2AMLogic/sky130-temp-por/spec/README.md

# spec

- [`porting-plan.md`](porting-plan.md) — what carries over from
  [`gf180-temp-por`](https://github.com/2AMLogic/gf180-temp-por)'s
  architecture and spec structure, what must be re-derived against sky130
  device models, and the PVT/ramp-rate testbench matrix the POR and sensor
  testbenches must cover before design starts. The first deliverable this
  repo produces — see the repo README and `CLAUDE.md`.
- [`decision-records/`](decision-records/) — one file per decision, using
  the format in `decision-records/TEMPLATE.md`. `DR-001` and `DR-002` are
  the two decisions the porting plan above required (supply flavor,
  architecture carryover); `DR-003` recommends the values for a future
  ratified `target-spec.md`, reconciled against the `sim/` evidence
  gathered since. `DR-001` and `DR-002` are `proposed`; `DR-003` is
  `ratified` (two-key path, issue #78), scoped to row 1 (operating
  temperature, −40…+125 °C) and row 6 (supply, 2.97–3.63 V per `DR-001`)
  only. All other rows stay `[TBD]` placeholders. `DR-006` is `proposed`
  (recommendation only, issue #136): it finds the Iq rows `[TBD-4..6]` not yet
  recommendable from the committed `sim/iq-top` evidence (17 of 45 iq-total
  points non-`ok`) and names the missing experiments.
- [`ratification/`](../ratification/) — the two-key ratification process
  (`market-key`, `ee-key`) `DR-003`'s recommendation and any future
  `target-spec.md` ratification goes through.

No `target-spec.md` exists yet — per the porting plan §4, that is a future
deliverable, populated from device-characterization evidence rather than
asserted ahead of it.
