2AMLogic/sky130-temp-por/design/temp_core.md

# `temp_core` — PTAT/CTAT temperature-sensing core (sky130 port)

Sky130 port of
[gf180-temp-por's `design/temp_core.sch`](https://github.com/2AMLogic/gf180-temp-por/blob/main/design/temp_core.md)
(issue #9 there), landed by issue #7 here as sub-issue 2 of 5 of the
T1-item-1 decomposition (see #5), depending on `bias_core` (issue #6).
Topology per
[DR-005](https://github.com/2AMLogic/gf180-temp-por/blob/main/spec/decision-records/DR-005-temp-por-architecture-survey.md)
("plain, not chopped, single-point 25 °C gain trim"), carried into this repo
by [DR-002](../spec/decision-records/DR-002-architecture-carryover.md);
device mapping per `spec/porting-plan.md` §2.2 and
[DR-001](../spec/decision-records/DR-001-supply-flavor.md).

**This is a mechanical, first-order port, not a characterized design.** See
[Scope and what this is not](#scope-and-what-this-is-not) before reading
anything below as a verified number.

## What this cell is

Unchanged in shape from gf180's `temp_core`: a ΔVBE/VBE bandgap-style
temperature-sensing core, deliberately left uncompensated so the PTAT term
is published raw. An 8:1 emitter-area vertical-PNP pair (`XQ1` : 1x,
`XQ8A..XQ8H` : 8x in parallel) sets `DVBE = (kT/q)*ln(8)`; an error amplifier
forces `V(NA) = V(NB)` so the branch current is `I = DVBE/R1` (PTAT by
construction); a matched third mirror leg drops that same current through
`R2` (fixed) + `R2TRIM` (the wave-1 single-point trim leg — see
[Trim mechanism](#trim-mechanism-simplified-for-this-port) below) into `VSS`,
giving `V(PTAT) = ((R2+R2TRIM)/R1)*(kT/q)*ln(8)`. `V(CTAT)` is `XQ1`'s own
`VEB` (the same node the branch-A leg drives), tapped out through a series
isolation resistor (`XRISO`) so pad capacitance never loads the loop node
directly. The cell has its own startup-kick/enable-gating band (current-
referenced dead-loop detector, the same class of mechanism `bias_core` uses)
and disable clamps so a disabled cell floats cleanly rather than leaking.
Everything below is a direct translation of gf180's own `design/temp_core.md`
topology description onto sky130 devices; read that document for the full
circuit-theory argument — none of the *architecture* is device-specific, so
it is not re-derived here.

## Interface

| Pin | Dir | Meaning |
| --- | --- | --- |
| `VDD`, `VSS` | inout | 3.3 V nominal supply pair on sky130 5V I/O-class devices (`g5v0d10v5`), 2.97–3.63 V ([DR-001](../spec/decision-records/DR-001-supply-flavor.md)), matching `bias_core` |
| `IBIAS` | in | shared bias-mirror node from `bias_core`. Per [DR-010](https://github.com/2AMLogic/gf180-temp-por/blob/main/spec/decision-records/DR-010-shared-ibias-disabled-consumer-contract.md) (carried from gf180, documented on `bias_core`'s own interface too): this pin is **high-Z, never clamped**, when the cell is disabled — a clamp here would starve the shared node for the entire pre-POR window |
| `EN` | in | enable, active high. Intended to be driven from `RESETn` once `temp_por_top` exists (issue #10), so the sensor is enabled only after POR releases (DR-002 startup ordering) — wired here per issue #7's own guidance even though the driving `RESETn` signal is not yet a committed cell. `EN` low: mirror gate `PG` to `VDD`, local bias node `NBG` to `VSS`, `PTAT`/`CTAT` pulled to `VSS`, `IBIAS` left high-Z |
| `PTAT` | out | analog PTAT output ([DR-002](../spec/decision-records/DR-002-architecture-carryover.md)). No output buffer in this cell (gf180's own `temp_buffer` is a separate, not-yet-ported cell) — a consuming testbench must specify a high-impedance load |
| `CTAT` | out | analog CTAT output (DR-002) = `VEB` of `XQ1`, tapped through `XRISO` |

## Device mapping (`spec/porting-plan.md` §2.2 / DR-001)

| Role | gf180 device | sky130 device | Notes |
| --- | --- | --- | --- |
| Amplifier, mirror, startup-kick, enable-gating MOS | `pfet_03v3`/`nfet_03v3` | `sky130_fd_pr__pfet_g5v0d10v5`/`nfet_g5v0d10v5` | Same 4-terminal (D,G,S,B) pin order as `bias_core`'s own devices, matching gf180's own pin layout — mechanical port. |
| VBE/ΔVBE sensing (8:1 ratio pair) | `pnp_10p00x10p00` | `sky130_fd_pr__pnp_05v5_W3p40L3p40` | Same choice as `bias_core` (issue #6): built as **eight parallel `X` instances**, not one `m`/`mult`-scaled instance — `mult` only scales sky130's PNP mismatch terms, not `Is`. |
| PTAT-gain resistor (`R1`, `R2`, `R2TRIM`), Miller-comp resistor (`RZ`), CTAT isolation (`RISO`) | `ppolyf_u` | `sky130_fd_pr__res_xhigh_po` | Same flavor `bias_core` uses for its own `R1`/`R2`/`RT`; `VREF`-independent ratio-tracking legs, so the flavor's absolute-TC spread cancels in-ratio. |
| Miller compensation cap (`CC`) | `cap_mim_2f0_m3m4_noshield` | `sky130_fd_pr__cap_mim_m3_1` | Same choice as `bias_core`. |

## Trim mechanism (simplified for this port)

gf180's own `temp_core` carries a **6-bit binary-weighted** trim ladder
(`R2T5..R2T0`) on the PTAT gain resistor, shorted segment-by-segment by
metal-strapped `nfet` switches — a metal-1 mask option, fuse/OTP-ready for
later, per gf180's own comment: *"a layout/process-portable mechanism, not a
device threshold"* (`spec/porting-plan.md` §1.1). Per issue #7's own scope
("represent as a trim node in the schematic; the physical strap-ladder
itself is layout scope"), this port collapses that to the **one net** a
layout-time metal strap would actually land on:

```
PTAT --[ R2 ]-- PTAT_TRIM --[ R2TRIM ]-- VSS
```

`R2` carries gf180's `R2F` value; `R2TRIM` carries the **sum** of gf180's
six segments (`R2T5+R2T4+R2T3+R2T2+R2T1+R2T0`), so the total (untrimmed)
`R2+R2TRIM` matches gf180's total gain resistor exactly, and the full trim
**range** a layout-time strap could remove is preserved — just as one
segment instead of six. `PTAT_TRIM` is left floating (untrimmed) in this
schematic; no switch transistors are instantiated. Sizing the physical
strap-ladder itself (bit count, granularity, the actual trim code) is layout
scope, deferred to a future issue.

## Sizing

**Every drawn `W`/`L` is carried over unchanged from gf180's ratified
`temp_core`** (bare micron numbers per this repo's own sky130 unit
convention — see `design/README.md`), same convention as `bias_core`
(issue #6):

- Ratio-derived quantities are exactly preserved by construction: the 8:1
  PNP emitter-count ratio, `RZ`/`R1`, and (per the simplified trim mechanism
  above) `(R2+R2TRIM)/R1` = (2652.6+450.88)/119.47 = 25.966, identical to
  gf180's own untrimmed `R2(nominal)/R1` ratio.
- The **absolute** PTAT slope, CTAT intercept, startup margins and
  compensation all depend on sky130's actual PNP `Is`/`BF`, MOS
  transconductance/threshold and resistor sheet resistance — none of which
  have been characterized against sky130 models in this repo yet
  (`spec/porting-plan.md` §2.5/§4 item 2). Per §1.3: this exact topology, on
  gf180mcu itself, measured **outside** its own accuracy targets under
  3-sigma mismatch
  ([DR-011-temp-accuracy-mismatch-not-met](https://github.com/2AMLogic/gf180-temp-por/blob/main/spec/decision-records/DR-011-temp-accuracy-mismatch-not-met.md)) —
  carrying the topology here is not a presumption it clears sky130's
  (not-yet-derived) accuracy target either.

## Verification done for this issue

Non-goals for issue #7 explicitly exclude layout, DRC/LVS, PVT corner
verification, Monte Carlo, characterization-grade sizing, and the physical
trim-strap ladder. What **is** verified here, as evidence the port is wired
correctly rather than merely textually plausible:

- `python3 design/netlist.py --cell temp_core` exports
  `design/netlist/temp_core.spice` with no xschem ERC/export errors.
- `python3 design/netlist.py --check` passes: both committed netlists
  (`bias_core`, `temp_core`) reproduce byte-for-byte and the
  symbol-pins-match-schematic-ports invariant holds for each.

### Branch selection: full-PVT transient evidence (issue #22), not a cold `.op` spot check

This section previously reported a 9-point cold-`.op` spot check (`tt`/`ff`/`ss`
× −40/27/125 °C, `EN` = `VDD`, `IBIAS` shared with a co-instantiated
`bias_core`) as evidence the ΔVBE loop reaches its intended branch. Issue #22
retired that method for `temp_core`, for exactly the reason
[issue #19](https://github.com/2AMLogic/sky130-temp-por/issues/19) retired it
for `bias_core`: a cold `.op` has no initial state, so which branch ngspice
reports is chosen by its own convergence-aid continuation rather than by the
circuit (see `sim/README.md` §"Branch selection" for the full house
methodology). The 9-point table is gone from this document; it is not a
retraction of the numbers (they were plausible and self-consistent), only of
the *claim* that a cold `.op` can establish which branch they came from.

The replacement is a physical `tran … uic` supply ramp from 0 V, run over the
full 45-point PVT matrix, in two scenarios (the `EN` axis `bias_core` does not
have):

- **`sim/temp-core-startup/`** — `EN` tied to `VDD`, asserted for the entire
  power-up ramp. Record
  [`20260826-053032-ee63b45`](../sim/temp-core-startup/records/20260826-053032-ee63b45.md):
  **42/45 PASS**. `PTAT` rises and `CTAT` falls monotonically with
  temperature at every passing corner, matching the previous spot check's
  values closely (e.g. `tt`/27 °C: `PTAT` = 1.414 V, `CTAT` = 0.658 V here vs.
  1.414 V / 0.658 V in the retired table) — the topology-correctness
  conclusion the old table supported still holds, now on firmer evidence.
  Three corners FAIL — `tt_-40c_3.30v`, `tt_125c_3.30v`, `ff_-40c_3.30v`, all
  at exactly the matrix's nominal 3.30 V supply point — with the same
  non-physical signature issue #19 used to prove the analogous `bias_core`
  artifact was a solver artifact rather than a second stable state: a
  negative settled supply current on one, and `PTAT` railed far outside
  every other corner's range (as far as +5 V, or negative) on the others,
  caught by this experiment's own `isup`-sign and `PTAT`-range guards. See
  that record's own manifest (`sim/temp-core-startup/experiment.json`
  `notes`) for the numerical-settings investigation behind that conclusion:
  re-running those three corners at a tighter tolerance recovers the intended
  branch, but re-running the *whole* matrix at that tighter tolerance moves
  the failure to a different, non-overlapping set of six corners — the same
  "change the solver, the failing set changes" signature `sim/bias-core-op-branch/`
  measured for `bias_core`, not a fixed defect at 3.30 V specifically.
- **`sim/temp-core-startup-en-delayed/`** — `VDD` ramps identically, but `EN`
  is held low until well after the supply has settled, then released — the
  DR-002 startup ordering `temp_core` will actually see once `temp_por_top`
  drives it from `RESETn`. Record
  [`20260826-054047-ee63b45`](../sim/temp-core-startup-en-delayed/records/20260826-054047-ee63b45.md):
  **42/45 PASS**, 3 different FAILing corners
  (`tt_27c_3.63v`, `tt_125c_3.63v`, `sf_-40c_2.97v`), same non-physical
  signature (negative supply current and/or a railed `PTAT`/`CTAT`), caught
  by the same guards. `temp_core`'s own startup kick clears the degenerate
  zero-current branch on a late `EN` release at the large majority of PVT
  points, not just when enabled for the whole ramp.

**Neither record is a claim that `temp_core` has a startup defect**, and
neither is edited or re-run to force a pass — per `sim/README.md`'s
append-only rule, a FAIL a full PVT sweep actually found is committed
evidence, not a blocker. Both FAILing sets show the textbook non-physical
signature (impossible supply-current sign, or a loop node/output railed
outside anything a passive network biased between `VSS` and `VDD` can
produce) that issue #19 established discriminates a solver artifact from a
real second equilibrium for this class of self-biased ΔVBE cell, and the set
of affected corners is not stable across reasonable changes to the
transient's own numerical settings — the same "solver-dependent, not
circuit" pattern `sim/bias-core-op-branch/` measured directly for `bias_core`.
The follow-up numerics sweep has since been run as
`sim/temp-core-startup-solver/` (issue #86): none of the six FAIL points
re-landed on the current netlist under any solver/ramp variant tested —
including the `base` deck control, which removes the deck-difference
alternative — every failure the sweep did produce is non-physical, and no
real failure was found anywhere in the matrix (record
[`20261010-200708-47b96e5`](../sim/temp-core-startup-solver/records/20261010-200708-47b96e5.md),
superseding `20261010-100955-292949a`).

## Scope and what this is not

Per issue #7's non-goals: **not** layout, DRC/LVS, PVT corner verification,
Monte Carlo, characterization-grade sizing, or the physical trim-strap
ladder (see [Trim mechanism](#trim-mechanism-simplified-for-this-port)
above). Re-sizing once sky130 device characterization lands
(`spec/porting-plan.md` §4 item 2) is expected follow-on work, not a defect
in this port — do not read any voltage, slope or current figure in this
document as a ratified or even provisional target; `spec/target-spec.md`
does not exist yet in this repo (`spec/porting-plan.md` §4 item 4).
