2AMLogic/sky130-temp-por/WORK_PLAN.md

# Work Plan

Current roadmap derived from GitHub label state. The region below is maintained by the Loom Guide role.

<!-- guide:plan-body:start -->
## Operator Attention: Merge-Risk-Hold Pileup

Judge-approved PRs under a hold (`loom:blocked` or `loom:operator`) — only a human merge decision is missing.

_None._

## Very Important

`loom:very-important` (one counts per workspace); every stage takes these first.

_None._

## Important

`loom:important`; taken before unlabelled work.

_None._

## Ready

Human-approved issues ready for implementation (`loom:issue`).

- **#191**: Remove docs/guard-repro reproducer: stale, unreferenced test of a Loom-managed hook

## In Progress

Issues currently being built (`loom:building`).

- **#284**: sim: measure DR-007's degenerated-mirror projection with a mirror-term MC variant run

## PRs Awaiting Review

PRs waiting on Judge (`loom:review-requested`).

_None._

## Approved (Awaiting Merge)

PRs that passed review and are queued for Champion auto-merge (`loom:pr`).

_None._

## Proposed

Issues carrying `loom:curated`.

- **#4**: Track the gap to T1 sim-validated / bronze (klayout-tools design-evidence tiers) *(curated)*
- **#97**: Lay out por_output_chain as the next DRC/LVS-verified POR leaf *(curated)*
- **#153**: brownout-top: re-grade NONPHYSICAL brown-out points with a tightened-solver fleet re-run *(curated)*
- **#181**: glitch-top: re-run failed vdd_level request vdd_slew_v1.2_h0.0002_s200000 (45 ERROR points) *(curated)*
- **#189**: Re-qualify cited sky130 evidence under open_pdks f6eeac7 (split from #188) *(curated)*
- **#191**: Remove docs/guard-repro reproducer: stale, unreferenced test of a Loom-managed hook *(curated)*
- **#284**: sim: measure DR-007's degenerated-mirror projection with a mirror-term MC variant run *(curated)*

## Proposed (Architect / Hermit)

- **#137**: Run the two-key ratification ceremony on DR-004 and DR-005 *(architect)*

## Epics

- **#4**: Track the gap to T1 sim-validated / bronze (klayout-tools design-evidence tiers)

## Backlog Balance

| Bucket | Count |
|---|---|
| Operator merge-risk holds | 0 |
| Very important | 0 |
| Important | 0 |
| Ready (`loom:issue`) | 1 |
| In Progress (`loom:building`) | 1 |
| PRs awaiting review | 0 |
| Approved PRs awaiting merge | 0 |
| Curated | 7 |
| Architect / Hermit proposals | 1 |
| Active epics | 1 |
<!-- guide:plan-body:end -->
