2AMLogic/sky130-temp-por/manifests/artifacts/glitch-top-20261113-082829-da28d31-vdd_level-rerun181.summary.md

# Stored evidence: glitch-top / 20261113-082829-da28d31-vdd_level-rerun181

Raw outputs are in the fleet artifact store (private); this summary and
`glitch-top-20261113-082829-da28d31-vdd_level-rerun181.manifest.json` are the committed record. Check the bytes
with `klt artifact verify manifests/artifacts/glitch-top-20261113-082829-da28d31-vdd_level-rerun181.manifest.json`.

| name | size (bytes) | sha256 |
|---|---:|---|
| `sim/.work/.stage/glitch-top/20261113-082829-da28d31-vdd_level-rerun181/vdd_slew_v1.2_h0.0002_s200000/ff_-40c_2.97v.log` | 6429 | `05fcc509f06a0b0329f5d6170ae3cead8c08df4df788f5f16296d26571690c44` |
| `sim/.work/.stage/glitch-top/20261113-082829-da28d31-vdd_level-rerun181/vdd_slew_v1.2_h0.0002_s200000/ff_-40c_2.97v.trace.csv.gz` | 3619 | `1fba09b0852c2e07f1603e4c9942d356a4d9621a56d4e5da9ca1e6318bb8a1bd` |
| `sim/.work/.stage/glitch-top/20261113-082829-da28d31-vdd_level-rerun181/vdd_slew_v1.2_h0.0002_s200000/ff_-40c_3.30v.log` | 6429 | `e192acfe9f427a0010f5f91e1e251b4c581f8494c019e1e538131d7f61810195` |
| `sim/.work/.stage/glitch-top/20261113-082829-da28d31-vdd_level-rerun181/vdd_slew_v1.2_h0.0002_s200000/ff_-40c_3.30v.trace.csv.gz` | 3845 | `41f2ee7448445d5f04d06677372713f7a5353468ea329cacd7c6c7f49039e3c3` |
| `sim/.work/.stage/glitch-top/20261113-082829-da28d31-vdd_level-rerun181/vdd_slew_v1.2_h0.0002_s200000/ff_-40c_3.63v.log` | 6430 | `b0a8ba8f35210c539fea7abc34406f49456061d0387ca0e15f699d3141d2916a` |
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
| `sim/.work/.stage/glitch-top/20261113-082829-da28d31-vdd_level-rerun181/vdd_slew_v1.2_h0.0002_s200000/tt_27c_3.63v.trace.csv.gz` | 5135 | `4e996fe1bf50d0cbd19262e184f64ce5dadb78d6a44e1b736044b76ee3dbc2fe` |
