2AMLogic/sky130-temp-por/sim/pnp-mismatch/records/20261113-160939-9211b20a.md

# Record 20261113-160939-9211b20a

- **Record ID**: 20261113-160939-9211b20a
- **Experiment**: `pnp-mismatch` — Substrate PNP pair mismatch -- sigma(dVBE) by local + global-process Monte Carlo
- **Claim**: Issue #17 -- sim-harness port. Confirms sky130's local-mismatch (MC_MM_SWITCH=1) AND global-process-Monte-Carlo (MC_PR_SWITCH=1) mechanisms both produce non-degenerate samples against THIS repo's own PNP topology -- a single `sky130_fd_pr__pnp_05v5_W3p40L3p40` vs. the real 1-vs-8-parallel array bias_core/temp_core actually use, not a re-run of sky130-bandgap's own small/large device-size pair. **This record makes no spec pass/fail claim** -- no ratified spec exists yet (spec/porting-plan.md Sec4 item 4); it reports measured distributions plus the harness checks that make them trustworthy, per issue #17's own acceptance criteria.
- **Netlist provenance**: schematic (`sim/pnp-mismatch/testbench/tb_pnp_mismatch.spice`)
- **PDK**: sky130A @ open_pdks `f6eeac7dad085ffcc829ccfd721f7b4ce39edcf7` (matches sim/pdk.json pin); models `$PDK_ROOT/sky130A/libs.tech/combined/sky130.lib.spice`
- **Tools**: ngspice-47 : Circuit level simulation program (host; the grid ran on the fleet); XSCHEM V3.4.7; Linux 7.0.0-1014-aws x86_64
- **Repo state**: `9211b20a` on `feature/issue-319` (clean working tree)
- **Backend**: `klt sim --backend batch` deck-list request (fleet job `klt-sim-24f5caeb77f1`, m7i.4xlarge in us-east-1, report status `pass`: 6/6 unit(s) passed, 0 errored, 0 timed out); fleet runner klt `0.9.0`, client `klt 0.9.2.dev887+gec7400b7d8e5`, `--wait-for-capacity 600`
- **Fleet engine**: ngspice-47 (per-point, from each unit's own log banner)
- **Sampling method**: in-deck `.control` dowhile/reset loop inside ONE ngspice process, seeded by `setseed $mc_seed` from the shipped `.spiceinit` -- the SAME method this experiment's earlier records were minted by, carried to the fleet unchanged by the `decks[]` transport rather than re-expressed as a klt `monte_carlo` block (which would draw the samples differently; issue #319 risk item 2)
- **Transport**: submitted as a `klt sim` deck-list (`decks[]`) request, the transport klt documents for a harness that renders its own decks and mints its own evidence from the raw logs (klayout-tools #2804): each point's deck is shipped byte-for-byte and run as `ngspice -b <deck>` in its own directory on the fleet worker, so the artifact is the one this harness mints rather than one klt re-composed from a corner axis. The per-point `.spiceinit` rides as a `decks[].inputs[]` entry, which is how a setting the fleet drops from `options.ngspice_init` still reaches the run
- **Corner matrix run**:
  - Process: `tt_mm` (local mismatch, MC_MM_SWITCH=1), `tt` (control, both switches 0), `mc` (global process Monte Carlo, MC_PR_SWITCH=1) -- see the module docstring for why local mismatch is not stacked on the deterministic tt/ss/ff/sf/fs process axis (would double-count the global spread a future characterization issue's own process-corner sweep already records).
  - Temperature: -40 °C, 27 °C, 125 °C (full CLAUDE.md temperature axis for the local-mismatch sweep; the process-mc liveness point runs at 27 °C only)
  - Supply: **not applicable**. Every DUT is a diode-connected substrate PNP referred to its own emitter node and biased by an ideal current source; there is no supply-referenced terminal. Point ids carry `nosupply` in the supply field.
  - 6 ngspice points executed: 3 local-mismatch Monte Carlo points (N = 300 each), one MC_MM_SWITCH/MC_PR_SWITCH-off control point, one second-seed point, one MC_PR_SWITCH=1 liveness point.
- **Statistical convention**: **N = 300** Monte Carlo samples per local-mismatch temperature point (section `tt_mm`: `MC_MM_SWITCH=1`, `MC_PR_SWITCH=0`, `mismatch_factor=1`); the `mc` liveness point uses N = 30. Spread is reported as **1 σ** sample standard deviation (N−1). Reproducible: `setseed 20260825` (the second-seed point uses 20260826).
- **Result**: PASS — see the tables below.

## What the sky130 PDK actually does for BJT mismatch / process Monte Carlo

Verified against the pinned PDK (already confirmed once, on the same PDK pin, by sky130-bandgap's own sim/pnp-mismatch/). In `libs.tech/combined/continuous/models_bjt.spice` each PNP subcircuit carries a **per-instance** mismatch term gated by `MC_MM_SWITCH`:

```
.param mm_is = {sw_mm_sky130_fd_pr__pnp_05v5_W0p68L0p68_is
               * mismatch_factor * MC_MM_SWITCH * AGAUSS(0,1.0,1)/sqrt(mult)}
  is  = '... * (1+mm_is)'   (W3p40L3p40 scales the W0p68L0p68 coefficient by 0.13)
```

with the sigmas in `continuous/models_global.spice`: `..._is = 1.662e-02` (1.662% on Is) and `..._bf = 5.537e-02` (5.537% on Bf). `AGAUSS()` sits inside the subcircuit, so each instance draws independently -- confirmed empirically below by the array1v8 pair's own sigma landing near 1/sqrt(8) of the identical pair's.

By contrast, `MC_PR_SWITCH`-gated terms (`libs.tech/combined/continuous/parameters_*.spice`, e.g. `sw_nw_rs_mult`) are `.param`-scoped **globally**, not per subcircuit instance -- every device in one ngspice run sees the identical draw. That is why this record's `process-mc` point checks each device's own *absolute* VEB for nonzero sigma rather than the pair *difference*: the difference is expected to cancel by construction (common-mode across co-located devices), and a differential-only check would have missed a genuinely-working `MC_PR_SWITCH` (the naive mistake this record's own module docstring calls out).

## Pair ΔVBE distribution (N = 300 per local-mismatch point)

| Pair | Bias/device | T (°C) | mean ΔVBE (mV) | 1 σ (mV) | 3 σ (mV) | worst sample \|ΔVBE\| (mV) |
|---|---|---|---|---|---|---|
| identical: `sky130_fd_pr__pnp_05v5_W3p40L3p40 x2` | 1 µA | -40 | -0.0089 | 0.1161 | 0.3482 | 0.3942 |
| identical: `sky130_fd_pr__pnp_05v5_W3p40L3p40 x2` | 1 µA | 27 | -0.0039 | 0.0964 | 0.2891 | 0.2703 |
| identical: `sky130_fd_pr__pnp_05v5_W3p40L3p40 x2` | 1 µA | 125 | +0.0066 | 0.1802 | 0.5407 | 0.5802 |
| identical: `sky130_fd_pr__pnp_05v5_W3p40L3p40 x2` | 10 µA | -40 | -0.0096 | 0.1279 | 0.3836 | 0.3950 |
| identical: `sky130_fd_pr__pnp_05v5_W3p40L3p40 x2` | 10 µA | 27 | -0.0054 | 0.0989 | 0.2966 | 0.2710 |
| identical: `sky130_fd_pr__pnp_05v5_W3p40L3p40 x2` | 10 µA | 125 | +0.0029 | 0.1848 | 0.5544 | 0.6069 |
| array1v8: `sky130_fd_pr__pnp_05v5_W3p40L3p40 1x vs 8x parallel` | 1 µA | -40 | +42.2560 | 0.0943 | 0.2829 | 42.5331 |
| array1v8: `sky130_fd_pr__pnp_05v5_W3p40L3p40 1x vs 8x parallel` | 1 µA | 27 | +54.4236 | 0.0773 | 0.2318 | 54.5970 |
| array1v8: `sky130_fd_pr__pnp_05v5_W3p40L3p40 1x vs 8x parallel` | 1 µA | 125 | +72.2836 | 0.1355 | 0.4065 | 72.6800 |
| array1v8: `sky130_fd_pr__pnp_05v5_W3p40L3p40 1x vs 8x parallel` | 10 µA | -40 | +42.5376 | 0.0848 | 0.2545 | 42.7633 |
| array1v8: `sky130_fd_pr__pnp_05v5_W3p40L3p40 1x vs 8x parallel` | 10 µA | 27 | +54.8779 | 0.0668 | 0.2005 | 55.0565 |
| array1v8: `sky130_fd_pr__pnp_05v5_W3p40L3p40 1x vs 8x parallel` | 10 µA | 125 | +73.1027 | 0.1384 | 0.4151 | 73.4026 |

The three temperatures share one seed, so they are the *same* device draws re-solved at a different temperature (common random numbers) — the three rows of a pair are not independent estimates of σ.

## Sanity: measured σ vs the PDK's own coefficients

First-order prediction from the Is-mismatch coefficient alone, generalized to the 1-vs-8-parallel array by a central-limit 1/sqrt(n) argument (see `analytic_sigma()`'s docstring) -- an *order-of-magnitude* agreement here rules out the failure mode where the spread comes from somewhere other than the intended per-instance mismatch terms.

| Pair | T (°C) | predicted σ (mV) | measured σ (mV) | ratio |
|---|---|---|---|---|
| identical, 1 µA | -40 | 0.0614 | 0.1161 | 1.89 |
| identical, 1 µA | 27 | 0.0790 | 0.0964 | 1.22 |
| identical, 1 µA | 125 | 0.1048 | 0.1802 | 1.72 |
| identical, 10 µA | -40 | 0.0614 | 0.1279 | 2.08 |
| identical, 10 µA | 27 | 0.0790 | 0.0989 | 1.25 |
| identical, 10 µA | 125 | 0.1048 | 0.1848 | 1.76 |
| array1v8, 1 µA | -40 | 0.0460 | 0.0943 | 2.05 |
| array1v8, 1 µA | 27 | 0.0593 | 0.0773 | 1.30 |
| array1v8, 1 µA | 125 | 0.0786 | 0.1355 | 1.72 |
| array1v8, 10 µA | -40 | 0.0460 | 0.0848 | 1.84 |
| array1v8, 10 µA | 27 | 0.0593 | 0.0668 | 1.13 |
| array1v8, 10 µA | 125 | 0.0786 | 0.1384 | 1.76 |

## Controls (the reason this record can be believed)

- **Both-switches-off control** (`tt_27c_nosupply_mm-off`, section `tt`, N = 30): identical deck with `MC_MM_SWITCH=0`, `MC_PR_SWITCH=0`. σ(da1) = 0 V, σ(da10) = 0 V, σ(dr1) = 7.06e-18 V, σ(dr10) = 0 V — exactly zero, so the spread reported above is the mismatch switch and not solver noise or a re-randomised bias point.
- **Second-seed point** (`tt_mm_27c_nosupply_seed-b`, `setseed 20260826`, N = 300): σ(da1) = 0.1002 mV; σ(da10) = 0.0959 mV; σ(dr1) = 0.0727 mV; σ(dr10) = 0.0715 mV — see the seed-stability checks below: the individual samples change, σ does not.
- **MC_PR_SWITCH=1 liveness point** (`mc_27c_nosupply`, section `mc`, N = 30): pair differences stay near zero (common-mode cancellation, expected -- see the mechanism note above) while each device's own absolute VEB shows nonzero sigma σ(vr1a) = 39.32 µV; σ(vr1b) = 19.41 µV; σ(vr10a) = 44.87 µV; σ(vr10b) = 15.76 µV — proof the global-process switch reached the models on THIS repo's own netlist, not just sky130-bandgap's.

## Checks

- `tt_mm_-40c_nosupply` (mismatch): **PASS**
  - PASS `sample_count` — parsed 300 samples, expected 300
  - PASS `sigma_nonzero[da1]` — sigma = 0.1161 mV (must be > 0: a zero here means the mismatch switch never reached the models)
  - PASS `analytic_band[da1]` — sigma/predicted = 1.89 (measured 0.1161 mV vs first-order PDK-coefficient prediction 0.0614 mV; band 0.4-2.5)
  - PASS `zero_mean[da1]` — |mean| = 0.0089 mV vs 4*sigma/sqrt(N) = 0.0268 mV (an identical pair has no systematic offset)
  - PASS `sigma_nonzero[da10]` — sigma = 0.1279 mV (must be > 0: a zero here means the mismatch switch never reached the models)
  - PASS `analytic_band[da10]` — sigma/predicted = 2.08 (measured 0.1279 mV vs first-order PDK-coefficient prediction 0.0614 mV; band 0.4-2.5)
  - PASS `zero_mean[da10]` — |mean| = 0.0096 mV vs 4*sigma/sqrt(N) = 0.0295 mV (an identical pair has no systematic offset)
  - PASS `sigma_nonzero[dr1]` — sigma = 0.0943 mV (must be > 0: a zero here means the mismatch switch never reached the models)
  - PASS `analytic_band[dr1]` — sigma/predicted = 2.05 (measured 0.0943 mV vs first-order PDK-coefficient prediction 0.0460 mV; band 0.4-2.5)
  - PASS `signal_vs_sigma[dr1]` — sigma/|mean dVBE| = 0.0022 (mismatch spread 0.0943 mV against a 42.256 mV PTAT signal from the 1-vs-8-parallel array's own VT*ln(8) term; must be <= 0.05)
  - PASS `sigma_nonzero[dr10]` — sigma = 0.0848 mV (must be > 0: a zero here means the mismatch switch never reached the models)
  - PASS `analytic_band[dr10]` — sigma/predicted = 1.84 (measured 0.0848 mV vs first-order PDK-coefficient prediction 0.0460 mV; band 0.4-2.5)
  - PASS `signal_vs_sigma[dr10]` — sigma/|mean dVBE| = 0.0020 (mismatch spread 0.0848 mV against a 42.538 mV PTAT signal from the 1-vs-8-parallel array's own VT*ln(8) term; must be <= 0.05)
- `tt_mm_27c_nosupply` (mismatch): **PASS**
  - PASS `sample_count` — parsed 300 samples, expected 300
  - PASS `sigma_nonzero[da1]` — sigma = 0.0964 mV (must be > 0: a zero here means the mismatch switch never reached the models)
  - PASS `analytic_band[da1]` — sigma/predicted = 1.22 (measured 0.0964 mV vs first-order PDK-coefficient prediction 0.0790 mV; band 0.4-2.5)
  - PASS `zero_mean[da1]` — |mean| = 0.0039 mV vs 4*sigma/sqrt(N) = 0.0223 mV (an identical pair has no systematic offset)
  - PASS `sigma_nonzero[da10]` — sigma = 0.0989 mV (must be > 0: a zero here means the mismatch switch never reached the models)
  - PASS `analytic_band[da10]` — sigma/predicted = 1.25 (measured 0.0989 mV vs first-order PDK-coefficient prediction 0.0790 mV; band 0.4-2.5)
  - PASS `zero_mean[da10]` — |mean| = 0.0054 mV vs 4*sigma/sqrt(N) = 0.0228 mV (an identical pair has no systematic offset)
  - PASS `sigma_nonzero[dr1]` — sigma = 0.0773 mV (must be > 0: a zero here means the mismatch switch never reached the models)
  - PASS `analytic_band[dr1]` — sigma/predicted = 1.30 (measured 0.0773 mV vs first-order PDK-coefficient prediction 0.0593 mV; band 0.4-2.5)
  - PASS `signal_vs_sigma[dr1]` — sigma/|mean dVBE| = 0.0014 (mismatch spread 0.0773 mV against a 54.424 mV PTAT signal from the 1-vs-8-parallel array's own VT*ln(8) term; must be <= 0.05)
  - PASS `sigma_nonzero[dr10]` — sigma = 0.0668 mV (must be > 0: a zero here means the mismatch switch never reached the models)
  - PASS `analytic_band[dr10]` — sigma/predicted = 1.13 (measured 0.0668 mV vs first-order PDK-coefficient prediction 0.0593 mV; band 0.4-2.5)
  - PASS `signal_vs_sigma[dr10]` — sigma/|mean dVBE| = 0.0012 (mismatch spread 0.0668 mV against a 54.878 mV PTAT signal from the 1-vs-8-parallel array's own VT*ln(8) term; must be <= 0.05)
- `tt_mm_125c_nosupply` (mismatch): **PASS**
  - PASS `sample_count` — parsed 300 samples, expected 300
  - PASS `sigma_nonzero[da1]` — sigma = 0.1802 mV (must be > 0: a zero here means the mismatch switch never reached the models)
  - PASS `analytic_band[da1]` — sigma/predicted = 1.72 (measured 0.1802 mV vs first-order PDK-coefficient prediction 0.1048 mV; band 0.4-2.5)
  - PASS `zero_mean[da1]` — |mean| = 0.0066 mV vs 4*sigma/sqrt(N) = 0.0416 mV (an identical pair has no systematic offset)
  - PASS `sigma_nonzero[da10]` — sigma = 0.1848 mV (must be > 0: a zero here means the mismatch switch never reached the models)
  - PASS `analytic_band[da10]` — sigma/predicted = 1.76 (measured 0.1848 mV vs first-order PDK-coefficient prediction 0.1048 mV; band 0.4-2.5)
  - PASS `zero_mean[da10]` — |mean| = 0.0029 mV vs 4*sigma/sqrt(N) = 0.0427 mV (an identical pair has no systematic offset)
  - PASS `sigma_nonzero[dr1]` — sigma = 0.1355 mV (must be > 0: a zero here means the mismatch switch never reached the models)
  - PASS `analytic_band[dr1]` — sigma/predicted = 1.72 (measured 0.1355 mV vs first-order PDK-coefficient prediction 0.0786 mV; band 0.4-2.5)
  - PASS `signal_vs_sigma[dr1]` — sigma/|mean dVBE| = 0.0019 (mismatch spread 0.1355 mV against a 72.284 mV PTAT signal from the 1-vs-8-parallel array's own VT*ln(8) term; must be <= 0.05)
  - PASS `sigma_nonzero[dr10]` — sigma = 0.1384 mV (must be > 0: a zero here means the mismatch switch never reached the models)
  - PASS `analytic_band[dr10]` — sigma/predicted = 1.76 (measured 0.1384 mV vs first-order PDK-coefficient prediction 0.0786 mV; band 0.4-2.5)
  - PASS `signal_vs_sigma[dr10]` — sigma/|mean dVBE| = 0.0019 (mismatch spread 0.1384 mV against a 73.103 mV PTAT signal from the 1-vs-8-parallel array's own VT*ln(8) term; must be <= 0.05)
- `tt_27c_nosupply_mm-off` (control): **PASS**
  - PASS `sample_count` — parsed 30 samples, expected 30
  - PASS `sigma_zero[da1]` — sigma = 0 V with MC_MM_SWITCH=0, MC_PR_SWITCH=0 (must be <= 1e-09 V -- a floating-point-noise floor, not a real-mismatch tolerance: the array1v8 pair's 8-parallel-device node sum is not always bit-identical run-to-run even with both switches off, but stays ~9 orders of magnitude below any measured real-mismatch sigma above)
  - PASS `sigma_zero[da10]` — sigma = 0 V with MC_MM_SWITCH=0, MC_PR_SWITCH=0 (must be <= 1e-09 V -- a floating-point-noise floor, not a real-mismatch tolerance: the array1v8 pair's 8-parallel-device node sum is not always bit-identical run-to-run even with both switches off, but stays ~9 orders of magnitude below any measured real-mismatch sigma above)
  - PASS `sigma_zero[dr1]` — sigma = 7.05752e-18 V with MC_MM_SWITCH=0, MC_PR_SWITCH=0 (must be <= 1e-09 V -- a floating-point-noise floor, not a real-mismatch tolerance: the array1v8 pair's 8-parallel-device node sum is not always bit-identical run-to-run even with both switches off, but stays ~9 orders of magnitude below any measured real-mismatch sigma above)
  - PASS `sigma_zero[dr10]` — sigma = 0 V with MC_MM_SWITCH=0, MC_PR_SWITCH=0 (must be <= 1e-09 V -- a floating-point-noise floor, not a real-mismatch tolerance: the array1v8 pair's 8-parallel-device node sum is not always bit-identical run-to-run even with both switches off, but stays ~9 orders of magnitude below any measured real-mismatch sigma above)
- `tt_mm_27c_nosupply_seed-b` (seed-check): **PASS**
  - PASS `sample_count` — parsed 300 samples, expected 300
  - PASS `sigma_nonzero[da1]` — sigma = 0.1002 mV (must be > 0: a zero here means the mismatch switch never reached the models)
  - PASS `analytic_band[da1]` — sigma/predicted = 1.27 (measured 0.1002 mV vs first-order PDK-coefficient prediction 0.0790 mV; band 0.4-2.5)
  - PASS `zero_mean[da1]` — |mean| = 0.0051 mV vs 4*sigma/sqrt(N) = 0.0231 mV (an identical pair has no systematic offset)
  - PASS `sigma_nonzero[da10]` — sigma = 0.0959 mV (must be > 0: a zero here means the mismatch switch never reached the models)
  - PASS `analytic_band[da10]` — sigma/predicted = 1.21 (measured 0.0959 mV vs first-order PDK-coefficient prediction 0.0790 mV; band 0.4-2.5)
  - PASS `zero_mean[da10]` — |mean| = 0.0017 mV vs 4*sigma/sqrt(N) = 0.0222 mV (an identical pair has no systematic offset)
  - PASS `sigma_nonzero[dr1]` — sigma = 0.0727 mV (must be > 0: a zero here means the mismatch switch never reached the models)
  - PASS `analytic_band[dr1]` — sigma/predicted = 1.23 (measured 0.0727 mV vs first-order PDK-coefficient prediction 0.0593 mV; band 0.4-2.5)
  - PASS `signal_vs_sigma[dr1]` — sigma/|mean dVBE| = 0.0013 (mismatch spread 0.0727 mV against a 54.428 mV PTAT signal from the 1-vs-8-parallel array's own VT*ln(8) term; must be <= 0.05)
  - PASS `sigma_nonzero[dr10]` — sigma = 0.0715 mV (must be > 0: a zero here means the mismatch switch never reached the models)
  - PASS `analytic_band[dr10]` — sigma/predicted = 1.21 (measured 0.0715 mV vs first-order PDK-coefficient prediction 0.0593 mV; band 0.4-2.5)
  - PASS `signal_vs_sigma[dr10]` — sigma/|mean dVBE| = 0.0013 (mismatch spread 0.0715 mV against a 54.875 mV PTAT signal from the 1-vs-8-parallel array's own VT*ln(8) term; must be <= 0.05)
- `mc_27c_nosupply` (process-mc): **PASS**
  - PASS `sample_count` — parsed 30 samples, expected 30
  - PASS `diff_near_zero[da1]` — sigma(da1) = 0.0711 mV with MC_PR_SWITCH=1 (global, common-mode across co-located devices in the same run -- expected near zero, tolerance 0.5 mV)
  - PASS `diff_near_zero[da10]` — sigma(da10) = 0.0657 mV with MC_PR_SWITCH=1 (global, common-mode across co-located devices in the same run -- expected near zero, tolerance 0.5 mV)
  - PASS `diff_near_zero[dr1]` — sigma(dr1) = 0.0486 mV with MC_PR_SWITCH=1 (global, common-mode across co-located devices in the same run -- expected near zero, tolerance 0.5 mV)
  - PASS `diff_near_zero[dr10]` — sigma(dr10) = 0.0502 mV with MC_PR_SWITCH=1 (global, common-mode across co-located devices in the same run -- expected near zero, tolerance 0.5 mV)
  - PASS `abs_nonzero[vr1a]` — sigma(vr1a) = 39.319 uV across the MC_PR_SWITCH=1 loop (must be >= 1 uV: a zero here means the global-process switch never reached the models)
  - PASS `abs_nonzero[vr1b]` — sigma(vr1b) = 19.407 uV across the MC_PR_SWITCH=1 loop (must be >= 1 uV: a zero here means the global-process switch never reached the models)
  - PASS `abs_nonzero[vr10a]` — sigma(vr10a) = 44.867 uV across the MC_PR_SWITCH=1 loop (must be >= 1 uV: a zero here means the global-process switch never reached the models)
  - PASS `abs_nonzero[vr10b]` — sigma(vr10b) = 15.764 uV across the MC_PR_SWITCH=1 loop (must be >= 1 uV: a zero here means the global-process switch never reached the models)
- PASS `seed_sigma_stable[da1]` — sigma(seed 20260826) / sigma(seed 20260825) = 1.039 (0.1002 mV vs 0.0964 mV; tolerance +/-25%)
- PASS `seed_sample_differs[da1]` — worst-sample magnitude differs between the two seeds (0.2703 mV vs 0.3194 mV), i.e. the draw really did change
- PASS `seed_sigma_stable[da10]` — sigma(seed 20260826) / sigma(seed 20260825) = 0.970 (0.0959 mV vs 0.0989 mV; tolerance +/-25%)
- PASS `seed_sample_differs[da10]` — worst-sample magnitude differs between the two seeds (0.2710 mV vs 0.2778 mV), i.e. the draw really did change
- PASS `seed_sigma_stable[dr1]` — sigma(seed 20260826) / sigma(seed 20260825) = 0.941 (0.0727 mV vs 0.0773 mV; tolerance +/-25%)
- PASS `seed_sample_differs[dr1]` — worst-sample magnitude differs between the two seeds (54.5970 mV vs 54.6150 mV), i.e. the draw really did change
- PASS `seed_sigma_stable[dr10]` — sigma(seed 20260826) / sigma(seed 20260825) = 1.070 (0.0715 mV vs 0.0668 mV; tolerance +/-25%)
- PASS `seed_sample_differs[dr10]` — worst-sample magnitude differs between the two seeds (55.0565 mV vs 55.0771 mV), i.e. the draw really did change
- **Overall: PASS**

## Divergences from sky130-bandgap's own sim/pnp-mismatch/ precedent

1. **Device pairs.** The precedent pairs the small (`W0p68L0p68`) and large (`W3p40L3p40`) fixed PNP sizes -- this design uses ONLY the large size (design/bias_core.md), so this record's `array1v8` pair reproduces the design's real 1-vs-8-parallel array topology (`XQ1` vs `XQ8A..XQ8H`) instead.
2. **MC_PR_SWITCH coverage.** Added beyond the precedent: a `process-mc` point, per issue #17's own acceptance criteria (confirm BOTH MC_MM_SWITCH and MC_PR_SWITCH produce non-degenerate samples against this repo's own netlists).
3. **Terminal connection.** Same convention as the precedent: this deck drives the **emitter** (collector and base grounded), matching how bias_core/temp_core actually connect their PNPs (`X<name> VSS VSS <node> ...`).
4. **N, seed, bias points.** N = 300 and the 1 µA / 10 µA per-device bias rungs match sky130-bandgap's own record for cross-repo comparability; this repo's own per-branch bias currents have not been characterized against sky130 models yet (spec/porting-plan.md Sec4 item 2).

- **Links**:
  - testbench: `sim/pnp-mismatch/testbench/tb_pnp_mismatch.spice`
  - run_script: `sim/pnp-mismatch/run_pnp_mismatch.py`
  - netlist_snapshot: `sim/pnp-mismatch/netlist-snapshots/20261113-160939-9211b20a.spice`
  - raw_logs: `sim/pnp-mismatch/corners/20261113-160939-9211b20a/`
  - klt_report: `sim/pnp-mismatch/corners/20261113-160939-9211b20a/batch/report.json`
  - json_record: `sim/pnp-mismatch/records/20261113-160939-9211b20a.json`
  - record: `sim/pnp-mismatch/records/20261113-160939-9211b20a.md`
- **Timestamp / author**: 2026-11-13T16:09:39Z, 313063438+loom-fleet-dispatch[bot]@users.noreply.github.com
- **Supersedes**: (none — first record for this claim)

Written by `sim/pnp-mismatch/run_pnp_mismatch.py`. Append-only: never edit this file — a correction is a new record with a `Supersedes` field (see `sim/README.md`).
