2AMLogic/sky130-temp-por/sim/glitch-top/records/20261113-082829-da28d31-por_raw_inject-rerun181.md

# Record 20261113-082829-da28d31-por_raw_inject-rerun181

- **Record ID**: 20261113-082829-da28d31-por_raw_inject-rerun181
- **Experiment**: `glitch-top` — Assembled temp_por_top glitch immunity as two separately reported classes: POR_RAW-domain pulse injection (instrumented) and VDD-level supply glitches (unmodified), over the PVT grid
- **Glitch class (this record covers ONLY this class)**: `por_raw_inject` -- POR_RAW-domain pulse injection (instrumented assembly). exercise the deglitch dwell of por_output_chain directly (spec/porting-plan.md Sec3.5 axis 1); the VDD rail is a clean power-up ramp
- **Evidence kind**: INSTRUMENTED assembly -- two instrument lines are spliced into the DUT subckt (see Injection). This is NOT as-drawn immunity evidence.
- **Claim**: Issue #117 (child of #106; completes the porting-plan Sec3.5 scope next to brownout-top) -- NOT a spec claim: no ratified numeric glitch envelope exists (DR-003 Sec8) and no gf180mcu number is used. Two glitch classes are stimulated, graded and summarised SEPARATELY on the committed design/netlist/temp_por_top.spice (bias_core + temp_core + por_comparator + por_output_chain, real shared IBIAS node, real RESETn -> temp_core.EN feedback, no ideal bias/sensor substitution, PTAT/CTAT open, committed XMN1 L=20 W=0.42, no retired diagnostic edit): (A) por_raw_inject -- a finite-impedance pulse injected into the POR_RAW node through an instrument element spliced into the DUT subckt, so it is INSTRUMENTED-assembly evidence, not as-drawn; the comparator stays connected and no-injection controls are retained; (B) vdd_level -- a symmetric-edge supply glitch on the UNMODIFIED assembly. Each is run across {tt,ss,ff,sf,fs} x {-40,27,125 C} x {2.97,3.30,3.63 V} starting supplies and graded from full-resolution RESETn/POR_RAW/VDD/IBIAS-node waveforms and the explicit delivered bias branch current (sim/glitch-top/glitch_checker.py). A completed simulation is not a behavioural PASS; failed cells are evidence.
- **Netlist provenance**: schematic (`sim/glitch-top/testbench/tb_temp_por_glitch.sch (DUT: design/netlist/temp_por_top.spice, the committed export of design/temp_por_top.sch; class por_raw_inject adds two instrument lines, see injection)`)
- **PDK**: sky130A @ open_pdks `f6eeac7dad085ffcc829ccfd721f7b4ce39edcf7` (matches sim/pdk.json pin); models `libs.tech/combined/sky130.lib.spice (resolved on the runner as /opt/pdk/sky130A/...)`
- **Tools**: ngspice-47 : Circuit level simulation program (host; the grid ran on the fleet); XSCHEM V3.4.7; Linux 7.0.0-1014-aws x86_64
- **Repo state**: `da28d31` on `feature/issue-181` (clean working tree)
- **Simulation source commit** (grid submitted from): `da28d31fb9f7cd18cacd1ea22edfa4db25b771d3` (dirty at submit: False; pushed to a remote branch at submit: True)
- **Grading source commit**: `da28d31fb9f7cd18cacd1ea22edfa4db25b771d3` (dirty at grading: False; pushed: True)
- **Deck inputs between the two commits** (`design/netlist`, `sim/glitch-top/testbench`, `sim/spiceinit`, `sim/pdk.json`): identical
- **Submitted netlist vs fleet report sha256**: all match
- **Fleet runner**: klt `unknown` / `unknown` (client klt `klt 0.9.2.dev885+ge4c446bd91f2`); client/runner klt skew accepted with batch.runner_version_check=warn; the runner ignores options.ngspice_init so a netlist-carried `set ng_nomodcheck` is used
- **Host tool caveat**: only the testbench is netlisted by xschem here; the DUT is spliced from the committed design/netlist/temp_por_top.spice (host xschem leaves expr() parameters unevaluated)
- **Corner matrix**: process tt, ss, ff, sf, fs; temperature -40 C, 27 C, 125 C; starting supply 2.97 V, 3.30 V, 3.63 V
- **Declared**: 9 request(s) x 45 = 405 points; 0 request(s) with a fleet job id; 0 points graded, 405 NOT_COVERED (never counted as covered).
- **PTAT/CTAT loading**: open; RESETn unloaded; no ideal bias/sensor substitution; committed XMN1 L=20 W=0.42, no diagnostic edits.

## Injection (instrument, disclosed departure from the uninstrumented assembly)
- **Status**: INSTRUMENT, not part of the design. The two lines are present in every class-A deck (the no-injection control keeps them with gen = 0, so the control has the same topology and an idle, zero-current element) and absent from every class-B deck, whose DUT netlist is byte-identical to the committed export.
- **Elements**: `BINJ INJD VSS V=v(POR_RAW)*(1-v(ginj))`; `RINJ INJD POR_RAW <rinj>`
- **Mechanism**: A Thevenin source behind a finite resistor RINJ into the por_comparator output node POR_RAW (the node the deglitch dwell filters). The source voltage tracks v(POR_RAW)*(1-g) where g(t) in [0,1] is the global drive GINJ (testbench BGINJ, a trapezoid: rise te, flat width tw, fall te, starting at t0). With g = 0 the source equals the node voltage, so the element draws exactly zero current at baseline (no idle loading); with g = 1 POR_RAW is pulled toward VSS through RINJ and the comparator output stage (XMI2P/XMI2N) keeps driving the node -- the injected level is therefore a divider of RINJ against the comparator pull-up, not an imposed voltage.
- **Loading**: RINJ (amplitude axis), the target level is VSS (0 V), no capacitance is added. The comparator, output chain, bias and temp_core stay connected and unmodified; the netlist diff against the committed DUT is exactly the two lines above plus a .save of the RINJ current (checked by selftest).
- **Limit rule**: if injection prevents a physically meaningful operating point (nonphysical node, supply current reversal, injection never takes POR_RAW below V_MID, or POR_RAW pinned below V_IL) the point is reported NONPHYSICAL/UNRESOLVED with the injection fields recorded; as-drawn immunity is not claimed from it.
- **Measured per point**: current through RINJ (i(@r.xdut.rinj[i])), POR_RAW minimum, POR_RAW dwell below V_MID are recorded per point; the sampled GINJ drive is checked against the declared trapezoid (tolerance 0.02) or the point is UNRESOLVED.

## Measurement definitions (exploratory; none is a ratified bound)
- **levels**: V_IL = 0.2 vf, V_IH = 0.8 vf, V_MID = 0.5 vf, V_MUST = 0.5 vf (vf = the point's starting supply)
- **assertion**: RESETn falls through V_IL starting from HIGH at t0 (Schmitt).  assertion_rail_limited is recorded when VDD itself was <= V_IL at that instant (the output could not stay high regardless of the comparator).  Release = RESETn rises through V_IH.
- **detectability**: a dip is 'required-to-assert' when VDD spends >= 50 us below V_MUST (piecewise-linear dwell from the full-resolution VDD).  Dips that are not required may assert or not -- both are recorded, neither fails -- but an assertion must still recover.
- **expectation**: Per stimulus, stated in every point: class A from the full-resolution POR_RAW dwell below V_MID -- < 50 us (D_REJ) calls for REJECTION (RESETn must stay above V_IL), >= 1 ms (D_REQ) calls for ASSERTION (must assert, then release), in between assertion is optional but must release; no-injection control calls for no assertion. Class B from the VDD dwell below V_MUST -- >= 50 us (T_REQ) calls for assertion, otherwise optional; rail_collapse (VDD <= V_IL) and dwell_rejection_visible (POR_RAW fell, RESETn did not assert) are recorded. D_REJ/D_REQ are exploratory definitions, not claims about the design's dwell.
- **baseline**: viable when, before t0: exactly one RESETn release and no re-assert, RESETn >= V_IH and POR_RAW >= V_MID over the 2 ms before t0, delivered bias branch current > 0 with peak-to-peak <= 5 % of its mean. Otherwise UNRESOLVED (detected codes are kept in 'detected_codes_ungraded').
- **recovery**: VDD recovered when >= 0.98 vf after the recovery edge starts; an assertion beginning later is reassert_after_recovery; two or more assertions are reassert_chatter; RESETn must be >= V_IH over the last 1 ms.
- **delivered bias**: explicit measurement: drain current [id] of bias_core XMPIB (PMOS whose drain IS the IBIAS node), saved by the testbench as .save @m.xdut.xbias.xmpib.msky130_fd_pr__pfet_g5v0d10v5[id] and appearing in the klt waveform as i(@m.xdut.xbias.xmpib.msky130_fd_pr__pfet_g5v0d10v5[id]). Sign: ngspice BSIM4 reports id POSITIVE for normal conduction in both polarities (established by the brownout-top local probe: XMPIB id ~0.78 uA equals the sum of the consumer diode devices' ids), so the delivered branch current is +id and must be positive at baseline (else NONPHYSICAL). The consumer-side diode devices (comparator, output chain, temp_core XMBD [id]) are saved; their sum over the delivered current at the end is recorded. The IBIAS NODE voltage is recorded separately and never used as a current. End/baseline ratio band [0.8, 1.25] else FAIL bias_not_recovered.
- **resolution**: max sample gap from t0-10 us to glitch end+100 us must be <= min(20 us, width/5, edge/8) for class A (0.1 % float tolerance) and the brown-out rule min(20 us, hold/5, edge/10) for class B AND the sampled drive (VDD for B, GINJ and VDD for A) must match the declared stimulus (VDD within 20 mV, GINJ within 0.02); class A additionally needs the injection to take POR_RAW below V_MID (else the dwell was not exercised -> UNRESOLVED). Otherwise a point with no detected failure is UNRESOLVED, not PASS.
- **physicality**: every saved node within [-0.3 V, vf+0.5 V] for t>0, settled supply current -i(BVDD) > 0, delivered bias positive at baseline. Violation -> NONPHYSICAL (cannot PASS; behavioural verdict not graded).
- **verdicts**: ERROR (missing waveform / channel / non-finite data / convergence, model or backend error) > NONPHYSICAL > UNRESOLVED (unviable baseline, truncated, sparse, stimulus mismatch) > FAIL (resolved physical failure, with trace evidence) > PASS.  NOT_COVERED marks points whose request was never submitted, was refused by the fleet, or has no report; they are counted as uncovered, never as PASS.
- **deck attribution**: each point's retrieved input deck must carry this experiment's banner and request tag, the committed XMN1 L=20 W=0.42, no diagnostic marker, the class's injection element exactly when the class is por_raw_inject, and the declared .param line; otherwise ERROR deck_attribution (a point can never be credited to the wrong DUT/class).
- **stimulus**: Common: power-up ramp min(vf, rup*t) from a physical 0 V, then glitch at t0. Class vdd_level: V(VDD) = min(vf, rup*t) - ex*(clip01((t-t0)*s/ex) - clip01((t-t0-ex/s-th)*s/ex)), ex = max(vf - vlow, 0), symmetric slews sf = sr = s, hold th at the floor (the brown-out BVDD source with sf = sr; SPICE twin of brownout_checker.vdd_expected). Class por_raw_inject: V(VDD) = min(vf, rup*t) only; GINJ g(t) = gen*(clip01((t-t0)/te) - clip01((t-t0-te-tw)/te)). Width tw is the FLAT-TOP width; the full pulse is tw + 2te at the base and tw + te at half amplitude. Control: gen = 0 (class A) / vlow = 99 (class B).
- **observation**: 8 ms after the glitch ends (class A: end of the GINJ fall edge; class B: end of the recovery edge, at the largest starting supply): 1.9x the slowest observed release delay (4.3 ms). A shorter record is truncated -> UNRESOLVED unless a failure is already detected.
- **grid**: RINJ is the amplitude axis: 1 kohm against the comparator's W=2 L=0.5 pull-up is a deep pull-down, 30 kohm a shallow one (levels factor 30 apart; the achieved POR_RAW minimum is MEASURED per point, not assumed). Flat widths 20 us - 2 ms (two decades) straddle the checker's D_REJ = 50 us and D_REQ = 1 ms expectation thresholds on the measured POR_RAW dwell. Edge time is varied one factor at a time around the center point (10 us, 200 us around the 20 us default) -- a declared one-factor-at-a-time treatment, not a full cube. Faster edges (< 10 us) need tmax < 1.25 us and a per-request cost estimate first.
- **expansion policy**: No envelope is claimed. Expansion is a NEW record, never an edit: (a) where a PASS<->FAIL (or reject<->assert) boundary appears between adjacent levels on any axis, add the midpoint level on that axis at the affected corners only; (b) edges faster than 10 us (class A) / slews above 200 kV/s (class B) need a cost estimate first; (c) widths outside 20 us - 2 ms, RINJ between/outside {1k, 30k}, floors between the three levels only with a stated reason; (d) repeated glitches, glitches before the baseline is released, ll/hh passive skew and mismatch Monte Carlo are not in this increment. Any post-hoc addition is labelled as such in its record.
- **trace storage**: committed traces are change-triggered (dV >= 2 mV on VDD/RESETn/POR_RAW/IBIAS node, delivered bias or injection current moved >= 2 % of its maximum, GINJ moved >= 0.01, or a 1 ms anchor); RESETn assertion/release counts are re-derived from the stored trace and compared with the full-resolution result per point.

## Outcome totals (this class only)
| PASS | FAIL | ERROR | NONPHYSICAL | UNRESOLVED | NOT_COVERED |
|---|---|---|---|---|---|
| 0 | 0 | 0 | 0 | 0 | 405 |

Failure codes (graded points): none

NONPHYSICAL breakdown (a point may count in several rows): {'pre-glitch node violation': 0, 'post-glitch node violation': 0, 'supply current reversed at end': 0, 'supply current reversed at baseline': 0, 'NONPHYSICAL total': 0}

## Per-corner summary (all requests of this class, per PVT corner)
| corner | PASS | FAIL | ERROR | NONPHYSICAL | UNRESOLVED | NOT_COVERED |
|---|---|---|---|---|---|---|
| tt_-40c_2.97v | 0 | 0 | 0 | 0 | 0 | 9 |
| tt_-40c_3.30v | 0 | 0 | 0 | 0 | 0 | 9 |
| tt_-40c_3.63v | 0 | 0 | 0 | 0 | 0 | 9 |
| tt_27c_2.97v | 0 | 0 | 0 | 0 | 0 | 9 |
| tt_27c_3.30v | 0 | 0 | 0 | 0 | 0 | 9 |
| tt_27c_3.63v | 0 | 0 | 0 | 0 | 0 | 9 |
| tt_125c_2.97v | 0 | 0 | 0 | 0 | 0 | 9 |
| tt_125c_3.30v | 0 | 0 | 0 | 0 | 0 | 9 |
| tt_125c_3.63v | 0 | 0 | 0 | 0 | 0 | 9 |
| ss_-40c_2.97v | 0 | 0 | 0 | 0 | 0 | 9 |
| ss_-40c_3.30v | 0 | 0 | 0 | 0 | 0 | 9 |
| ss_-40c_3.63v | 0 | 0 | 0 | 0 | 0 | 9 |
| ss_27c_2.97v | 0 | 0 | 0 | 0 | 0 | 9 |
| ss_27c_3.30v | 0 | 0 | 0 | 0 | 0 | 9 |
| ss_27c_3.63v | 0 | 0 | 0 | 0 | 0 | 9 |
| ss_125c_2.97v | 0 | 0 | 0 | 0 | 0 | 9 |
| ss_125c_3.30v | 0 | 0 | 0 | 0 | 0 | 9 |
| ss_125c_3.63v | 0 | 0 | 0 | 0 | 0 | 9 |
| ff_-40c_2.97v | 0 | 0 | 0 | 0 | 0 | 9 |
| ff_-40c_3.30v | 0 | 0 | 0 | 0 | 0 | 9 |
| ff_-40c_3.63v | 0 | 0 | 0 | 0 | 0 | 9 |
| ff_27c_2.97v | 0 | 0 | 0 | 0 | 0 | 9 |
| ff_27c_3.30v | 0 | 0 | 0 | 0 | 0 | 9 |
| ff_27c_3.63v | 0 | 0 | 0 | 0 | 0 | 9 |
| ff_125c_2.97v | 0 | 0 | 0 | 0 | 0 | 9 |
| ff_125c_3.30v | 0 | 0 | 0 | 0 | 0 | 9 |
| ff_125c_3.63v | 0 | 0 | 0 | 0 | 0 | 9 |
| sf_-40c_2.97v | 0 | 0 | 0 | 0 | 0 | 9 |
| sf_-40c_3.30v | 0 | 0 | 0 | 0 | 0 | 9 |
| sf_-40c_3.63v | 0 | 0 | 0 | 0 | 0 | 9 |
| sf_27c_2.97v | 0 | 0 | 0 | 0 | 0 | 9 |
| sf_27c_3.30v | 0 | 0 | 0 | 0 | 0 | 9 |
| sf_27c_3.63v | 0 | 0 | 0 | 0 | 0 | 9 |
| sf_125c_2.97v | 0 | 0 | 0 | 0 | 0 | 9 |
| sf_125c_3.30v | 0 | 0 | 0 | 0 | 0 | 9 |
| sf_125c_3.63v | 0 | 0 | 0 | 0 | 0 | 9 |
| fs_-40c_2.97v | 0 | 0 | 0 | 0 | 0 | 9 |
| fs_-40c_3.30v | 0 | 0 | 0 | 0 | 0 | 9 |
| fs_-40c_3.63v | 0 | 0 | 0 | 0 | 0 | 9 |
| fs_27c_2.97v | 0 | 0 | 0 | 0 | 0 | 9 |
| fs_27c_3.30v | 0 | 0 | 0 | 0 | 0 | 9 |
| fs_27c_3.63v | 0 | 0 | 0 | 0 | 0 | 9 |
| fs_125c_2.97v | 0 | 0 | 0 | 0 | 0 | 9 |
| fs_125c_3.30v | 0 | 0 | 0 | 0 | 0 | 9 |
| fs_125c_3.63v | 0 | 0 | 0 | 0 | 0 | 9 |

## Per-request fleet submissions and outcome counts
| request | kind | RINJ ohm | flat width s | edge s | gen | tstop ms | tmax us | fleet outcome | job id | PASS | FAIL | ERROR | NONPHYSICAL | UNRESOLVED | NOT_COVERED |
|---|---|---|---|---|---|---|---|---|---|---|---|---|---|---|---|
| por_raw_cube_r1000_w2em05_e2em05 | cube | 1000 | 2e-05 | 2e-05 | 1 | 16.06 | 2 | NOT SUBMITTED (no report on disk) | None | 0 | 0 | 0 | 0 | 0 | 45 |
| por_raw_cube_r1000_w0.0002_e2em05 | cube | 1000 | 0.0002 | 2e-05 | 1 | 16.24 | 2 | NOT SUBMITTED (no report on disk) | None | 0 | 0 | 0 | 0 | 0 | 45 |
| por_raw_cube_r1000_w0.002_e2em05 | cube | 1000 | 0.002 | 2e-05 | 1 | 18.04 | 2 | NOT SUBMITTED (no report on disk) | None | 0 | 0 | 0 | 0 | 0 | 45 |
| por_raw_cube_r30000_w2em05_e2em05 | cube | 30000 | 2e-05 | 2e-05 | 1 | 16.06 | 2 | NOT SUBMITTED (no report on disk) | None | 0 | 0 | 0 | 0 | 0 | 45 |
| por_raw_cube_r30000_w0.0002_e2em05 | cube | 30000 | 0.0002 | 2e-05 | 1 | 16.24 | 2 | NOT SUBMITTED (no report on disk) | None | 0 | 0 | 0 | 0 | 0 | 45 |
| por_raw_cube_r30000_w0.002_e2em05 | cube | 30000 | 0.002 | 2e-05 | 1 | 18.04 | 2 | NOT SUBMITTED (no report on disk) | None | 0 | 0 | 0 | 0 | 0 | 45 |
| por_raw_edge_r1000_w0.0002_e1em05 | edge | 1000 | 0.0002 | 1e-05 | 1 | 16.22 | 1 | NOT SUBMITTED (no report on disk) | None | 0 | 0 | 0 | 0 | 0 | 45 |
| por_raw_edge_r1000_w0.0002_e0.0002 | edge | 1000 | 0.0002 | 0.0002 | 1 | 16.6 | 10 | NOT SUBMITTED (no report on disk) | None | 0 | 0 | 0 | 0 | 0 | 45 |
| por_raw_control | control | 1000 | 2e-05 | 2e-05 | 0 | 16.06 | 2 | NOT SUBMITTED (no report on disk) | None | 0 | 0 | 0 | 0 | 0 | 45 |

## Per-point table
Columns: outcome; call = what the stimulus calls for; detectability dwell; asserts (+VDD at assertion for VDD-level; `*` rail-limited); t_assert/t_release ms; spurious releases; baseline; delivered bias (+id of XMPIB, uA) baseline/min/end; IBIAS node V baseline/min; injection or regime observation; max sample gap vs required (us); note.

### por_raw_cube_r1000_w2em05_e2em05
| point | outcome | call | detectability | asserts | t_assert/t_release (ms) | spurious rel | baseline | Ibias base/min/end (uA) | IBIAS node base/min (V) | injection / regime | gap/req (us) | note |
|---|---|---|---|---|---|---|---|---|---|---|---|---|
| tt_-40c_2.97v | NOT_COVERED | - | - | - | - | - | - | - | - | - | - | NOT SUBMITTED (no report on disk) |
| tt_-40c_3.30v | NOT_COVERED | - | - | - | - | - | - | - | - | - | - | NOT SUBMITTED (no report on disk) |
| tt_-40c_3.63v | NOT_COVERED | - | - | - | - | - | - | - | - | - | - | NOT SUBMITTED (no report on disk) |
| tt_27c_2.97v | NOT_COVERED | - | - | - | - | - | - | - | - | - | - | NOT SUBMITTED (no report on disk) |
| tt_27c_3.30v | NOT_COVERED | - | - | - | - | - | - | - | - | - | - | NOT SUBMITTED (no report on disk) |
| tt_27c_3.63v | NOT_COVERED | - | - | - | - | - | - | - | - | - | - | NOT SUBMITTED (no report on disk) |
| tt_125c_2.97v | NOT_COVERED | - | - | - | - | - | - | - | - | - | - | NOT SUBMITTED (no report on disk) |
| tt_125c_3.30v | NOT_COVERED | - | - | - | - | - | - | - | - | - | - | NOT SUBMITTED (no report on disk) |
| tt_125c_3.63v | NOT_COVERED | - | - | - | - | - | - | - | - | - | - | NOT SUBMITTED (no report on disk) |
| ss_-40c_2.97v | NOT_COVERED | - | - | - | - | - | - | - | - | - | - | NOT SUBMITTED (no report on disk) |
| ss_-40c_3.30v | NOT_COVERED | - | - | - | - | - | - | - | - | - | - | NOT SUBMITTED (no report on disk) |
| ss_-40c_3.63v | NOT_COVERED | - | - | - | - | - | - | - | - | - | - | NOT SUBMITTED (no report on disk) |
| ss_27c_2.97v | NOT_COVERED | - | - | - | - | - | - | - | - | - | - | NOT SUBMITTED (no report on disk) |
| ss_27c_3.30v | NOT_COVERED | - | - | - | - | - | - | - | - | - | - | NOT SUBMITTED (no report on disk) |
| ss_27c_3.63v | NOT_COVERED | - | - | - | - | - | - | - | - | - | - | NOT SUBMITTED (no report on disk) |
| ss_125c_2.97v | NOT_COVERED | - | - | - | - | - | - | - | - | - | - | NOT SUBMITTED (no report on disk) |
| ss_125c_3.30v | NOT_COVERED | - | - | - | - | - | - | - | - | - | - | NOT SUBMITTED (no report on disk) |
| ss_125c_3.63v | NOT_COVERED | - | - | - | - | - | - | - | - | - | - | NOT SUBMITTED (no report on disk) |
| ff_-40c_2.97v | NOT_COVERED | - | - | - | - | - | - | - | - | - | - | NOT SUBMITTED (no report on disk) |
| ff_-40c_3.30v | NOT_COVERED | - | - | - | - | - | - | - | - | - | - | NOT SUBMITTED (no report on disk) |
| ff_-40c_3.63v | NOT_COVERED | - | - | - | - | - | - | - | - | - | - | NOT SUBMITTED (no report on disk) |
| ff_27c_2.97v | NOT_COVERED | - | - | - | - | - | - | - | - | - | - | NOT SUBMITTED (no report on disk) |
| ff_27c_3.30v | NOT_COVERED | - | - | - | - | - | - | - | - | - | - | NOT SUBMITTED (no report on disk) |
| ff_27c_3.63v | NOT_COVERED | - | - | - | - | - | - | - | - | - | - | NOT SUBMITTED (no report on disk) |
| ff_125c_2.97v | NOT_COVERED | - | - | - | - | - | - | - | - | - | - | NOT SUBMITTED (no report on disk) |
| ff_125c_3.30v | NOT_COVERED | - | - | - | - | - | - | - | - | - | - | NOT SUBMITTED (no report on disk) |
| ff_125c_3.63v | NOT_COVERED | - | - | - | - | - | - | - | - | - | - | NOT SUBMITTED (no report on disk) |
| sf_-40c_2.97v | NOT_COVERED | - | - | - | - | - | - | - | - | - | - | NOT SUBMITTED (no report on disk) |
| sf_-40c_3.30v | NOT_COVERED | - | - | - | - | - | - | - | - | - | - | NOT SUBMITTED (no report on disk) |
| sf_-40c_3.63v | NOT_COVERED | - | - | - | - | - | - | - | - | - | - | NOT SUBMITTED (no report on disk) |
| sf_27c_2.97v | NOT_COVERED | - | - | - | - | - | - | - | - | - | - | NOT SUBMITTED (no report on disk) |
| sf_27c_3.30v | NOT_COVERED | - | - | - | - | - | - | - | - | - | - | NOT SUBMITTED (no report on disk) |
| sf_27c_3.63v | NOT_COVERED | - | - | - | - | - | - | - | - | - | - | NOT SUBMITTED (no report on disk) |
| sf_125c_2.97v | NOT_COVERED | - | - | - | - | - | - | - | - | - | - | NOT SUBMITTED (no report on disk) |
| sf_125c_3.30v | NOT_COVERED | - | - | - | - | - | - | - | - | - | - | NOT SUBMITTED (no report on disk) |
| sf_125c_3.63v | NOT_COVERED | - | - | - | - | - | - | - | - | - | - | NOT SUBMITTED (no report on disk) |
| fs_-40c_2.97v | NOT_COVERED | - | - | - | - | - | - | - | - | - | - | NOT SUBMITTED (no report on disk) |
| fs_-40c_3.30v | NOT_COVERED | - | - | - | - | - | - | - | - | - | - | NOT SUBMITTED (no report on disk) |
| fs_-40c_3.63v | NOT_COVERED | - | - | - | - | - | - | - | - | - | - | NOT SUBMITTED (no report on disk) |
| fs_27c_2.97v | NOT_COVERED | - | - | - | - | - | - | - | - | - | - | NOT SUBMITTED (no report on disk) |
| fs_27c_3.30v | NOT_COVERED | - | - | - | - | - | - | - | - | - | - | NOT SUBMITTED (no report on disk) |
| fs_27c_3.63v | NOT_COVERED | - | - | - | - | - | - | - | - | - | - | NOT SUBMITTED (no report on disk) |
| fs_125c_2.97v | NOT_COVERED | - | - | - | - | - | - | - | - | - | - | NOT SUBMITTED (no report on disk) |
| fs_125c_3.30v | NOT_COVERED | - | - | - | - | - | - | - | - | - | - | NOT SUBMITTED (no report on disk) |
| fs_125c_3.63v | NOT_COVERED | - | - | - | - | - | - | - | - | - | - | NOT SUBMITTED (no report on disk) |

### por_raw_cube_r1000_w0.0002_e2em05
| point | outcome | call | detectability | asserts | t_assert/t_release (ms) | spurious rel | baseline | Ibias base/min/end (uA) | IBIAS node base/min (V) | injection / regime | gap/req (us) | note |
|---|---|---|---|---|---|---|---|---|---|---|---|---|
| tt_-40c_2.97v | NOT_COVERED | - | - | - | - | - | - | - | - | - | - | NOT SUBMITTED (no report on disk) |
| tt_-40c_3.30v | NOT_COVERED | - | - | - | - | - | - | - | - | - | - | NOT SUBMITTED (no report on disk) |
| tt_-40c_3.63v | NOT_COVERED | - | - | - | - | - | - | - | - | - | - | NOT SUBMITTED (no report on disk) |
| tt_27c_2.97v | NOT_COVERED | - | - | - | - | - | - | - | - | - | - | NOT SUBMITTED (no report on disk) |
| tt_27c_3.30v | NOT_COVERED | - | - | - | - | - | - | - | - | - | - | NOT SUBMITTED (no report on disk) |
| tt_27c_3.63v | NOT_COVERED | - | - | - | - | - | - | - | - | - | - | NOT SUBMITTED (no report on disk) |
| tt_125c_2.97v | NOT_COVERED | - | - | - | - | - | - | - | - | - | - | NOT SUBMITTED (no report on disk) |
| tt_125c_3.30v | NOT_COVERED | - | - | - | - | - | - | - | - | - | - | NOT SUBMITTED (no report on disk) |
| tt_125c_3.63v | NOT_COVERED | - | - | - | - | - | - | - | - | - | - | NOT SUBMITTED (no report on disk) |
| ss_-40c_2.97v | NOT_COVERED | - | - | - | - | - | - | - | - | - | - | NOT SUBMITTED (no report on disk) |
| ss_-40c_3.30v | NOT_COVERED | - | - | - | - | - | - | - | - | - | - | NOT SUBMITTED (no report on disk) |
| ss_-40c_3.63v | NOT_COVERED | - | - | - | - | - | - | - | - | - | - | NOT SUBMITTED (no report on disk) |
| ss_27c_2.97v | NOT_COVERED | - | - | - | - | - | - | - | - | - | - | NOT SUBMITTED (no report on disk) |
| ss_27c_3.30v | NOT_COVERED | - | - | - | - | - | - | - | - | - | - | NOT SUBMITTED (no report on disk) |
| ss_27c_3.63v | NOT_COVERED | - | - | - | - | - | - | - | - | - | - | NOT SUBMITTED (no report on disk) |
| ss_125c_2.97v | NOT_COVERED | - | - | - | - | - | - | - | - | - | - | NOT SUBMITTED (no report on disk) |
| ss_125c_3.30v | NOT_COVERED | - | - | - | - | - | - | - | - | - | - | NOT SUBMITTED (no report on disk) |
| ss_125c_3.63v | NOT_COVERED | - | - | - | - | - | - | - | - | - | - | NOT SUBMITTED (no report on disk) |
| ff_-40c_2.97v | NOT_COVERED | - | - | - | - | - | - | - | - | - | - | NOT SUBMITTED (no report on disk) |
| ff_-40c_3.30v | NOT_COVERED | - | - | - | - | - | - | - | - | - | - | NOT SUBMITTED (no report on disk) |
| ff_-40c_3.63v | NOT_COVERED | - | - | - | - | - | - | - | - | - | - | NOT SUBMITTED (no report on disk) |
| ff_27c_2.97v | NOT_COVERED | - | - | - | - | - | - | - | - | - | - | NOT SUBMITTED (no report on disk) |
| ff_27c_3.30v | NOT_COVERED | - | - | - | - | - | - | - | - | - | - | NOT SUBMITTED (no report on disk) |
| ff_27c_3.63v | NOT_COVERED | - | - | - | - | - | - | - | - | - | - | NOT SUBMITTED (no report on disk) |
| ff_125c_2.97v | NOT_COVERED | - | - | - | - | - | - | - | - | - | - | NOT SUBMITTED (no report on disk) |
| ff_125c_3.30v | NOT_COVERED | - | - | - | - | - | - | - | - | - | - | NOT SUBMITTED (no report on disk) |
| ff_125c_3.63v | NOT_COVERED | - | - | - | - | - | - | - | - | - | - | NOT SUBMITTED (no report on disk) |
| sf_-40c_2.97v | NOT_COVERED | - | - | - | - | - | - | - | - | - | - | NOT SUBMITTED (no report on disk) |
| sf_-40c_3.30v | NOT_COVERED | - | - | - | - | - | - | - | - | - | - | NOT SUBMITTED (no report on disk) |
| sf_-40c_3.63v | NOT_COVERED | - | - | - | - | - | - | - | - | - | - | NOT SUBMITTED (no report on disk) |
| sf_27c_2.97v | NOT_COVERED | - | - | - | - | - | - | - | - | - | - | NOT SUBMITTED (no report on disk) |
| sf_27c_3.30v | NOT_COVERED | - | - | - | - | - | - | - | - | - | - | NOT SUBMITTED (no report on disk) |
| sf_27c_3.63v | NOT_COVERED | - | - | - | - | - | - | - | - | - | - | NOT SUBMITTED (no report on disk) |
| sf_125c_2.97v | NOT_COVERED | - | - | - | - | - | - | - | - | - | - | NOT SUBMITTED (no report on disk) |
| sf_125c_3.30v | NOT_COVERED | - | - | - | - | - | - | - | - | - | - | NOT SUBMITTED (no report on disk) |
| sf_125c_3.63v | NOT_COVERED | - | - | - | - | - | - | - | - | - | - | NOT SUBMITTED (no report on disk) |
| fs_-40c_2.97v | NOT_COVERED | - | - | - | - | - | - | - | - | - | - | NOT SUBMITTED (no report on disk) |
| fs_-40c_3.30v | NOT_COVERED | - | - | - | - | - | - | - | - | - | - | NOT SUBMITTED (no report on disk) |
| fs_-40c_3.63v | NOT_COVERED | - | - | - | - | - | - | - | - | - | - | NOT SUBMITTED (no report on disk) |
| fs_27c_2.97v | NOT_COVERED | - | - | - | - | - | - | - | - | - | - | NOT SUBMITTED (no report on disk) |
| fs_27c_3.30v | NOT_COVERED | - | - | - | - | - | - | - | - | - | - | NOT SUBMITTED (no report on disk) |
| fs_27c_3.63v | NOT_COVERED | - | - | - | - | - | - | - | - | - | - | NOT SUBMITTED (no report on disk) |
| fs_125c_2.97v | NOT_COVERED | - | - | - | - | - | - | - | - | - | - | NOT SUBMITTED (no report on disk) |
| fs_125c_3.30v | NOT_COVERED | - | - | - | - | - | - | - | - | - | - | NOT SUBMITTED (no report on disk) |
| fs_125c_3.63v | NOT_COVERED | - | - | - | - | - | - | - | - | - | - | NOT SUBMITTED (no report on disk) |
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
