2AMLogic/sky130-temp-por/sim/bias-core-smoke/records/20261023-171642-e69f5b2e.md

# Record 20261023-171642-e69f5b2e

- **Record ID**: 20261023-171642-e69f5b2e
- **Experiment**: `bias-core-smoke` — bias_core schematic-entry smoke check: untrimmed nominal operating point
- **Claim**: Harness bring-up for issue #17 -- NOT a spec claim (spec/target-spec.md does not exist yet, spec/porting-plan.md Sec4 item 4). Substantiates that sim/bin/corner-run.py, ported from sky130-bandgap, actually drives THIS repo's own design/bias_core.sch through xschem/ngspice across the full 45-point PVT matrix, and that the process/voltage/temperature knobs measurably change the result. design/bias_core.md already documents an informal, uncommitted spot check at tt/ff/ss x -40/27/125 degC; this record is the harness's own first COMMITTED sim/ evidence, across the full 5-corner x 3-temp x 3-supply grid, not a spot check.
- **Netlist provenance**: schematic (`sim/bias-core-smoke/testbench/tb_bias_core_smoke.sch`)
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
