2AMLogic/sky130-temp-por/docs/characterization-report.md

# Block-level characterization report

Aggregation of the simulation evidence committed under [`sim/`](../sim/README.md)
against the target-specification rows in [`README.md`](../README.md#target-specification-partially-ratified--dr-003-issue-78-remaining-rows-tbd).
Issue #31 (T1 item 8). This report only **aggregates** existing records:

- No simulation was run to produce it; every citation resolves to a file on `main`.
- No spec row, record, or design file is edited by it (`sim/` is append-only evidence).
- It does **not** award, propose, or record a T1 tier, and does not relax the spec.
- Where evidence is missing, partial, or recorded as FAIL, that is stated as a gap, not smoothed over.

Numbers below are copied from the cited records; nothing is inferred or extrapolated.

## 1. Ratification scope

[DR-003](../spec/decision-records/DR-003-ratify-target-spec-recommendation.md)
(Status: ratified, two-key path, issue #78, scoped) made exactly two rows final in
`README.md`: **operating temperature** and **supply**. The other six rows are
explicit placeholders (section 4). DR-003 ratifies the supply row at
[DR-001](../spec/decision-records/DR-001-supply-flavor.md)'s value without
re-ratifying DR-001 itself; DR-001's own file still reads `proposed`, and
`spec/README.md`'s index still lists all three DRs as proposed (a stale index, not
the authoritative target table).

## 2. Evidence coverage at a glance

| Coverage level | What exists on `main` | What does not |
|---|---|---|
| Device slice | Bare `nfet_05v0_nvt` / `nfet_03v3_nvt` devices over the full 45-point PVT grid ([E6](#e6)); PNP mismatch Monte Carlo ([E7](#e7)) | - |
| Leaf cell | `bias_core` startup/branch selection ([E1](#e1)-[E4](#e4)); `temp_core` co-instantiated with `bias_core`, startup only ([E5a](#e5a), [E5b](#e5b)); `por_comparator` VPOR-up / VPOR-down / hysteresis on a quasi-static VDD sweep, ideal-bias and real-`bias_core` variants ([E8](#e8)) | No cell-level record for `por_output_chain` alone (it is exercised only inside the whole-block campaigns E9-E11). `por_comparator` thresholds have no mismatch Monte Carlo, no combined MOS x resistor-skew corners, and no post-layout parasitics |
| Whole block | `temp_por_top` supply-ramp behaviour, 8 ramp rates x 45 PVT points, on a **diagnostic** netlist variant ([E9](#e9)); the as-drawn variant has no PVT/ramp result ([E9](#e9)); the two RESETn re-assertions of the later as-drawn 360-point campaign (`20261010-015905-fbd6329`) are diagnosed as solver/nonphysical artifacts at those two points ([E9b](#e9b)); `temp_por_top` Iq (por-iq / iq-total / incremental temp-iq), 45-point grid, as drawn ([E10](#e10)); the `iq-total` solver-sensitivity replicate over the same 45 points ([E12](#e12)); `temp_por_top` brown-out, exploratory dip grid x 45 PVT points, as drawn ([E11](#e11)): 267 PASS / 5 FAIL / 673 NONPHYSICAL of 945 | No as-drawn supply-ramp PVT result; no ratified brown-out envelope, and 673/945 brown-out points are NONPHYSICAL (unknown, pending #153); the whole-block records inherit the open `temp_core` non-physical-branch signature (#86) |

Every PVT-grid record samples a **3 x 3 x 5 grid**: temperature {-40, 27, 125} C,
supply {2.97, 3.30, 3.63} V, process {tt, ss, ff, sf, fs}. Corner PASS/FAIL is
judged against harness bounds declared in each `experiment.json`, which the records
themselves describe as liveness/branch-selection windows and "NOT a spec claim".

## 3. Ratified rows

### 3.1 Operating temperature: -40...+125 C (final)

| Aspect | Content |
|---|---|
| Ratified target | -40...+125 C, no stretch value (README table; DR-003 row 1, HOLD as drafted) |
| Conditions exercised | Temperature points -40, 27, 125 C only, in every PVT-grid record ([E1](#e1), [E2](#e2), [E3](#e3), [E5a](#e5a), [E5b](#e5b), [E6](#e6)) and in the PNP mismatch Monte Carlo ([E7](#e7)). [E4](#e4) probes 22-32 C at tt only and is a solver diagnostic, not a temperature claim |
| Recorded outcome | Device slice ([E6](#e6)): Overall PASS at all 45 points; Vth of the native-device bins crosses zero inside the range (e.g. `n05l25` ranges -24.5 mV at sf/125 C to +239.5 mV at fs/-40 C), per that experiment's README. `bias_core` ([E3](#e3)): Overall PASS at all 45 points, `vref` 1.24557-1.25815 V across the grid, supply current 7.62936e-07-1.196e-06 A. `temp_core` ([E5a](#e5a), [E5b](#e5b)): Overall **FAIL** in both records, 42/45 points PASS each (see 3.1.1). PNP mismatch ([E7](#e7)): PASS, dVBE sigma recorded at -40/27/125 C |
| Limits of the evidence | Three temperature points sample the endpoints and the midpoint of the range; they do not establish compliance across the continuous -40...+125 C envelope. Whole-block records exist ([E9](#e9), [E10](#e10)) but use the same three temperature points, and their outcomes are partly FAIL / flagged (section 5). The POR comparator thresholds are measured at -40/27/125 C ([E8](#e8)). No record measures temperature error or PTAT/CTAT slope, so nothing here shows the *sensor function* is correct across the range. The `bias_core` first-record FAILs and `temp_core` FAILs below are open as recorded |

#### 3.1.1 Recorded `temp_core` startup FAILs (kept visible)

Both records have `Overall: FAIL` with three failing corner entries each. The
`isup`/`ptat`/`ctat` values at the failing points are non-physical in several cases
(for example negative supply current). The records and the experiment index
([`sim/README.md`](../sim/README.md#current-experiments)) attribute the signature to a
solver artifact, but that attribution is a **hypothesis** carried by those documents;
issue #86 owns the investigation. This report records the outcome as FAIL.

Update (issue #86, [E5c](#e5c) superseded by [E5d](#e5d)): a solver/ramp sweep of the full grid on the current netlist did not re-land any of these six points, in any variant that has run — including the `base` deck control for EN-high (the deck-equivalence caveat of the first sweep is resolved: the failures do not recur even under the original deck's own solver settings, re-expressed for `klt sim`). It produced other failures, all non-physical, whose set differs between the variants run within each scenario; no real failure was found. The per-point attribution "solver artifact" is still not demonstrated at the six points themselves (they pass everywhere run), so the recorded outcome of E5a/E5b stays FAIL and the six points stand as not-reproduced-on-current-netlist with matrix-level artifact evidence. The second sweep is again incomplete in coverage (6 of 10 combos this run; EN-delayed variant diversity beyond `base` exists only in the superseded E5c run); the NOT-RUN combos are open evidence.

| Record | Failing corners (process_temp_supply) |
|---|---|
| [E5a](#e5a) (EN tied high) | `tt_-40c_3.30v`, `tt_125c_3.30v`, `ff_-40c_3.30v` |
| [E5b](#e5b) (EN released late) | `tt_27c_3.63v`, `tt_125c_3.63v`, `sf_-40c_2.97v` |

### 3.2 Supply: 2.97-3.63 V (3.3 V +/-10 %, DR-001) (final)

| Aspect | Content |
|---|---|
| Ratified target | 2.97-3.63 V, no stretch value (README table; DR-003 row 6, ratified at DR-001's value) |
| Conditions exercised | Supply points 2.97, 3.30, 3.63 V in every PVT-grid record ([E1](#e1), [E2](#e2), [E3](#e3), [E5a](#e5a), [E5b](#e5b), [E6](#e6)). [E4](#e4) sweeps 2.97-3.63 V in 10 mV steps (67 values) at tt and 22-32 C only. [E7](#e7) has no supply axis (current-biased diode-connected PNPs) |
| Recorded outcome | `bias_core` startup from 0 V ([E3](#e3)): PASS at all 45 points including the 2.97 V and 3.63 V endpoints. `bias_core` cold `.op` ([E1](#e1)): FAIL at `tt_27c_2.97v` and `tt_27c_3.63v`; [E4](#e4) diagnoses these (and other off-branch `.op` points) as non-physical solver artifacts rather than a second stable state, and [E3](#e3) supersedes the startup experiment's earlier FAIL record ([E2](#e2)). `temp_core` ([E5a](#e5a), [E5b](#e5b)): FAIL as in 3.1.1; failing entries occur at 2.97, 3.30 and 3.63 V. Device slice ([E6](#e6)): PASS at all 45 points, with MASSIST-condition current worst at ff/-40 C/3.63 V per that README |
| Limits of the evidence | Three supply points; no continuous sweep of the full range for any cell except the diagnostic in [E4](#e4), which is single-process, near-room-temperature and cold-`.op` only. The leaf-cell startup records use one ramp (100 us, per `experiment.json`). Ramp-rate coverage exists only in [E9](#e9) (8 rates, 500 V/s to 1 MV/s, exploratory, on a diagnostic variant with a partly FAIL outcome). **No brown-out record exists.** The [E8](#e8) thresholds are measured against a swept VDD (0 to 3.63 V) rather than at the three supply points |

## 4. Unratified rows (explicit placeholders, evidence gaps)

These rows are **not ratified**. No target is stated or inferred here. The
evidence column names records that bear on each row; none of them is a ratified
bound, and each record itself declares it is "NOT a spec claim" (the
por-comparator and Iq records describe their numbers as inputs to a follow-on
DR-003 amendment, which has not happened). Numbering follows DR-003.

| README row | Placeholder | Evidence on `main` | Gap |
|---|---|---|---|
| Temperature error, untrimmed | [TBD-1] | [E13](#e13): `temp_core` local-mismatch Monte Carlo, 15 corners, N = 30: 3 sigma untrimmed 77.38 degC worst corner, 1-point trim 22.76 degC worst corner (mirror and amp offset dominate). [E7](#e7) reports PNP dVBE mismatch only | Unratified; evidence only, global process / gradients / trim quantization not measured |
| Sensor output | [TBD] | None | Evidence gap |
| POR thresholds VPOR-up / VPOR-down | [TBD-2] | [E8](#e8): `por_comparator` alone, 15 points per variant (5 process x 3 T), VPOR-up 2.6832-2.7010 V (ideal-bias) and 2.6908-2.7130 V (real `bias_core`); VPOR-down 2.5430-2.5510 V and 2.5353-2.5567 V. Margin vs the 2.97 V rail +269 mV / +257 mV. Comparator cell only, not the assembled block, no Monte Carlo | Unratified; no ratified number; Monte Carlo margin absent |
| POR hysteresis | [TBD-3] | [E8](#e8): 139.7-150.1 mV (ideal-bias), 145.9-156.3 mV (real `bias_core`) over the same 15 points. The record states a ceiling still needs the `[TBD]` `por-digital-min-vdd` input | Unratified; ceiling input missing |
| Iq (block total) | [TBD-4] por-iq / [TBD-5] temp-iq / [TBD-6] iq-total | [E10](#e10): assembled `temp_por_top` as drawn, 45 points per state. por-iq 50.836-120.264 uA (45/45 ok); iq-total 16.424-36.504 uA at the 28/45 `ok` points, **17/45 iq-total points flagged non-physical-branch**; incremental temp-iq is negative at every `ok` point (por-iq includes forced-reset contention) so it is not the sensor's own current. The record proposes no ceiling | Unratified; iq-total and temp-iq incomplete (17/45 excluded; the [E12](#e12) solver-sensitivity replicate recovers 6, reproduces 6 as non-physical and leaves 5 unresolved, see E12); no ceiling |
| Supply-ramp coverage | [TBD] | [E9](#e9): 8 ramp rates x 45 PVT points on a diagnostic variant (209 PASS / 151 FAIL of 360 points, FAILs are almost all `nonphysical` node flags); as-drawn variant 360/360 ERROR in the first run, then not run on the fleet (refused). Brown-out: [E11](#e11), exploratory dip grid, 267 PASS / 5 FAIL / 673 NONPHYSICAL of 945, NONPHYSICAL unknown pending #153 | Unratified; no as-drawn PVT/ramp result; no ratified brown-out envelope |

## 5. Evidence index

Provenance fields are quoted from each record's header. "Dirty tree" means the
record states the working tree was dirty at run time; such records were **not**
produced from a verified-clean checkout of the committed netlist. Source revisions
`f4f73a5` and `c7b9b94` do **not resolve** to a commit in the current repository
history (likely rewritten or squashed on merge) and are listed as unresolved;
`a9cac4b` and `ee63b45` do resolve. For records whose revision is unresolved or tree
dirty, the frozen netlist snapshot referenced in the record is the artifact that pins
what ran. All records use PDK sky130A at open_pdks
`c6d73a35f524070e85faff4a6a9eef49553ebc2b` (matches `sim/pdk.json`) and
ngspice-46 / XSCHEM V3.4.7 on Linux, except where noted. E8-E10 are fleet batch runs (fleet ngspice-46) whose records list the host as ngspice-42 / XSCHEM V3.4.4 for netlisting and local probes; see each record's header for its repo state and clean/dirty flag.

### E1 - `bias-core-smoke`, cold `.op`, record `20260825-214036-a9cac4b`

- Record: [md](../sim/bias-core-smoke/records/20260825-214036-a9cac4b.md), [json](../sim/bias-core-smoke/records/20260825-214036-a9cac4b.json); manifest [experiment.json](../sim/bias-core-smoke/experiment.json); netlist [snapshot](../sim/bias-core-smoke/netlist-snapshots/20260825-214036-a9cac4b.spice)
- Revision: `a9cac4b` on `feature/issue-17` (resolves); **dirty tree**
- Level: leaf cell (`bias_core`), `.op`
- Conditions: 45-point full grid (5 process x 3 T x 3 V)
- Outcome: **Overall FAIL**; failing points `tt_27c_2.97v` and `tt_27c_3.63v` (supply current recorded negative, `vref` at the rail)
- Limitations: harness bring-up record, "NOT a spec claim"; a cold `.op` does not select the intended branch reliably (see E4)

### E2 - `bias-core-startup`, first record `20260825-235846-f4f73a5` (superseded)

- Record: [md](../sim/bias-core-startup/records/20260825-235846-f4f73a5.md), [json](../sim/bias-core-startup/records/20260825-235846-f4f73a5.json); [snapshot](../sim/bias-core-startup/netlist-snapshots/20260825-235846-f4f73a5.spice)
- Revision: `f4f73a5` on `feature/issue-19` (**unresolved in current history**); **dirty tree**
- Level: leaf cell (`bias_core`), transient from 0 V
- Conditions: 45-point full grid
- Outcome: **Overall FAIL**; failing points `sf_125c_3.63v` and `fs_-40c_3.30v`
- Limitations: superseded by E3 (E3's `Supersedes` field points here); kept as committed evidence

### E3 - `bias-core-startup`, record `20260826-005156-f4f73a5`

- Record: [md](../sim/bias-core-startup/records/20260826-005156-f4f73a5.md), [json](../sim/bias-core-startup/records/20260826-005156-f4f73a5.json); manifest [experiment.json](../sim/bias-core-startup/experiment.json); testbench [schematic](../sim/bias-core-startup/testbench/tb_bias_core_startup.sch); [snapshot](../sim/bias-core-startup/netlist-snapshots/20260826-005156-f4f73a5.spice)
- Revision: `f4f73a5` on `feature/issue-19` (**unresolved in current history**); **dirty tree**
- Level: leaf cell (`bias_core`), `tran ... uic` supply ramp from 0 V (100 us ramp, 10 ms run)
- Conditions: 45-point full grid
- Outcome: **Overall PASS**, 45/45 points. Recorded `vref` 1.24557-1.25815 V and supply current 7.62936e-07-1.196e-06 A over the grid; corner-sensitivity check PASS (spread 0.012578 V)
- Limitations: one ramp rate; `bias_core` alone; harness windows, not spec limits

### E4 - `bias-core-op-branch`, record `20260826-001526-f4f73a5`

- Record: [md](../sim/bias-core-op-branch/records/20260826-001526-f4f73a5.md), [json](../sim/bias-core-op-branch/records/20260826-001526-f4f73a5.json); script [run_op_branch.py](../sim/bias-core-op-branch/run_op_branch.py); [snapshot](../sim/bias-core-op-branch/netlist-snapshots/20260826-001526-f4f73a5.spice)
- Revision: `f4f73a5` on `feature/issue-19` (**unresolved in current history**); **dirty tree**
- Level: leaf cell, solver diagnostic
- Conditions: deliberate non-PVT subset: tt only, 9 temperatures 22-32 C, supply 2.97-3.63 V in 10 mV steps (67 values), 150 `.op` invocations
- Outcome: Overall PASS (diagnostic checks); verdict recorded as "SOLVER ARTIFACT" for all 13 off-branch points
- Limitations: not a PVT or spec record; says nothing about other process corners or temperatures

### E5a - `temp-core-startup`, record `20260826-053032-ee63b45`

- Record: [md](../sim/temp-core-startup/records/20260826-053032-ee63b45.md), [json](../sim/temp-core-startup/records/20260826-053032-ee63b45.json); manifest [experiment.json](../sim/temp-core-startup/experiment.json); testbench [schematic](../sim/temp-core-startup/testbench/tb_temp_core_startup.sch); [snapshot](../sim/temp-core-startup/netlist-snapshots/20260826-053032-ee63b45.spice)
- Revision: `ee63b45` on `feature/issue-22` (resolves); **dirty tree**
- Level: leaf cells (`temp_core` co-instantiated with `bias_core`), transient from 0 V, EN tied high through the ramp
- Conditions: 45-point full grid
- Outcome: **Overall FAIL**, 42/45 PASS; failing points listed in 3.1.1
- Limitations: startup behaviour only (PTAT/CTAT in harness windows), not temperature accuracy; failure cause not established (#86)
- **Provenance-weak**: taken on a dirty working tree (the frozen netlist snapshot is what pins what ran); superseded as the cause evidence by [E5d](#e5d) (issue #86), which does not replace this record
- Follow-up: [E5d](#e5d) did not reproduce these three FAILs on the current netlist (3/3 points pass in all five EN-high variants run, including the `base` deck control); see the E5d outcome for what that does and does not show

### E5b - `temp-core-startup-en-delayed`, record `20260826-054047-ee63b45`

- Record: [md](../sim/temp-core-startup-en-delayed/records/20260826-054047-ee63b45.md), [json](../sim/temp-core-startup-en-delayed/records/20260826-054047-ee63b45.json); manifest [experiment.json](../sim/temp-core-startup-en-delayed/experiment.json); testbench [schematic](../sim/temp-core-startup-en-delayed/testbench/tb_temp_core_startup_en_delayed.sch); [snapshot](../sim/temp-core-startup-en-delayed/netlist-snapshots/20260826-054047-ee63b45.spice)
- Revision: `ee63b45` on `feature/issue-22` (resolves); **dirty tree**
- Level: leaf cells, transient from 0 V, EN held low then released after the supply settles (the DR-002 ordering)
- Conditions: 45-point full grid
- Outcome: **Overall FAIL**, 42/45 PASS; failing points listed in 3.1.1
- Limitations: as E5a
- **Provenance-weak**: taken on a dirty working tree (as E5a)
- Follow-up: [E5d](#e5d) did not reproduce these three FAILs on the current netlist (3/3 points pass under the `base` deck; EN-delayed ramp-variant coverage beyond `base` is in the superseded [E5c](#e5c), same result); see E5d

### E5c - `temp-core-startup-solver`, record `20261010-100955-292949a` (issue #86, superseded by E5d)

- Record: [md](../sim/temp-core-startup-solver/records/20261010-100955-292949a.md), [json](../sim/temp-core-startup-solver/records/20261010-100955-292949a.json); driver [run_solver_sweep.py](../sim/temp-core-startup-solver/run_solver_sweep.py); netlists [snapshots](../sim/temp-core-startup-solver/netlist-snapshots/20261010-100955-292949a/)
- **Superseded** by [E5d](#e5d) (`20261010-200708-47b96e5`), which re-runs the sweep on this host with the EN-high `base` control included; this record is untouched append-only evidence and remains the only run with an EN-delayed variant beyond `base` (the 2 ms ramp)
- Revision: `292949a` on `feature/issue-86` (resolves); **clean tree** at run time; the EN-delayed 2 ms ramp combo came from a `--resume` resubmission at `3bbcac3` (clean tree, same generated netlist); `klt sim --backend batch` (fleet ngspice-46, same PDK pin); job ids in the record
- Level: leaf cells (`temp_core` + `bias_core`), transient from 0 V, full 45-point PVT grid per (EN scenario, variant); the E5a/E5b measurement windows copied unchanged
- Conditions: EN-high x {trtol7, reltol 2e-4, 1 us ramp, 2 ms ramp} and EN-delayed x {base, 2 ms ramp} ran (6 of 10 combos); EN-high x base and EN-delayed x {trtol7, reltol 2e-4, 1 us ramp} were refused by the fleet (`batch_no_capacity`, four submit rounds) and are NOT-RUN, not substituted locally
- Outcome: none of the six E5a/E5b points failed again in any variant run, so none is shown to be an artifact at that point itself and none is a real failure. Failures appeared at other points: 1-5 per combo (EN-high 44/45, 40/45, 44/45, 44/45; EN-delayed base 40/45, 2 ms ramp 40/45), 18 in total, every one non-physical (negative supply current or a loop node/PTAT outside the rails). Within each scenario, across the variants run (four EN-high, two EN-delayed), the failing sets are pairwise disjoint. Across scenarios three corners fail in two combos each: `tt_-40c_3.63v` (EN-high trtol7, EN-delayed base), `ff_-40c_3.63v` (EN-high reltol 2e-4, EN-delayed base) and `fs_-40c_2.97v` (EN-high reltol 2e-4, EN-delayed 2 ms ramp), all at -40 C and all non-physical. Points that landed on the physical branch agree to ~1e-9 V across the variants run in each scenario. No real failure was found and the six specific points remain "not reproduced". The sweep does not by itself prove the solver-artifact class. Every variant, including `base`, re-expresses the supply source, so the six not recurring is also consistent with a deck/supply-source difference, and the EN-high `base` control that would test this did not run. The NOT-RUN combos are open evidence
- Limitations: `base` is a re-expression of the E5 deck for `klt sim` (behavioural supply source), not a bit-identical reproduction; ngspice version of the original records vs. fleet unverified beyond both being "46"

### E5d - `temp-core-startup-solver`, record `20261010-200708-47b96e5` (issue #86)

- Record: [md](../sim/temp-core-startup-solver/records/20261010-200708-47b96e5.md), [json](../sim/temp-core-startup-solver/records/20261010-200708-47b96e5.json); driver [run_solver_sweep.py](../sim/temp-core-startup-solver/run_solver_sweep.py); netlists [snapshots](../sim/temp-core-startup-solver/netlist-snapshots/20261010-200708-47b96e5/); per-point logs `corners/20261010-200708-47b96e5/`
- Supersedes [E5c](#e5c) (its 6-of-10 coverage is re-achieved on this host with the previously-refused EN-high `base` control included; E5c remains the evidence for its own EN-delayed 2 ms ramp combo)
- Revision: `47b96e5` on `feature/issue-86` (resolves; committed design netlists unchanged since `ee63b45` — `git diff ee63b45 HEAD -- design/netlist/` is empty, so the DUT is the current netlist); **clean tree** at the recorded (latest) invocation; the run's earlier submit invocations are individually listed in the record and were taken with the driver's own `--supersedes` edit uncommitted (the only dirty file; no design file was dirty at any point); `klt sim --backend batch`, client klt 0.7.0, fleet ngspice-46 on Spot, same PDK pin; job ids in the record
- Level: leaf cells (`temp_core` + `bias_core`), transient from 0 V, full 45-point PVT grid per (EN scenario, variant); the E5a/E5b measurement windows copied unchanged (no relaxation)
- Conditions: EN-high x {base, trtol7, reltol 2e-4, 1 us ramp, 2 ms ramp} (5 of 5) and EN-delayed x {base} (1 of 5) ran; the four EN-delayed variant combos were refused by the fleet across a ~4.5 h submit-retry window (sustained provision timeouts / capacity refusals, ~25 submit rounds in total; recorded per-combo in the record) and are NOT-RUN, never substituted locally
- Outcome: **none of the six E5a/E5b FAIL points failed again in any variant run — including under the `base` deck**, which resolves E5c's deck-difference caveat: the original failures do not recur even under the original deck's own solver/ramp settings (re-expressed supply), so a deck/supply-source difference is no longer a live alternative explanation for the non-recurrence. New failures appeared at other points: 17 in total (EN-high base 4, trtol7 1, reltol 2e-4 5, 1 us ramp 1, 2 ms ramp 1; EN-delayed base 5 — the identical failing set to E5c's EN-delayed base on another host, a cross-host reproduction), every one with the non-physical signature. Across the five EN-high variants the failing sets move with the setting (one repeat within EN-high: `fs_-40c_2.97v` fails under both `base` and reltol 2e-4, non-physical in both); three corners repeat across scenarios (all -40 C, all non-physical). Physical-branch landings agree to ~1e-9 V across all five EN-high variants (45 points with >= 2 landings). Verdict per issue point: all six **NOT-REPRODUCED** — no real failure at any of them (none fails in any variant run), and the artifact attribution for the *original* landings is supported at matrix level (moving failing sets, all failures non-physical, physical-branch uniqueness) but is not demonstrated *at the points themselves*, since they pass everywhere run. E5a/E5b's recorded Overall FAIL therefore stands as committed evidence of what that run observed, with the cause now bounded: not reproducible on the current netlist under any tested setting, and no real (physical-signature) failure exists anywhere in either sweep
- Limitations: EN-delayed variant diversity beyond `base` lives only in E5c (same netlists); the four refused EN-delayed combos remain open evidence (sustained fleet provision timeouts / capacity refusals over a ~4.5 h submit-retry window; every attempt is in the record's invocation history); `base` is a re-expression (behavioural supply) not a bit-identical deck; the six original landings themselves are simply gone on the current netlist — which is consistent with a solver artifact of the original run but cannot be demonstrated at a point that no longer fails

### E6 - `native-device-characterization`, record `20260909-232337-c7b9b94`

- Record: [md](../sim/native-device-characterization/records/20260909-232337-c7b9b94.md), [json](../sim/native-device-characterization/records/20260909-232337-c7b9b94.json); [README](../sim/native-device-characterization/README.md); manifest [experiment.json](../sim/native-device-characterization/experiment.json); testbench [schematic](../sim/native-device-characterization/testbench/tb_native_device_char.sch); [snapshot](../sim/native-device-characterization/netlist-snapshots/20260909-232337-c7b9b94.spice)
- Revision: `c7b9b94` on `feature/issue-27`, record states **clean working tree**; revision **unresolved in current history**
- Level: device slice only. DUTs are bare PDK devices, not this design's cells
- Conditions: 45-point full grid
- Outcome: **Overall PASS**; both corner-sensitivity checks PASS
- Limitations: characterizes the device menu (Vth, MASSIST-condition static current, off-state current, assist-onset voltage); not `por_output_chain` as a block and not a spec claim

### E7 - `pnp-mismatch`, record `20260825-220116-a9cac4b`

- Record: [md](../sim/pnp-mismatch/records/20260825-220116-a9cac4b.md), [json](../sim/pnp-mismatch/records/20260825-220116-a9cac4b.json); script [run_pnp_mismatch.py](../sim/pnp-mismatch/run_pnp_mismatch.py); testbench [deck](../sim/pnp-mismatch/testbench/tb_pnp_mismatch.spice); [snapshot](../sim/pnp-mismatch/netlist-snapshots/20260825-220116-a9cac4b.spice)
- Revision: `a9cac4b` on `feature/issue-17` (resolves); **dirty tree**
- Level: device slice (PNP pairs, 1x vs 8x array)
- Conditions: local-mismatch Monte Carlo N = 300 at -40/27/125 C, 1 sigma convention; 1 control point, 1 second-seed point, 1 global-process liveness point (N = 30, 27 C); no supply axis
- Outcome: Result PASS (record makes no spec pass/fail claim)
- Limitations: harness-liveness plus distribution of dVBE; not a temperature-accuracy measurement; the three temperature rows share one seed and are not independent estimates

### E8 - `por-comparator-thresholds`, four records (issue #102)

- Records (all in `sim/por-comparator-thresholds/records/`): [ideal-bias md](../sim/por-comparator-thresholds/records/20261009-054322-10d3e9f-ideal-bias.md), [json](../sim/por-comparator-thresholds/records/20261009-054322-10d3e9f-ideal-bias.json); [real-bias-core md](../sim/por-comparator-thresholds/records/20261009-054331-79eebd4-real-bias-core.md), [json](../sim/por-comparator-thresholds/records/20261009-054331-79eebd4-real-bias-core.json); [ideal-bias passive-skew md](../sim/por-comparator-thresholds/records/20261009-062844-09eb234-ideal-bias-passive-skew.md), [json](../sim/por-comparator-thresholds/records/20261009-062844-09eb234-ideal-bias-passive-skew.json); [real-bias-core passive-skew md](../sim/por-comparator-thresholds/records/20261009-062845-bf30f6c-real-bias-core-passive-skew.md), [json](../sim/por-comparator-thresholds/records/20261009-062845-bf30f6c-real-bias-core-passive-skew.json); [README](../sim/por-comparator-thresholds/README.md); manifest [experiment.json](../sim/por-comparator-thresholds/experiment.json)
- Level: leaf cell (`por_comparator`), quasi-static constant-rate VDD sweep up to 3.63 V and back (100 V/s primary, 50 V/s half-rate guard); fleet batch runs
- Conditions: main grid process {tt, ss, ff, sf, fs} x {-40, 27, 125} C = 15 points per variant; supplement ll/hh x the same 3 temperatures = 6 points per variant (tt MOS, resistor/capacitor skew only). Two variants, never mixed: `ideal-bias` (ideal 1 uA IBIAS, ideal 1.25 V VREF) and `real-bias-core`
- Outcome (main grid, per the README, 15/15 points per variant with clean single edges, rate-consistent): ideal-bias VPOR-up 2.6832 V (ff, 125 C) to 2.7010 V (ss, -40 C), VPOR-down 2.5430 V (fs, 125 C) to 2.5510 V (ss, -40 C), hysteresis 139.7 mV (sf, 125 C) to 150.1 mV (ss, -40 C). real-bias-core VPOR-up 2.6908 V (sf, -40 C) to 2.7130 V (ss, 27 C), VPOR-down 2.5353 V (sf, -40 C) to 2.5567 V (ss, 27 C), hysteresis 145.9 mV (sf, 125 C) to 156.3 mV (ss, 27 C). Margin `2.97 V - max(VPOR-up)`: +269 mV (ideal-bias), +257 mV (real-bias-core). Passive-skew supplement: VPOR-up 2.6868-2.6990 V (ideal-bias) and 2.6950-2.7110 V (real-bias-core); margins +271 mV and +259 mV; kept separate from the main tables
- Limitations: "NOT a spec claim"; numbers are described by the README as proposals for a follow-on DR-003 amendment that has not been made. Comparator cell only; no mismatch Monte Carlo (the README names comparator offset and divider mismatch as the likely dominant spread), no combined MOS x resistor-skew corners, no parasitics, only 100/50 V/s sweep rates. The README reports 25 refused fleet launches that were re-submitted unchanged; no grid point fell back to a local run

### E9 - `supply-ramp-top`, whole-block supply-ramp campaign (issues #98, #101)

- Records (in `sim/supply-ramp-top/records/`): [as-drawn first run md](../sim/supply-ramp-top/records/20261009-024606-285dd08.md), [json](../sim/supply-ramp-top/records/20261009-024606-285dd08.json); [diag-mn1-l20 md](../sim/supply-ramp-top/records/20261009-024607-285dd08.md), [json](../sim/supply-ramp-top/records/20261009-024607-285dd08.json); [as-drawn re-run md](../sim/supply-ramp-top/records/20261009-055755-5346c37.md), [json](../sim/supply-ramp-top/records/20261009-055755-5346c37.json); [local probe](../sim/supply-ramp-top/records/20261009-055755-5346c37-local-probe.md); [fleet refusal](../sim/supply-ramp-top/records/20261009-180056-987e04f-fleet-refusal.md); [checker selftest md](../sim/supply-ramp-top/records/20261009-012246-285dd08-checker-selftest.md), [json](../sim/supply-ramp-top/records/20261009-012246-285dd08-checker-selftest.json); manifest [experiment.json](../sim/supply-ramp-top/experiment.json)
- Level: whole block (`temp_por_top`: `bias_core` + `temp_core` + `por_comparator` + `por_output_chain`, real shared IBIAS node and RESETn -> EN feedback), transient from 0 V; 8 exploratory ramp rates (500 V/s to 1 MV/s) x 45 PVT points = 360 points per variant, each primary rate with a half-rate guard; fleet batch
- Outcome, as-drawn first run (`...-024606-285dd08`): **all 360 points ERROR** (`model_not_found`, no valid model bin for `por_output_chain.XMN1` at L=25 W=0.5 in the pinned PDK); no waveform was retrieved. The as-drawn re-run (`...-055755-5346c37`, after the XMN1 change of #101) has 0 of 360 points with a retrieved waveform because every fleet submission was refused; the fleet-refusal companion records a further 8 refused requests. **No as-drawn PVT/ramp result exists.** The single local probe (tt, 27 C, 3.30 V, 10 kV/s) shows the as-drawn netlist simulates with no model-bin error and is explicitly not a PVT or ramp-rate result
- Outcome, diagnostic variant (`...-024607-285dd08`, XMN1 netlisted at L=20; **not** the committed circuit): 209 PASS / 151 FAIL of 360 points. The transition verdict is PASS (one release, no re-assert) at 358 of 360; the two transition FAILs are at 500 kV/s (`no_release`; `reassert_after_release` with `extra_mid_crossings`). Every FAIL point carries the `nonphysical` node flag (17-24 points per rate, 151 in total), the #86 signature of `temp_core`. Half-rate guard grading includes 30 points at 10 kV/s graded `rate-dependent` for VDD at POR_RAW crossing
- Limitations: exploratory rate set and thresholds, "NOT a spec claim", no ratified ramp envelope (DR-003 Sec8); `ll`/`hh` skew not crossed with ramp rate; no brown-out; no Monte Carlo; PTAT/CTAT left open-circuit; the diagnostic variant is not the as-drawn design. The checker selftest record (Overall PASS) is a synthetic-waveform proof of the checker, not a circuit result

### E9b - `supply-ramp-top`, diagnosis of the two RESETn re-assertions in the as-drawn campaign (issue #142)

- Records (in `sim/supply-ramp-top/records/`): [diagnosis md](../sim/supply-ramp-top/records/20261010-115058-392ad30-reassert-diagnosis.md), [json](../sim/supply-ramp-top/records/20261010-115058-392ad30-reassert-diagnosis.json); source campaign record (unchanged) [md](../sim/supply-ramp-top/records/20261010-015905-fbd6329.md), [json](../sim/supply-ramp-top/records/20261010-015905-fbd6329.json); driver [run_reassert_diagnosis.py](../sim/supply-ramp-top/run_reassert_diagnosis.py); manifest [experiment.json](../sim/supply-ramp-top/experiment.json) (`reassert_diagnosis`)
- Level: whole block, unchanged as-drawn `temp_por_top` netlist (real shared IBIAS, real RESETn -> `temp_core.EN` feedback, nothing replaced); 26 single-corner fleet requests on the two exact points (ss / -40 C / 3.63 V at 500 kV/s and fs / 27 C / 2.97 V at 5 kV/s) with 7 solver variants at the exact rate and factor-of-2 adjacent-rate controls; extra internal nodes saved for event ordering; every case is listed in the record
- Outcome: the original re-assertion reproduced on both points under the source campaign's solver settings (`base`), on a run that fails the physicality guard (settled supply current negative, bias-core nodes thousands of volts out of range). Runs whose integration settings land on the physical branch (`reltol2e-4`, `reltol2e-4-tmax1u` for the first point; `reltol2e-4`, `trap`, `tmax1u`, `reltol2e-4-tmax1u` for the second) show one clean release with release times agreeing within 0.07% and 0.12%, and no physical, resolved run anywhere in either point's matrix (adjacent rates included) re-asserts. Per-point verdict under the issue's rules: both points **solver/nonphysical artifact**. Measured event order: in the re-asserting runs the first out-of-window sample appears within 0.3-0.5 us before the RESETn V_MID release crossing and the re-assertion follows 0.8-2.1 us after it; IBIAS drops 266/328 mV across the release against 33/41 mV on the physical branch. The causal mechanism inside the loop is not traced and remains unverified
- Limitations: exploratory, "NOT a spec claim", no ratified ramp envelope (DR-003 Sec8); two points only; the matrix was extended once after the first 18 cases were inspected (disclosed in the record); many non-`base` runs still land on the nonphysical branch, so the nonphysical `temp_core` startup behaviour (#86) is not resolved by this record and the other 358 points are not re-graded; a physical-branch result is evidence about these two points only

### E10 - `iq-top`, assembled `temp_por_top` Iq (issue #107)

- Records (in `sim/iq-top/records/`): [campaign md](../sim/iq-top/records/20261009-191705-df85523.md), [json](../sim/iq-top/records/20261009-191705-df85523.json); [checker selftest md](../sim/iq-top/records/20261009-182935-cf99f67-checker-selftest.md), [json](../sim/iq-top/records/20261009-182935-cf99f67-checker-selftest.json); [later checker selftest md](../sim/iq-top/records/20261009-191705-cb8343e-checker-selftest.md), [json](../sim/iq-top/records/20261009-191705-cb8343e-checker-selftest.json); [README](../sim/iq-top/README.md); manifest [experiment.json](../sim/iq-top/experiment.json)
- Revision: `df85523` on `feature/issue-107`, record states **clean working tree**
- Level: whole block, as drawn; two direct states (por-iq with RESETn forced low by a testbench source; iq-total released) plus derived incremental temp-iq; transient from 0 V, current averaged over 25-30 ms with a checked settling criterion; fleet batch
- Conditions: full 45-point grid per state (5 process x 3 T x 3 V)
- Outcome: por-iq 45/45 `ok`, 50.836-120.264 uA (worst ff, -40 C, 3.63 V; typ tt/27 C/3.30 V 79.443 uA), of which the forced-reset output-stage contention is 46.343-112.162 uA and por-iq less contention is 4.404-8.102 uA. iq-total 28/45 `ok`, 16.424-36.504 uA (worst ff, -40 C, 3.63 V); **17/45 iq-total points are flagged non-physical-branch** (negative settled current, nodes outside the rails; the #86 signature) and excluded from the `ok` statistics, including the typical tt/27 C/3.30 V point. Incremental temp-iq is -83.759 to -33.956 uA at the 28 `ok` points, negative because por-iq includes the contention current; the record states it is not the sensor's own current. The local cross-check of por-iq at tt/27 C/3.30 V matches the fleet; the iq-total local probe returned no waveform (UNRESOLVED). The two checker selftest records are Overall PASS
- Limitations: "EVIDENCE ONLY, NOT a spec claim and NOT a proposed ceiling"; no ceiling proposed; Iq at three supply points only; temp-iq has no clean figure

### E11 - `brownout-top`, assembled `temp_por_top` brown-out (issue #116)

- Records (in `sim/brownout-top/records/`): [campaign md](../sim/brownout-top/records/20261010-222529-41bde9f.md), [json](../sim/brownout-top/records/20261010-222529-41bde9f.json); [checker selftest md](../sim/brownout-top/records/20261010-222928-0265c45-checker-selftest.md), [json](../sim/brownout-top/records/20261010-222928-0265c45-checker-selftest.json); [fleet1 timeout](../sim/brownout-top/records/20261010-130609-db29746-fleet-timeout.md) (an abandoned submission, not a result); [README](../sim/brownout-top/README.md); manifest [experiment.json](../sim/brownout-top/experiment.json)
- Revision: simulated at `bcf00bf` and graded at `41bde9f`, both on `feature/issue-116`; the record states both trees were **clean**, both commits pushed, and the deck inputs identical between them
- Level: whole block, as drawn (unchanged `design/netlist/temp_por_top.spice`, real shared IBIAS and RESETn -> `temp_core.EN` feedback, no ideal substitutions, PTAT/CTAT open); single supply dips with four independent stimulus axes (floor, hold, falling slew, recovery slew), edge durations derived from excursion / slew; graded by `brownout_checker.py` from full-resolution RESETn/POR_RAW/VDD/IBIAS waveforms and the explicit delivered bias current (XMPIB `+id`); fleet batch, default deck tolerances
- Conditions: 21 requests x 45 PVT points = 945 points: floors {2.0, 1.2, 0.4} V x holds {10 us, 100 us, 1 ms} x falling slews {2, 50} kV/s at 10 kV/s recovery, plus recovery-slew variants {1, 100} kV/s at the center point and a no-dip control
- Outcome: **267 PASS / 5 FAIL / 0 ERROR / 673 NONPHYSICAL / 0 UNRESOLVED / 0 NOT_COVERED** (945/945 graded). The 5 physical FAILs are kept with traces: one each in the 2.0 V / 50 kV/s cube at 10 us and 1 ms hold (tt, 27 C, 2.97 V; `reassert_after_recovery`), and three in the 100 kV/s recovery variant (tt -40 C 2.97 V and 3.30 V, ff -40 C 2.97 V; `reassert_chatter` / `premature_release`). **NONPHYSICAL dominates (673/945, 71 %)**, including 18/45 points of the no-dip control. These are the temp_core-side out-of-rail node / reversed supply current signature (#86, #150), with onset recorded per point (365 pre-dip, 281 post-dip node violations). A NONPHYSICAL point is **unknown, not passing**: its dip response is not demonstrated. A tightened-solver fleet re-run of those points is filed as #153. The checker selftest record is Overall PASS
- Limitations: exploratory and bounded grid, **not a ratified bound**; no brown-out envelope is claimed (DR-003 Sec8) and none is inferred here. Recovery slew is varied one-factor-at-a-time only; no falling or recovery slew above 100 kV/s; no ll/hh passive-skew or mismatch axis; no post-layout parasitics; the fleet runner was klt 0.5.0 against client klt 0.7.0 (skew accepted with a warning)

### E12 - `iq-top`, iq-total solver-sensitivity replicate (issue #160)

- Records (in `sim/iq-top/records/`): [md](../sim/iq-top/records/20261011-073715-9d8605a-solver-sensitivity.md), [json](../sim/iq-top/records/20261011-073715-9d8605a-solver-sensitivity.json); evidence under `sim/iq-top/corners/20261011-073715-9d8605a-solver-sensitivity/` and `sim/iq-top/netlist-snapshots/20261011-073715-9d8605a-solver-sensitivity/`; predeclared criterion and classification rules in [experiment.json](../sim/iq-top/experiment.json) `solver_sensitivity`; unit tests `sim/iq-top/test_solver_sensitivity.py` (CI self-checks). The [E10](#e10) records are unchanged
- Revision: first submissions from `9d8605a` (clean tree) on `feature/issue-160`; split resubmissions from later harness-only commits of the same branch (see the record)
- Level: whole block, as drawn, natural-release `iq-total` only; the full 45-point grid under three solver settings: `baseline` (unchanged control deck), `trtol7` (`.options method=gear trtol=7`) and `reltol2e-4` (`.options method=gear trtol=50 reltol=2e-4`); only the testbench options line differs; fleet batch, nothing run locally
- Predeclared criterion: two physical (`ok`) settled currents at a corner agree iff within 1 % (the repo's own `max_window_to_window_drift`); fixed before results and explained in the record
- Outcome: the `baseline` control reproduces [E10](#e10) exactly (28 `ok` / 17 non-physical-branch, same points, max current difference 0). `trtol7`: 20 `ok` / 9 non-physical-branch / 16 nonconverged; `reltol2e-4`: 19 `ok` / 17 non-physical-branch / 3 unsettled / 6 nonconverged. The nonconverged points are fleet per-corner 3000 s timeouts (and, for the whole-grid attempts, the fleet's 3600 s job ceiling, after which each variant was resubmitted split by MOS corner): explicit unknowns, not failures. Where at least two variants land on a physical branch (25 corners) the settled currents agree within 1 % at all 25. Of the 17 original exclusions: 6 recovered-solver-sensitive (a physical settled landing exists under `trtol7` and/or `reltol2e-4`), 6 reproduced-non-physical in every run, 5 unresolved (no `trtol7` result, no physical landing elsewhere), 0 physical-failure. The typical tt / 27 C / 3.30 V point is **unresolved** (non-physical in `baseline` and `reltol2e-4`, no `trtol7` result). 20 points that were `ok` in E10 are not `ok` in at least one variant (timeouts, two physical-but-unsettled `reltol2e-4` landings at tt 125 C (a third, fs 125 C 3.30 V, was already excluded), and non-physical landings that move with the setting), so the failure set does move with the solver
- Limitations: EVIDENCE ONLY, no Iq ceiling and no ratified row changed; iq-total only (forced-low por-iq contention and the definition of incremental temp-iq remain separate DR-006 blockers); three settings are a bounded sample; a recovered label shows a physical landing exists, not the cause of the original artifact; the fleet runner does not report its PDK commit (host pin disclosed, fleet library not verified); `trtol7` and `reltol2e-4` are incomplete because of fleet timeouts

### E13 - `temp-core-accuracy-mc`, record `20261011-165907-69d13ac` (issue #105; supersedes `20261011-165400-69d13ac`)

- Records (in `sim/temp-core-accuracy-mc/records/`): [md](../sim/temp-core-accuracy-mc/records/20261011-165907-69d13ac.md), [json](../sim/temp-core-accuracy-mc/records/20261011-165907-69d13ac.json); superseded [md](../sim/temp-core-accuracy-mc/records/20261011-165400-69d13ac.md) (unchanged, append-only); per-sample CSVs `corners/20261011-165907-69d13ac/`; [README](../sim/temp-core-accuracy-mc/README.md); manifest [experiment.json](../sim/temp-core-accuracy-mc/experiment.json)
- Revision: simulated at `69d13ac` (clean) on `feature/issue-105`, 36 fleet batch jobs; re-graded (no new simulation) at `f10f18e` (clean) with an added branch-consistency guard on V(NA)-V(NB) across temperature
- Level: leaf cells `bias_core` + `temp_core`, DC temperature sweep -40..125 C per sample, local-mismatch Monte Carlo with per-term attribution (PNP, amp offset, resistor ratio, mirror, other, all)
- Conditions: 5 `_mm` process sections x 3 supplies = 15 corners, N = 30 per corner per term, 3 sigma = 3 x sample std per corner
- Outcome: PTAT-referred error, all terms, 3 sigma: untrimmed worst corner 77.38 degC (pooled 64.31), ideal 1-point 27 C trim worst corner 22.76 degC (pooled 19.91), dominated by the mirror and amp-offset terms. The superseded record's trimmed headline 35.73 degC was set by one suspected single-temperature DC branch jump; 4 such samples (2 `other`, 2 `all`) are now excluded and the headline is reported with and without them
- Limitations: EVIDENCE ONLY, no spec claim; local mismatch only (no global process MC, gradients, dynamic behaviour, trim quantization or readout chain); N = 30; branch detection sees only the three evaluation temperatures

### E14 - `glitch-top`, assembled `temp_por_top` glitch immunity, two classes (issue #117)

- Records (in `sim/glitch-top/records/`): class A [md](../sim/glitch-top/records/20261012-113515-25e2978-por_raw_inject.md), [json](../sim/glitch-top/records/20261012-113515-25e2978-por_raw_inject.json); class B [md](../sim/glitch-top/records/20261012-113515-25e2978-vdd_level.md), [json](../sim/glitch-top/records/20261012-113515-25e2978-vdd_level.json); [checker selftest md](../sim/glitch-top/records/20261011-182542-8895cf0-checker-selftest.md), [json](../sim/glitch-top/records/20261011-182542-8895cf0-checker-selftest.json); [README](../sim/glitch-top/README.md); manifest [experiment.json](../sim/glitch-top/experiment.json)
- Revision: simulated and graded at `25e2978` on `feature/issue-117`; each record states a clean, pushed tree
- Level: whole block (committed `design/netlist/temp_por_top.spice`, real shared IBIAS and RESETn -> `temp_core.EN` feedback, no ideal substitutions, PTAT/CTAT open). Class A (`por_raw_inject`) is **instrumented**: a pulse is injected into `POR_RAW` through a finite resistor via two disclosed instrument lines (idle in the `gen = 0` control), so it is not as-drawn evidence. Class B (`vdd_level`) is the **unmodified** assembly with a symmetric-edge VDD dip. The two classes are graded and recorded separately; fleet batch, default deck tolerances
- Conditions: 18 requests x 45 PVT points = 810 points (405 per class): class A `RINJ` {1k, 30k} x width {20 us, 200 us, 2 ms} at 20 us edges, two edge variants and a no-injection control; class B floor {2.0, 1.2, 0.4} V x hold {20 us, 200 us} at 50 kV/s, two slew variants and a no-glitch control
- Outcome: class A **152 PASS / 0 FAIL / 0 ERROR / 172 NONPHYSICAL / 81 UNRESOLVED / 0 NOT_COVERED**; class B **67 PASS / 5 FAIL / 45 ERROR / 288 NONPHYSICAL / 0 UNRESOLVED / 0 NOT_COVERED**. The 45 class-B ERRORs are one request (`vdd_slew_v1.2_h0.0002_s200000`) whose fleet report has status `error`. Two requests hung client-side to the driver's 4 h cap and were re-submitted once under the same run id. NONPHYSICAL points (the #86 / #150 default-deck signature) are unknown, not passing
- Limitations: exploratory and bounded grid, **not a ratified bound**; no glitch envelope is claimed (DR-003 Sec8). Class A amplitude is set by `RINJ` against the comparator pull-up and measured per point; no capacitive/charge injection, repeated glitches, asymmetric edges or mismatch axis; tightened-solver re-run of the NONPHYSICAL cells is not done

## 6. Gaps summary

1. Whole-block (`temp_por_top`) simulation: records exist (E9, E10, E11) but the as-drawn supply-ramp PVT matrix has no result (E9: first run all ERROR on a model-bin failure, re-run refused by the fleet); the diagnostic-variant ramp run is 209 PASS / 151 FAIL of 360 points; Iq iq-total has 17/45 non-physical-branch points ([E12](#e12) solver replicate: 6 recovered with solver-sensitive evidence, 6 reproduced non-physical, 5 unresolved; the typical tt/27 C/3.30 V point is unresolved).
2. `temp_core` startup: both leaf records FAIL (3 corners each) and the same non-physical signature recurs in E9 and E10; cause not established; owned by #86. Update: [E5c](#e5c) did not reproduce the six points, found 18 other non-physical failures (failing sets disjoint between variants within each scenario, three -40 C corners repeating across scenarios) and no real failure, but covers only 6 of the 10 planned (scenario, variant) combos, lacks the EN-high `base` control, and every variant re-expresses the supply source, so non-recurrence is not by itself proof of an artifact.
3. POR comparator thresholds (E8) are measured on the cell only, with no mismatch Monte Carlo; `por_output_chain` has no cell-level record (only E6 devices and the whole-block runs).
4. Continuous temperature and supply coverage: only three points each (plus the narrow diagnostic E4); E8 sweeps VDD continuously but only for the comparator.
5. Brown-out behaviour: exploratory only ([E11](#e11)): 267 PASS / 5 FAIL / 673 NONPHYSICAL of 945 points, no ratified envelope; the NONPHYSICAL points are unknown pending the tightened-solver re-run (#153). Supply-ramp-rate coverage: exploratory, diagnostic variant only (E9).
6. Provenance: all leaf-cell records were taken from a dirty working tree; `f4f73a5` and `c7b9b94` do not resolve in current history.
7. Glitch immunity: exploratory only ([E14](#e14)): class A 152 PASS / 172 NONPHYSICAL / 81 UNRESOLVED, class B 67 PASS / 5 FAIL / 45 ERROR / 288 NONPHYSICAL of 405 points each; no ratified envelope; NONPHYSICAL points are unknown pending a tightened-solver re-run.
8. The six unratified rows (section 4) have no ratified targets. Evidence for the POR threshold, hysteresis, Iq and supply-ramp rows exists in E8-E10 but is incomplete as stated above and is not a spec claim; the temperature-error row has mismatch-only evidence in [E13](#e13) (not a spec claim); no evidence exists for the sensor-output row.
