2AMLogic/sky130-temp-por/sim/native-device-characterization/records/20260909-232337-c7b9b94.md

# Record 20260909-232337-c7b9b94

- **Record ID**: 20260909-232337-c7b9b94
- **Experiment**: `native-device-characterization` — sky130 native-device characterization: nfet_05v0_nvt vs nfet_03v3_nvt threshold voltage, MASSIST-condition static current, off-state leakage and assist-onset voltage over the full PVT matrix
- **Claim**: Issue #27 -- NOT a spec claim (spec/target-spec.md does not exist yet, spec/porting-plan.md Sec4 item 4). First characterization of the near-zero-Vt (native) NMOS device class this port introduced, which no sibling repo has data for and which spec/porting-plan.md Sec2.2/Sec2.6 explicitly defers to a characterization issue. Substantiates, per device flavor and per PDK bin geometry, at every point of the full 45-point PVT matrix: (a) constant-current threshold voltage and its process/temperature spread; (b) the drain current of a device wired exactly as design/por_output_chain.sch's MASSIST -- gate AND drain at VDD, source/bulk at VSS -- which is the always-on static current MASSIST costs in the released state and which design/por_output_chain.md records as uncharacterized and unbudgeted; (c) off-state (VGS=0) leakage at the same drain bias, for reference; (d) the supply voltage at which that MASSIST connection first sinks a stated assist current, i.e. the measurement behind por_output_chain.md's 'begins conducting from the very first millivolt of VDD' claim. The DUTs are bare PDK devices, not this design's cells: what is characterized here is the DEVICE menu, so the numbers feed the future por-iq spec row and the Sec2.6 flavor decision without making any claim about por_output_chain as a block. This experiment does NOT change the schematic and does NOT re-decide the flavor or the bin -- if the numbers say either should change, spec/decision-records/ owns that, per the issue's own out-of-scope list.
- **Netlist provenance**: schematic (`sim/native-device-characterization/testbench/tb_native_device_char.sch`)
- **PDK**: sky130A @ open_pdks `c6d73a35f524070e85faff4a6a9eef49553ebc2b` (matches sim/pdk.json pin); models `/home/ubuntu/.volare/sky130A/libs.tech/combined/sky130.lib.spice`
- **Tools**: ngspice-46 : Circuit level simulation program; XSCHEM V3.4.7; Linux 7.0.0-1010-aws x86_64
- **Repo state**: `c7b9b94` on `feature/issue-27` (clean working tree)
- **Corner matrix run**:
  - Process: tt, ss, ff, sf, fs
  - Temperature: -40 °C, 27 °C, 125 °C
  - Supply: 2.97 V, 3.30 V, 3.63 V
  - 45 corner point(s) executed
  - Full PVT matrix declared in `experiment.json` (−40/27/125 °C × ±10 % supply × process corners)
- **Statistical convention**: N/A (deterministic corner-matrix characterization, not a distribution claim -- see notes: this experiment deliberately makes no statistical/yield claim, so it does NOT substitute for the Monte Carlo evidence sim/README.md keeps on a separate axis)
- **Result**:
  - tt_-40c_2.97v: PASS (vth_n05l25=0.1955V; ion_n05l25=2.00915e-05A; ioff_n05l25=4.88595e-12A; vmin1n_n05l25=0.1525V; vmin100n_n05l25=0.3365V; vth_n05l8=0.1915V; ion_n05l8=6.52394e-05A; ioff_n05l8=1.74043e-11A; vmin1n_n05l8=0.1155V; vmin100n_n05l8=0.2635V; vth_n03l08=0.0635V; ion_n03l08=0.000186496A; ioff_n03l08=1.05826e-07A; vmin1n_n03l08=0.0035V; vmin100n_n03l08=0.0905V; isup_a=0.000271933A; isup_b=0.000359069A; izero_b=5.57111e-27A; ia_flat_n05l25=01)
  - tt_-40c_3.30v: PASS (vth_n05l25=0.1955V; ion_n05l25=2.48252e-05A; ioff_n05l25=4.93748e-12A; vmin1n_n05l25=0.1525V; vmin100n_n05l25=0.3365V; vth_n05l8=0.1915V; ion_n05l8=7.93208e-05A; ioff_n05l8=1.76108e-11A; vmin1n_n05l8=0.1155V; vmin100n_n05l8=0.2635V; vth_n03l08=0.0635V; ion_n03l08=0.000210598A; ioff_n03l08=1.18808e-07A; vmin1n_n03l08=0.0035V; vmin100n_n03l08=0.0905V; isup_a=0.000314863A; isup_b=0.000359069A; izero_b=5.57111e-27A; ia_flat_n05l25=01)
  - tt_-40c_3.63v: PASS (vth_n05l25=0.1955V; ion_n05l25=3.00322e-05A; ioff_n05l25=4.99822e-12A; vmin1n_n05l25=0.1525V; vmin100n_n05l25=0.3365V; vth_n05l8=0.1915V; ion_n05l8=9.44593e-05A; ioff_n05l8=1.7853e-11A; vmin1n_n05l8=0.1155V; vmin100n_n05l8=0.2635V; vth_n03l08=0.0635V; ion_n03l08=0.000234577A; ioff_n03l08=1.32313e-07A; vmin1n_n03l08=0.0035V; vmin100n_n03l08=0.0905V; isup_a=0.000359201A; isup_b=0.000359069A; izero_b=5.57111e-27A; ia_flat_n05l25=01)
  - tt_27c_2.97v: PASS (vth_n05l25=0.1255V; ion_n05l25=1.44615e-05A; ioff_n05l25=1.66446e-10A; vmin1n_n05l25=0.0715V; vmin100n_n05l25=0.2995V; vth_n05l8=0.1215V; ion_n05l8=4.78464e-05A; ioff_n05l8=5.73372e-10A; vmin1n_n05l8=0.0335V; vmin100n_n05l8=0.2125V; vth_n03l08=-0.0145V; ion_n03l08=0.000163537A; ioff_n03l08=6.68746e-07A; vmin1n_n03l08=0.0005V; vmin100n_n03l08=0.0375V; isup_a=0.000226515A; isup_b=0.000296574A; izero_b=3.46729e-25A; ia_flat_n05l25=01)
  - tt_27c_3.30v: PASS (vth_n05l25=0.1255V; ion_n05l25=1.77456e-05A; ioff_n05l25=1.67882e-10A; vmin1n_n05l25=0.0715V; vmin100n_n05l25=0.2995V; vth_n05l8=0.1215V; ion_n05l8=5.78956e-05A; ioff_n05l8=5.79097e-10A; vmin1n_n05l8=0.0335V; vmin100n_n05l8=0.2125V; vth_n03l08=-0.0145V; ion_n03l08=0.000185066A; ioff_n03l08=7.45547e-07A; vmin1n_n03l08=0.0005V; vmin100n_n03l08=0.0375V; isup_a=0.000261453A; isup_b=0.000296574A; izero_b=3.46729e-25A; ia_flat_n05l25=01)
  - tt_27c_3.63v: PASS (vth_n05l25=0.1255V; ion_n05l25=2.13507e-05A; ioff_n05l25=1.69626e-10A; vmin1n_n05l25=0.0715V; vmin100n_n05l25=0.2995V; vth_n05l8=0.1215V; ion_n05l8=6.86995e-05A; ioff_n05l8=5.85975e-10A; vmin1n_n05l8=0.0335V; vmin100n_n05l8=0.2125V; vth_n03l08=-0.0145V; ion_n03l08=0.000206524A; ioff_n03l08=8.25292e-07A; vmin1n_n03l08=0.0005V; vmin100n_n03l08=0.0375V; isup_a=0.000297401A; isup_b=0.000296574A; izero_b=3.46729e-25A; ia_flat_n05l25=01)
  - tt_125c_2.97v: PASS (vth_n05l25=0.0205V; ion_n05l25=1.00878e-05A; ioff_n05l25=2.91075e-09A; vmin1n_n05l25=0.0125V; vmin100n_n05l25=0.2445V; vth_n05l8=0.0175V; ion_n05l8=3.37405e-05A; ioff_n05l8=9.76804e-09A; vmin1n_n05l8=0.0045V; vmin100n_n05l8=0.1415V; vth_n03l08=-0.1245V; ion_n03l08=0.000137126A; ioff_n03l08=2.12247e-06A; vmin1n_n03l08=0.0005V; vmin100n_n03l08=0.0145V; isup_a=0.000183089A; isup_b=0.000236736A; izero_b=3.26393e-24A; ia_flat_n05l25=01)
  - tt_125c_3.30v: PASS (vth_n05l25=0.0205V; ion_n05l25=1.22512e-05A; ioff_n05l25=2.92826e-09A; vmin1n_n05l25=0.0125V; vmin100n_n05l25=0.2445V; vth_n05l8=0.0175V; ion_n05l8=4.04763e-05A; ioff_n05l8=9.84046e-09A; vmin1n_n05l8=0.0045V; vmin100n_n05l8=0.1415V; vth_n03l08=-0.1245V; ion_n03l08=0.000155731A; ioff_n03l08=2.32532e-06A; vmin1n_n03l08=0.0005V; vmin100n_n03l08=0.0145V; isup_a=0.000210797A; isup_b=0.000236736A; izero_b=3.26393e-24A; ia_flat_n05l25=01)
  - tt_125c_3.63v: PASS (vth_n05l25=0.0205V; ion_n05l25=1.46168e-05A; ioff_n05l25=2.95093e-09A; vmin1n_n05l25=0.0125V; vmin100n_n05l25=0.2445V; vth_n05l8=0.0175V; ion_n05l8=4.76983e-05A; ioff_n05l8=9.93165e-09A; vmin1n_n05l8=0.0045V; vmin100n_n05l8=0.1415V; vth_n03l08=-0.1245V; ion_n03l08=0.000174421A; ioff_n03l08=2.53531e-06A; vmin1n_n03l08=0.0005V; vmin100n_n03l08=0.0145V; isup_a=0.000239284A; isup_b=0.000236736A; izero_b=3.26393e-24A; ia_flat_n05l25=01)
  - ss_-40c_2.97v: PASS (vth_n05l25=0.2185V; ion_n05l25=1.87852e-05A; ioff_n05l25=2.08794e-12A; vmin1n_n05l25=0.1755V; vmin100n_n05l25=0.3625V; vth_n05l8=0.2145V; ion_n05l8=6.10764e-05A; ioff_n05l8=7.24213e-12A; vmin1n_n05l8=0.1385V; vmin100n_n05l8=0.2875V; vth_n03l08=0.1215V; ion_n03l08=0.000161759A; ioff_n03l08=1.30786e-08A; vmin1n_n03l08=0.0195V; vmin100n_n03l08=0.1425V; isup_a=0.000241634A; isup_b=0.00032157A; izero_b=8.33017e-31A; ia_flat_n05l25=01)
  - ss_-40c_3.30v: PASS (vth_n05l25=0.2185V; ion_n05l25=2.32524e-05A; ioff_n05l25=2.11015e-12A; vmin1n_n05l25=0.1755V; vmin100n_n05l25=0.3625V; vth_n05l8=0.2145V; ion_n05l8=7.44026e-05A; ioff_n05l8=7.32824e-12A; vmin1n_n05l8=0.1385V; vmin100n_n05l8=0.2875V; vth_n03l08=0.1215V; ion_n03l08=0.000183254A; ioff_n03l08=1.46913e-08A; vmin1n_n03l08=0.0195V; vmin100n_n03l08=0.1425V; isup_a=0.000280924A; isup_b=0.00032157A; izero_b=8.33017e-31A; ia_flat_n05l25=01)
  - ss_-40c_3.63v: PASS (vth_n05l25=0.2185V; ion_n05l25=2.81713e-05A; ioff_n05l25=2.13627e-12A; vmin1n_n05l25=0.1755V; vmin100n_n05l25=0.3625V; vth_n05l8=0.2145V; ion_n05l8=8.8746e-05A; ioff_n05l8=7.42922e-12A; vmin1n_n05l8=0.1385V; vmin100n_n05l8=0.2875V; vth_n03l08=0.1215V; ion_n03l08=0.000204653A; ioff_n03l08=1.63727e-08A; vmin1n_n03l08=0.0195V; vmin100n_n03l08=0.1425V; isup_a=0.000321587A; isup_b=0.00032157A; izero_b=8.33017e-31A; ia_flat_n05l25=01)
  - ss_27c_2.97v: PASS (vth_n05l25=0.1485V; ion_n05l25=1.35241e-05A; ioff_n05l25=8.81562e-11A; vmin1n_n05l25=0.0945V; vmin100n_n05l25=0.3255V; vth_n05l8=0.1455V; ion_n05l8=4.47829e-05A; ioff_n05l8=2.9752e-10A; vmin1n_n05l8=0.0515V; vmin100n_n05l8=0.2375V; vth_n03l08=0.0435V; ion_n03l08=0.000141934A; ioff_n03l08=1.83788e-07A; vmin1n_n03l08=0.0015V; vmin100n_n03l08=0.0765V; isup_a=0.000200425A; isup_b=0.000264851A; izero_b=2.48783e-26A; ia_flat_n05l25=01)
  - ss_27c_3.30v: PASS (vth_n05l25=0.1485V; ion_n05l25=1.66236e-05A; ioff_n05l25=8.89235e-11A; vmin1n_n05l25=0.0945V; vmin100n_n05l25=0.3255V; vth_n05l8=0.1455V; ion_n05l8=5.42877e-05A; ioff_n05l8=3.00512e-10A; vmin1n_n05l8=0.0515V; vmin100n_n05l8=0.2375V; vth_n03l08=0.0435V; ion_n03l08=0.000161146A; ioff_n03l08=2.05582e-07A; vmin1n_n03l08=0.0015V; vmin100n_n03l08=0.0765V; isup_a=0.000232263A; isup_b=0.000264851A; izero_b=2.48783e-26A; ia_flat_n05l25=01)
  - ss_27c_3.63v: PASS (vth_n05l25=0.1485V; ion_n05l25=2.00294e-05A; ioff_n05l25=8.9854e-11A; vmin1n_n05l25=0.0945V; vmin100n_n05l25=0.3255V; vth_n05l8=0.1455V; ion_n05l8=6.45178e-05A; ioff_n05l8=3.04103e-10A; vmin1n_n05l8=0.0515V; vmin100n_n05l8=0.2375V; vth_n03l08=0.0435V; ion_n03l08=0.000180304A; ioff_n03l08=2.28286e-07A; vmin1n_n03l08=0.0015V; vmin100n_n03l08=0.0765V; isup_a=0.00026508A; isup_b=0.000264851A; izero_b=2.48783e-26A; ia_flat_n05l25=01)
  - ss_125c_2.97v: PASS (vth_n05l25=0.0445V; ion_n05l25=9.4379e-06A; ioff_n05l25=1.83113e-09A; vmin1n_n05l25=0.0185V; vmin100n_n05l25=0.2705V; vth_n05l8=0.0425V; ion_n05l8=3.15845e-05A; ioff_n05l8=6.0554e-09A; vmin1n_n05l8=0.0075V; vmin100n_n05l8=0.1645V; vth_n03l08=-0.0665V; ion_n03l08=0.000119121A; ioff_n03l08=1.03661e-06A; vmin1n_n03l08=0.0005V; vmin100n_n03l08=0.0265V; isup_a=0.000161188A; isup_b=0.000210853A; izero_b=1.28151e-24A; ia_flat_n05l25=01)
  - ss_125c_3.30v: PASS (vth_n05l25=0.0445V; ion_n05l25=1.14803e-05A; ioff_n05l25=1.84268e-09A; vmin1n_n05l25=0.0185V; vmin100n_n05l25=0.2705V; vth_n05l8=0.0425V; ion_n05l8=3.79534e-05A; ioff_n05l8=6.10209e-09A; vmin1n_n05l8=0.0075V; vmin100n_n05l8=0.1645V; vth_n03l08=-0.0665V; ion_n03l08=0.000135698A; ioff_n03l08=1.14393e-06A; vmin1n_n03l08=0.0005V; vmin100n_n03l08=0.0265V; isup_a=0.000186283A; isup_b=0.000210853A; izero_b=1.28151e-24A; ia_flat_n05l25=01)
  - ss_125c_3.63v: PASS (vth_n05l25=0.0445V; ion_n05l25=1.37157e-05A; ioff_n05l25=1.8575e-09A; vmin1n_n05l25=0.0185V; vmin100n_n05l25=0.2705V; vth_n05l8=0.0425V; ion_n05l8=4.47896e-05A; ioff_n05l8=6.16049e-09A; vmin1n_n05l8=0.0075V; vmin100n_n05l8=0.1645V; vth_n03l08=-0.0665V; ion_n03l08=0.000152348A; ioff_n03l08=1.25542e-06A; vmin1n_n03l08=0.0005V; vmin100n_n03l08=0.0265V; isup_a=0.000212116A; isup_b=0.000210853A; izero_b=1.28151e-24A; ia_flat_n05l25=01)
  - ff_-40c_2.97v: PASS (vth_n05l25=0.1725V; ion_n05l25=2.14333e-05A; ioff_n05l25=1.13057e-11A; vmin1n_n05l25=0.1305V; vmin100n_n05l25=0.3115V; vth_n05l8=0.1675V; ion_n05l8=6.95054e-05A; ioff_n05l8=4.13335e-11A; vmin1n_n05l8=0.0915V; vmin100n_n05l8=0.2395V; vth_n03l08=0.0085V; ion_n03l08=0.000212202A; ioff_n03l08=5.19738e-07A; vmin1n_n03l08=0.0005V; vmin100n_n03l08=0.0455V; isup_a=0.000303661A; isup_b=0.000397733A; izero_b=1.68006e-26A; ia_flat_n05l25=01)
  - ff_-40c_3.30v: PASS (vth_n05l25=0.1725V; ion_n05l25=2.64372e-05A; ioff_n05l25=1.14244e-11A; vmin1n_n05l25=0.1305V; vmin100n_n05l25=0.3115V; vth_n05l8=0.1675V; ion_n05l8=8.43488e-05A; ioff_n05l8=4.18231e-11A; vmin1n_n05l8=0.0915V; vmin100n_n05l8=0.2395V; vth_n03l08=0.0085V; ion_n03l08=0.000238928A; ioff_n03l08=5.82239e-07A; vmin1n_n03l08=0.0005V; vmin100n_n03l08=0.0455V; isup_a=0.000350296A; isup_b=0.000397733A; izero_b=1.68006e-26A; ia_flat_n05l25=01)
  - ff_-40c_3.63v: PASS (vth_n05l25=0.1725V; ion_n05l25=3.1936e-05A; ioff_n05l25=1.15645e-11A; vmin1n_n05l25=0.1305V; vmin100n_n05l25=0.3115V; vth_n05l8=0.1675V; ion_n05l8=0.000100288A; ioff_n05l8=4.23975e-11A; vmin1n_n05l8=0.0915V; vmin100n_n05l8=0.2395V; vth_n03l08=0.0085V; ion_n03l08=0.000265508A; ioff_n03l08=6.47071e-07A; vmin1n_n03l08=0.0005V; vmin100n_n03l08=0.0455V; isup_a=0.00039838A; isup_b=0.000397733A; izero_b=1.68006e-26A; ia_flat_n05l25=01)
  - ff_27c_2.97v: PASS (vth_n05l25=0.1015V; ion_n05l25=1.54241e-05A; ioff_n05l25=3.09843e-10A; vmin1n_n05l25=0.0505V; vmin100n_n05l25=0.2735V; vth_n05l8=0.0975V; ion_n05l8=5.09873e-05A; ioff_n05l8=1.08868e-09A; vmin1n_n05l8=0.0215V; vmin100n_n05l8=0.1885V; vth_n03l08=-0.0695V; ion_n03l08=0.000186098A; ioff_n03l08=1.75566e-06A; vmin1n_n03l08=0.0005V; vmin100n_n03l08=0.0175V; isup_a=0.000254266A; isup_b=0.000329426A; izero_b=7.89281e-23A; ia_flat_n05l25=01)
  - ff_27c_3.30v: PASS (vth_n05l25=0.1015V; ion_n05l25=1.88954e-05A; ioff_n05l25=3.12477e-10A; vmin1n_n05l25=0.0505V; vmin100n_n05l25=0.2735V; vth_n05l8=0.0975V; ion_n05l8=6.15866e-05A; ioff_n05l8=1.09943e-09A; vmin1n_n05l8=0.0215V; vmin100n_n05l8=0.1885V; vth_n03l08=-0.0695V; ion_n03l08=0.000209969A; ioff_n03l08=1.94566e-06A; vmin1n_n03l08=0.0005V; vmin100n_n03l08=0.0175V; isup_a=0.000292398A; isup_b=0.000329426A; izero_b=7.89281e-23A; ia_flat_n05l25=01)
  - ff_27c_3.63v: PASS (vth_n05l25=0.1015V; ion_n05l25=2.27025e-05A; ioff_n05l25=3.15684e-10A; vmin1n_n05l25=0.0505V; vmin100n_n05l25=0.2735V; vth_n05l8=0.0975V; ion_n05l8=7.29693e-05A; ioff_n05l8=1.11235e-09A; vmin1n_n05l8=0.0215V; vmin100n_n05l8=0.1885V; vth_n03l08=-0.0695V; ion_n03l08=0.000233754A; ioff_n03l08=2.14227e-06A; vmin1n_n03l08=0.0005V; vmin100n_n03l08=0.0175V; isup_a=0.000331569A; isup_b=0.000329426A; izero_b=7.89281e-23A; ia_flat_n05l25=01)
  - ff_125c_2.97v: PASS (vth_n05l25=-0.0045V; ion_n05l25=1.0755e-05A; ioff_n05l25=4.58505e-09A; vmin1n_n05l25=0.0095V; vmin100n_n05l25=0.2195V; vth_n05l8=-0.0075V; ion_n05l8=3.59505e-05A; ioff_n05l8=1.56168e-08A; vmin1n_n05l8=0.0035V; vmin100n_n05l8=0.1215V; vth_n03l08=-0.1795V; ion_n03l08=0.000155962A; ioff_n03l08=3.72833e-06A; vmin1n_n03l08=0.0005V; vmin100n_n03l08=0.0085V; isup_a=0.000206416A; isup_b=0.000263574A; izero_b=1.87733e-24A; ia_flat_n05l25=01)
  - ff_125c_3.30v: PASS (vth_n05l25=-0.0045V; ion_n05l25=1.3041e-05A; ioff_n05l25=4.61112e-09A; vmin1n_n05l25=0.0095V; vmin100n_n05l25=0.2195V; vth_n05l8=-0.0075V; ion_n05l8=4.30572e-05A; ioff_n05l8=1.57273e-08A; vmin1n_n05l8=0.0035V; vmin100n_n05l8=0.1215V; vth_n03l08=-0.1795V; ion_n03l08=0.000176617A; ioff_n03l08=4.05248e-06A; vmin1n_n03l08=0.0005V; vmin100n_n03l08=0.0085V; isup_a=0.000236789A; isup_b=0.000263574A; izero_b=1.87733e-24A; ia_flat_n05l25=01)
  - ff_125c_3.63v: PASS (vth_n05l25=-0.0045V; ion_n05l25=1.55384e-05A; ioff_n05l25=4.64526e-09A; vmin1n_n05l25=0.0095V; vmin100n_n05l25=0.2195V; vth_n05l8=-0.0075V; ion_n05l8=5.06689e-05A; ioff_n05l8=1.58675e-08A; vmin1n_n05l8=0.0035V; vmin100n_n05l8=0.1215V; vth_n03l08=-0.1795V; ion_n03l08=0.000197366A; ioff_n03l08=4.38699e-06A; vmin1n_n03l08=0.0005V; vmin100n_n03l08=0.0085V; isup_a=0.000267981A; isup_b=0.000263574A; izero_b=1.87733e-24A; ia_flat_n05l25=01)
  - sf_-40c_2.97v: PASS (vth_n05l25=0.1515V; ion_n05l25=2.07975e-05A; ioff_n05l25=2.46253e-11A; vmin1n_n05l25=0.1095V; vmin100n_n05l25=0.2925V; vth_n05l8=0.1465V; ion_n05l8=6.73691e-05A; ioff_n05l8=9.2407e-11A; vmin1n_n05l8=0.0705V; vmin100n_n05l8=0.2185V; vth_n03l08=-0.0305V; ion_n03l08=0.000195374A; ioff_n03l08=1.17402e-06A; vmin1n_n03l08=0.0005V; vmin100n_n03l08=0.0245V; isup_a=0.000284715A; isup_b=0.00037157A; izero_b=2.20214e-27A; ia_flat_n05l25=01)
  - sf_-40c_3.30v: PASS (vth_n05l25=0.1515V; ion_n05l25=2.56159e-05A; ioff_n05l25=2.4883e-11A; vmin1n_n05l25=0.1095V; vmin100n_n05l25=0.2925V; vth_n05l8=0.1465V; ion_n05l8=8.16459e-05A; ioff_n05l8=9.3499e-11A; vmin1n_n05l8=0.0705V; vmin100n_n05l8=0.2185V; vth_n03l08=-0.0305V; ion_n03l08=0.000219599A; ioff_n03l08=1.30904e-06A; vmin1n_n03l08=0.0005V; vmin100n_n03l08=0.0245V; isup_a=0.00032817A; isup_b=0.00037157A; izero_b=2.20214e-27A; ia_flat_n05l25=01)
  - sf_-40c_3.63v: PASS (vth_n05l25=0.1515V; ion_n05l25=3.09086e-05A; ioff_n05l25=2.51872e-11A; vmin1n_n05l25=0.1095V; vmin100n_n05l25=0.2925V; vth_n05l8=0.1465V; ion_n05l8=9.69721e-05A; ioff_n05l8=9.47809e-11A; vmin1n_n05l8=0.0705V; vmin100n_n05l8=0.2185V; vth_n03l08=-0.0305V; ion_n03l08=0.000243689A; ioff_n03l08=1.44905e-06A; vmin1n_n03l08=0.0005V; vmin100n_n03l08=0.0245V; isup_a=0.000373019A; isup_b=0.00037157A; izero_b=2.20214e-27A; ia_flat_n05l25=01)
  - sf_27c_2.97v: PASS (vth_n05l25=0.0815V; ion_n05l25=1.49617e-05A; ioff_n05l25=5.35533e-10A; vmin1n_n05l25=0.0355V; vmin100n_n05l25=0.2555V; vth_n05l8=0.0765V; ion_n05l8=4.94038e-05A; ioff_n05l8=1.91775e-09A; vmin1n_n05l8=0.0145V; vmin100n_n05l8=0.1685V; vth_n03l08=-0.1095V; ion_n03l08=0.000171707A; ioff_n03l08=2.66234e-06A; vmin1n_n03l08=0.0005V; vmin100n_n03l08=0.0115V; isup_a=0.000238737A; isup_b=0.00030746A; izero_b=1.25512e-22A; ia_flat_n05l25=01)
  - sf_27c_3.30v: PASS (vth_n05l25=0.0815V; ion_n05l25=1.83035e-05A; ioff_n05l25=5.39974e-10A; vmin1n_n05l25=0.0355V; vmin100n_n05l25=0.2555V; vth_n05l8=0.0765V; ion_n05l8=5.95961e-05A; ioff_n05l8=1.93628e-09A; vmin1n_n05l8=0.0145V; vmin100n_n05l8=0.1685V; vth_n03l08=-0.1095V; ion_n03l08=0.000193375A; ioff_n03l08=2.92576e-06A; vmin1n_n03l08=0.0005V; vmin100n_n03l08=0.0115V; isup_a=0.000274203A; isup_b=0.00030746A; izero_b=1.25512e-22A; ia_flat_n05l25=01)
  - sf_27c_3.63v: PASS (vth_n05l25=0.0815V; ion_n05l25=2.1967e-05A; ioff_n05l25=5.45401e-10A; vmin1n_n05l25=0.0355V; vmin100n_n05l25=0.2555V; vth_n05l8=0.0765V; ion_n05l8=7.05383e-05A; ioff_n05l8=1.95865e-09A; vmin1n_n05l8=0.0145V; vmin100n_n05l8=0.1685V; vth_n03l08=-0.1095V; ion_n03l08=0.000214955A; ioff_n03l08=3.19841e-06A; vmin1n_n03l08=0.0005V; vmin100n_n03l08=0.0115V; isup_a=0.000310661A; isup_b=0.00030746A; izero_b=1.25512e-22A; ia_flat_n05l25=01)
  - sf_125c_2.97v: PASS (vth_n05l25=-0.0245V; ion_n05l25=1.04279e-05A; ioff_n05l25=6.64959e-09A; vmin1n_n05l25=0.0075V; vmin100n_n05l25=0.2055V; vth_n05l8=-0.0275V; ion_n05l8=3.48159e-05A; ioff_n05l8=2.29861e-08A; vmin1n_n05l8=0.0025V; vmin100n_n05l8=0.1075V; vth_n03l08=-0.2205V; ion_n03l08=0.000144144A; ioff_n03l08=4.5287e-06A; vmin1n_n03l08=0.0005V; vmin100n_n03l08=0.0075V; isup_a=0.000193946A; isup_b=0.000245692A; izero_b=9.58155e-25A; ia_flat_n05l25=01)
  - sf_125c_3.30v: PASS (vth_n05l25=-0.0245V; ion_n05l25=1.26278e-05A; ioff_n05l25=6.68493e-09A; vmin1n_n05l25=0.0075V; vmin100n_n05l25=0.2055V; vth_n05l8=-0.0275V; ion_n05l8=4.16483e-05A; ioff_n05l8=2.31397e-08A; vmin1n_n05l8=0.0025V; vmin100n_n05l8=0.1075V; vth_n03l08=-0.2205V; ion_n03l08=0.00016289A; ioff_n03l08=4.879e-06A; vmin1n_n03l08=0.0005V; vmin100n_n03l08=0.0075V; isup_a=0.000222075A; isup_b=0.000245692A; izero_b=9.58155e-25A; ia_flat_n05l25=01)
  - sf_125c_3.63v: PASS (vth_n05l25=-0.0245V; ion_n05l25=1.50303e-05A; ioff_n05l25=6.73184e-09A; vmin1n_n05l25=0.0075V; vmin100n_n05l25=0.2055V; vth_n05l8=-0.0275V; ion_n05l8=4.89637e-05A; ioff_n05l8=2.33365e-08A; vmin1n_n05l8=0.0025V; vmin100n_n05l8=0.1075V; vth_n03l08=-0.2205V; ion_n03l08=0.000181698A; ioff_n03l08=5.24064e-06A; vmin1n_n03l08=0.0005V; vmin100n_n03l08=0.0075V; isup_a=0.000250962A; isup_b=0.000245692A; izero_b=9.58155e-25A; ia_flat_n05l25=01)
  - fs_-40c_2.97v: PASS (vth_n05l25=0.2395V; ion_n05l25=1.94003e-05A; ioff_n05l25=9.44449e-13A; vmin1n_n05l25=0.1965V; vmin100n_n05l25=0.3805V; vth_n05l8=0.2365V; ion_n05l8=6.3144e-05A; ioff_n05l8=3.1847e-12A; vmin1n_n05l8=0.1605V; vmin100n_n05l8=0.3085V; vth_n03l08=0.1585V; ion_n03l08=0.000177683A; ioff_n03l08=2.79028e-09A; vmin1n_n03l08=0.0455V; vmin100n_n03l08=0.1755V; isup_a=0.000260231A; isup_b=0.000346667A; izero_b=1.31484e-31A; ia_flat_n05l25=01)
  - fs_-40c_3.30v: PASS (vth_n05l25=0.2395V; ion_n05l25=2.40496e-05A; ioff_n05l25=9.5466e-13A; vmin1n_n05l25=0.1965V; vmin100n_n05l25=0.3805V; vth_n05l8=0.2365V; ion_n05l8=7.70299e-05A; ioff_n05l8=3.22274e-12A; vmin1n_n05l8=0.1605V; vmin100n_n05l8=0.3085V; vth_n03l08=0.1585V; ion_n03l08=0.000201653A; ioff_n03l08=3.13529e-09A; vmin1n_n03l08=0.0455V; vmin100n_n03l08=0.1755V; isup_a=0.000302736A; isup_b=0.000346667A; izero_b=1.31484e-31A; ia_flat_n05l25=01)
  - fs_-40c_3.63v: PASS (vth_n05l25=0.2395V; ion_n05l25=2.91714e-05A; ioff_n05l25=9.66637e-13A; vmin1n_n05l25=0.1965V; vmin100n_n05l25=0.3805V; vth_n05l8=0.2365V; ion_n05l8=9.19803e-05A; ioff_n05l8=3.26732e-12A; vmin1n_n05l8=0.1605V; vmin100n_n05l8=0.3085V; vth_n03l08=0.1585V; ion_n03l08=0.000225516A; ioff_n03l08=3.49443e-09A; vmin1n_n03l08=0.0455V; vmin100n_n03l08=0.1755V; isup_a=0.000346671A; isup_b=0.000346667A; izero_b=1.31484e-31A; ia_flat_n05l25=01)
  - fs_27c_2.97v: PASS (vth_n05l25=0.1695V; ion_n05l25=1.39717e-05A; ioff_n05l25=4.96978e-11A; vmin1n_n05l25=0.1145V; vmin100n_n05l25=0.3435V; vth_n05l8=0.1665V; ion_n05l8=4.63143e-05A; ioff_n05l8=1.64198e-10A; vmin1n_n05l8=0.0705V; vmin100n_n05l8=0.2575V; vth_n03l08=0.0805V; ion_n03l08=0.000155464A; ioff_n03l08=6.92689e-08A; vmin1n_n03l08=0.0055V; vmin100n_n03l08=0.1085V; isup_a=0.000215819A; isup_b=0.000285802A; izero_b=1.52092e-26A; ia_flat_n05l25=01)
  - fs_27c_3.30v: PASS (vth_n05l25=0.1695V; ion_n05l25=1.71984e-05A; ioff_n05l25=5.01328e-11A; vmin1n_n05l25=0.1145V; vmin100n_n05l25=0.3435V; vth_n05l8=0.1665V; ion_n05l8=5.62205e-05A; ioff_n05l8=1.65856e-10A; vmin1n_n05l8=0.0705V; vmin100n_n05l8=0.2575V; vth_n03l08=0.0805V; ion_n03l08=0.000176841A; ioff_n03l08=7.75995e-08A; vmin1n_n03l08=0.0055V; vmin100n_n03l08=0.1085V; isup_a=0.000250338A; isup_b=0.000285802A; izero_b=1.52092e-26A; ia_flat_n05l25=01)
  - fs_27c_3.63v: PASS (vth_n05l25=0.1695V; ion_n05l25=2.07455e-05A; ioff_n05l25=5.06599e-11A; vmin1n_n05l25=0.1145V; vmin100n_n05l25=0.3435V; vth_n05l8=0.1665V; ion_n05l8=6.68862e-05A; ioff_n05l8=1.67846e-10A; vmin1n_n05l8=0.0705V; vmin100n_n05l8=0.2575V; vth_n03l08=0.0805V; ion_n03l08=0.00019817A; ioff_n03l08=8.62675e-08A; vmin1n_n03l08=0.0055V; vmin100n_n03l08=0.1085V; isup_a=0.000285888A; isup_b=0.000285802A; izero_b=1.52092e-26A; ia_flat_n05l25=01)
  - fs_125c_2.97v: PASS (vth_n05l25=0.0645V; ion_n05l25=9.75472e-06A; ioff_n05l25=1.2448e-09A; vmin1n_n05l25=0.0245V; vmin100n_n05l25=0.2865V; vth_n05l8=0.0635V; ion_n05l8=3.26803e-05A; ioff_n05l8=4.05741e-09A; vmin1n_n05l8=0.0095V; vmin100n_n05l8=0.1825V; vth_n03l08=-0.0285V; ion_n03l08=0.000130225A; ioff_n03l08=6.46499e-07A; vmin1n_n03l08=0.0005V; vmin100n_n03l08=0.0385V; isup_a=0.000173312A; isup_b=0.000227898A; izero_b=2.92981e-23A; ia_flat_n05l25=01)
  - fs_125c_3.30v: PASS (vth_n05l25=0.0645V; ion_n05l25=1.18816e-05A; ioff_n05l25=1.25298e-09A; vmin1n_n05l25=0.0245V; vmin100n_n05l25=0.2865V; vth_n05l8=0.0635V; ion_n05l8=3.93199e-05A; ioff_n05l8=4.08973e-09A; vmin1n_n05l8=0.0095V; vmin100n_n05l8=0.1825V; vth_n03l08=-0.0285V; ion_n03l08=0.000148677A; ioff_n03l08=7.17473e-07A; vmin1n_n03l08=0.0005V; vmin100n_n03l08=0.0385V; isup_a=0.000200602A; isup_b=0.000227898A; izero_b=2.92981e-23A; ia_flat_n05l25=01)
  - fs_125c_3.63v: PASS (vth_n05l25=0.0645V; ion_n05l25=1.42106e-05A; ioff_n05l25=1.26338e-09A; vmin1n_n05l25=0.0245V; vmin100n_n05l25=0.2865V; vth_n05l8=0.0635V; ion_n05l8=4.64489e-05A; ioff_n05l8=4.12995e-09A; vmin1n_n05l8=0.0095V; vmin100n_n05l8=0.1825V; vth_n03l08=-0.0285V; ion_n03l08=0.000167239A; ioff_n03l08=7.91162e-07A; vmin1n_n03l08=0.0005V; vmin100n_n03l08=0.0385V; isup_a=0.000228695A; isup_b=0.000227898A; izero_b=2.92981e-23A; ia_flat_n05l25=01)
  - corner-sensitivity check on `vth_n05l25`: PASS (observed spread 0.264 over 45 points, required ≥ 0.05)
  - corner-sensitivity check on `ion_n05l25`: PASS (observed spread 2.24981e-05 over 45 points, required ≥ 1e-06)
  - **Overall: PASS**
- **Links**:
  - Testbench: `sim/native-device-characterization/testbench/tb_native_device_char.sch`
  - Netlist snapshot: `sim/native-device-characterization/netlist-snapshots/20260909-232337-c7b9b94.spice`
  - Raw per-corner logs: `sim/native-device-characterization/corners/20260909-232337-c7b9b94/`
  - Machine-readable record: `sim/native-device-characterization/records/20260909-232337-c7b9b94.json`
  - Experiment manifest: `sim/native-device-characterization/experiment.json`
- **Timestamp / author**: 2026-09-09T23:23:37Z, ci@loom.test
- **Supersedes**: (none)

Written by `sim/bin/corner-run.py`. Append-only: never edit this file — a correction is a new record with a `Supersedes` field (see `sim/README.md`).
