2AMLogic/sky130-temp-por/WORK_LOG.md

# Work Log

Chronological record of recently merged pull requests and closed issues. This file is maintained by the Loom Guide role.

## Archives

- [2026-09](work_log/WORK_LOG_2026-09.md)
- [2026-08](work_log/WORK_LOG_2026-08.md)

### 2026-11-13

- **PR #317**: fix(sim): grade the accuracy-MC `none` control three-state so an empty one cannot PASS
- **Issue #310** (closed): temp-core-accuracy-mc: negative control can PASS with zero compared samples; drop hardcoded none_max_sd_V and dead local
- **PR #316**: fix(sim): make load_corner_run() return the one registered corner_run module
- **Issue #304** (closed): Make load_corner_run() reuse the loaded module: drop three guards that still let corner-run.py load twice
- **PR #313**: fix(sim): derive the solver sweep's record PDK/Tools lines from the run
- **Issue #306** (closed): run_solver_sweep.py writes a hardcoded 'fleet runner klt 0.5.0' into record Tools lines
- **PR #311**: fix(manifests): walk list-valued evidence entries and object `file` refs in check-citations.py
- **Issue #302** (closed): check-citations.py silently skips list-valued manifest evidence entries (item 11)
- **PR #300**: refactor(sim): derive each record's fleet/host tool versions instead of hardcoding them
- **Issue #297** (closed): Share the record pdk/tools provenance block across fleet runners (7 copies; 4 hardcode stale tool versions)
- **PR #305**: feat(manifests): gate items 1 and 9 with klt's own local_only attest check
- **PR #301**: feat(manifests): re-hash attestation.checks[] files so source edits fail CI
- **Issue #299** (closed): signoff gate never re-hashes item 1 and item 9 attested files, so source edits silently stale the envelopes
- **PR #298**: fix(netlist): strip klt's klt-netlist-inputs provenance line in normalize()
- **Issue #295** (closed): design/netlist.py --check fails on main: committed netlists predate klt's klt-netlist-inputs provenance line
- **PR #296**: refactor(sim): hoist the attemptN reader, point_log and classify_error into sim_common
- **Issue #293** (closed): Consolidate six drifted attemptN readers (and point_log/classify_error) into sim_common
- **PR #294**: refactor(netlist): resolve the PDK through corner-run.py instead of a private copy
- **Issue #292** (closed): Dedupe PDK pin resolution: design/netlist.py re-implements corner-run.py's resolver (already drifted)
- **PR #290**: sim(glitch-top): fleet re-run of vdd_slew_v1.2_h0.0002_s200000 with lowered request timeout
- **Issue #181** (closed): glitch-top: re-run failed vdd_level request vdd_slew_v1.2_h0.0002_s200000 (45 ERROR points)

### 2026-11-11

- **PR #288**: chore: remove retired guard reproducer now covered upstream
- **Issue #191** (closed): Remove docs/guard-repro reproducer: stale, unreferenced test of a Loom-managed hook

### 2026-11-07

- **PR #286**: sim: measure DR-007 mirror-degen mirror-term ratio on the batch fleet
- **Issue #284** (closed): sim: measure DR-007's degenerated-mirror projection with a mirror-term MC variant run

### 2026-11-06

- **Issue #229** (closed): Live fleet verification of campaign-driver evidence storage (follow-on from PR #226)
- **PR #281**: test: run brownout campaign tests in self-checks CI, stub PDK lookup
- **Issue #280** (closed): Wire sim/brownout-top/selftest/test_brownout.py into self-checks CI; fix its 4 PDK-bound tests
- **PR #278**: chore(manifests): re-attest item 9 after runner drift
- **Issue #276** (closed): Re-attest item 9 after sim_common cap_retry refactor (#275)
- **PR #275**: refactor(sim): share fleet concurrency-cap retry in sim_common
- **Issue #274** (closed): Consolidate three copies of fleet concurrency-cap retry into sim_common

### 2026-11-05

- **PR #273**: ci: run corner-run batch and sim_common waveform tests in self-checks
- **Issue #272** (closed): Wire unrun sim/bin tests into self-checks CI (one already failing)

### 2026-11-02

- **Issue #260** (closed): T1 item 11 (power delivery): block-level temp_por_top ERC spec that accounts for the NT-biased temp_core nwells (2 erc.missing_tie)

### 2026-10-28

- **PR #265**: fix: name both graded tie classes in temp_por_top ERC ties_disclosure
- **Issue #263** (closed): temp_por_top ERC spec: ties_disclosure still says only nwell->VDD is graded
- **PR #262**: feat: add block-specific ERC supply spec for temp_por_top NT wells
- **PR #261**: fix: grade signoff items 3, 4, 11 against temp_por_top, not bias_core
- **Issue #259** (closed): T1 status: correct README and signoff-report claim that items 3, 4 and 11 are met — they grade the bias_core sub-block; block-level temp_por_top LVS is partial and ERC has 2 findings
- **PR #258**: refactor: hoist selftest record scaffolding and wave fixture writer into sim_common
- **Issue #254** (closed): Consolidate duplicated selftest record scaffolding and fixture writer into sim_common

### 2026-10-27

- **PR #256**: fix: make package.json check scripts run self-checks.yml steps instead of exiting 0
- **Issue #255** (closed): Hermit: package.json check scripts always exit 0; run the real self-checks or fail loudly
- **PR #253**: chore(klt): bump klayout-tools pin to 0.8.0 and re-render signoff evidence
- **Issue #252** (closed): Bump klayout-tools pin 758c6e224053 → 0.8.0
- **PR #251**: refactor: hoist probe, append-only guard and spiceinit loader into sim_common
- **Issue #247** (closed): Consolidate duplicated probe, append-only guard, and spiceinit loader into sim_common
- **Issue #203** (closed): Consolidate duplicated .end-stripping idiom into sim_common (10 copies)
- **PR #248**: fix: regenerate layout streams under the pinned klt and re-sync bias_core ports
- **Issue #243** (closed): Re-generate leaf layout streams under the pinned klt: committed leaf GDS now show 351 poly.endcap.diff.1 DRC violations
- **PR #246**: refactor: build campaign fleet requests through sim_common.base_request
- **Issue #245** (closed): Consolidate duplicated fleet-request scaffolding (batch block, MODEL_LIB) in campaign build_request into sim_common
- **PR #244**: feat: assemble temp_por_top GDS from the leaf streams and cite it for T1 item 2
- **Issue #240** (closed): T1 item 2 (layout): assemble the temp_por_top GDS from the committed leaf cells and cite it as block-level layout evidence

### 2026-10-23

- **PR #236**: refactor: netlist sim testbenches via klt netlist, remove raw xschem path
- **Issue #235** (closed): Remove raw-xschem netlist_with_xschem from sim harness: use netlist_with_klt everywhere
- **PR #237**: refactor(sim): share record-assembly helpers between brownout and glitch drivers
- **Issue #228** (closed): Consolidate duplicated record-assembly block in brownout/glitch campaign drivers into sim_common

- **PR #231**: sim(glitch-top): fleet subset run record with stored-evidence manifest
- **PR #233**: fix(sim): glitch record skips evidence store for empty classes
- **Issue #230** (closed): glitch-top record fails on a single-class subset run: empty stage refused for the all-NOT_COVERED class
- **PR #227**: refactor: hoist DUT .end-strip and ng_nomodcheck control into sim_common
- **Issue #225** (closed): Dedupe campaign-runner netlist boilerplate (.end strip, ng_nomodcheck banner) into sim_common
- **PR #226**: feat(sim): store campaign driver evidence in the artifact store
- **Issue #218** (closed): Adopt the common artifact store for sim evidence (manifests in git, bytes via klt artifact)
- **PR #224**: feat(signoff): attest design sources and cite the item-1 envelope
- **Issue #220** (closed): T1 item 1: run the design-source attestation through klt netlist (#193) and commit the passing envelope
- **PR #222**: feat(sim): add --backend batch to corner-run for fleet-routed PVT grids
- **Issue #219** (closed): corner-run.py: add a klt sim --backend batch path so the six local-grid experiments can be re-run on the fleet
- **PR #221**: feat(sim): route new corner-run evidence through the fleet artifact store

### 2026-10-20

- **PR #212**: refactor(design): netlist via klt netlist instead of raw xschem
- **Issue #193** (closed): Replace raw xschem call in design/netlist.py with klt netlist (drop hand-rolled PDK lookup, no timeout)
- **PR #215**: fix: refresh item-10 attestation envelope for edited self-checks.yml
- **Issue #214** (closed): signoff-manifest red on main: item-10 attestation envelope drifted after #192
- **PR #192**: fix(pdk): re-pin open_pdks to f6eeac7 via ciel and refuse a mismatched tree
- **Issue #188** (closed): Re-pin the sky130 PDK to open_pdks f6eeac7 (ciel 2.6.1) so testbenches name an installable revision (T1 item 9)
- **PR #207**: refactor(sim): share trace decimation and gz writer across checkers
- **Issue #206** (closed): Consolidate duplicated trace writer and decimation loop in sim checkers (6 copies)

### 2026-10-17

- **PR #200**: refactor(sim): consolidate corner_id, fmt and batch-submit core into sim_common
- **PR #198**: feat(signoff): attest T1 items 1, 9 and 10 via klt inventories
- **Issue #199** (closed): Consolidate corner_id/fmt and batch-submit copies into sim_common
- **Issue #186** (closed): T1 items 1, 9 and 10: commit design-source, testbench and repo-hygiene inventories and attest them with klt signoff --attest
- **PR #196**: refactor(sim): share klt_version and testbench netlist head via sim_common
- **PR #194**: docs: confirm temp_core mismatch figure and propose DR-007 accuracy design change
- **PR #190**: chore(signoff): bump klt pin to 758c6e224053 and re-render report
- **Issue #195** (closed): Dedupe sim campaign helpers: klt_version and tb_netlist_head copied across runners
- **Issue #187** (closed): temp_core accuracy: the 3-sigma mismatch error is about 25x the draft untrimmed target; confirm the figure, then propose a fix before the accuracy row can be ratified
- **Issue #185** (closed): Bump the pinned klt build to one that grades T1 items 1, 2, 9 and 10 on artifact-anchored evidence, and re-render the signoff report

### 2026-10-15

- **PR #180**: refactor(layout): retire unused lvs.dependency_variants from compose-cell
- **PR #179**: test: add guard reproducer and controls for /tmp-cwd relative writes
- **Issue #110** (closed): Remove unused LVS dependency-variant support from compose-cell.py
- **Issue #106** (closed): Brown-out and glitch-immunity matrix for assembled temp_por_top (porting-plan §3.4/§3.5)
- **Issue #88** (closed): Guard false positive: worktree write confinement rejects resolved /tmp loop paths

### 2026-10-12

- **PR #176**: sim: glitch-top POR_RAW-domain and VDD-level glitch campaign (#117)
- **Issue #117** (closed): Characterize POR_RAW-domain and VDD-level glitch immunity as distinct assembly experiments

### 2026-10-11

- **PR #172**: sim: consolidate duplicated waveform primitives into sim_common (#170)
- **PR #171**: sim: brownout-top declares reltol2e-4-klu variant and the enforced 3600 s job limit (#153)
- **PR #169**: sim: brownout-top tightened-solver (reltol2e-4) re-run harness + pilot record (#153)
- **Issue #170** (closed): Consolidate duplicated waveform primitives across ramp and brown-out checkers
- **PR #167**: sim: temp-core accuracy Monte Carlo campaign with per-term error budget (#105)
- **PR #166**: ci: preserve frozen netlist snapshots and corner evidence as append-only (#165)
- **PR #163**: ci: enforce append-only simulation records against the Git baseline
- **PR #161**: Solver-sensitivity replicate for natural-release iq-total (45 points x 3 variants)
- **PR #158**: ci: gate brown-out checker synthetic verdict cases
- **Issue #105** (closed): Full-signal-path mismatch Monte Carlo for temp_core accuracy (DR-003 TBD-1, T1 item 6)
- **Issue #165** (closed): Preserve frozen simulation decks and raw corner evidence in CI
- **Issue #164** (closed): Auditor Capability Request: Python interpreter for local evidence checks
- **Issue #162** (closed): CI: enforce append-only simulation records against the Git baseline
- **Issue #160** (closed): Resolve assembled iq-total exclusions with a full-grid solver-sensitivity replicate
- **Issue #159** (closed): Guard decision: retain confirmation for detached-checkout hard resets
- **Issue #156** (closed): CI: gate the brown-out checker synthetic verdict cases
- **Issue #155** (closed): Guard decision: retain confirmation for main-checkout stash

### 2026-10-10

- **PR #154**: sim: as-drawn brown-out campaign over independent dip axes x PVT (#116)
- **PR #152**: sim: EN-high base control lands; six temp_core cold-start FAILs not reproduced on any variant
- **Issue #116** (closed): As-drawn brown-out campaign: independent depth, duration and falling-slew matrix
- **Issue #86** (closed): temp_core startup records fail at six points inside the ratified envelope; demonstrate or record the cause

- **PR #150**: sim: diagnose the two RESETn re-assertions in the as-drawn ramp campaign (#142)
- **PR #149**: sim: solver/ramp discrimination sweep of temp_core cold-start FAILs (partial; fleet capacity)
- **Issue #142** (closed): supply-ramp-top: RESETn re-asserts after release at 2 of 360 as-drawn PVT/ramp points
- **PR #147**: refactor(sim): consolidate klt_version/load_manifest/load_wave into sim_common
- **Issue #140** (closed): Consolidate duplicated klt_version/load_manifest/load_wave helpers into sim_common.py (load_wave has drifted)
- **PR #145**: pad-island-census: cross-net merge check, gated sibling fallback, 3-state frame (#92)
- **PR #144**: bias_core: declare nwell->VDD tie, disclose p_substrate; T1 item 11 met (#90)
- **PR #143**: sim(supply-ramp-top): as-drawn 360-point fleet campaign after XMN1 fix (#101)
- **PR #141**: Post-layout (klt extract/pex) re-run of the por_comparator threshold campaign (T1 item 7)
- **Issue #92** (closed): pad-island-census: fail on cross-net island merges and gate the unpromoted-sibling-port fallback
- **Issue #90** (closed): bias_core ERC: declare (or disclose) well/substrate ties so T1 item 11 grades past supply_spec_incomplete
- **Issue #101** (closed): por_output_chain: XMN1 (L=25) has no valid model bin in the pinned PDK, so as-drawn temp_por_top cannot be simulated
- **Issue #124** (closed): Post-layout (klt pex) re-run of the por_comparator threshold campaign (T1 item 7)
- **Issue #132** (closed): Guard decision: retain main-checkout write confinement for sweep checkpoint writes

### 2026-10-09

- **PR #139**: docs(spec): DR-006 proposed Iq rows recommendation (TBD-4/5/6)
- **Issue #136** (closed): Draft DR recommending sky130 Iq rows (TBD-4/5/6) from committed iq-top evidence
- **PR #135**: Reject non-finite and malformed waveforms before Iq grading
- **PR #131**: docs(spec): align spec/README.md with DR-003 ratification (#127)
- **PR #134**: docs(spec): DR-005 proposed temp_buffer scope and PTAT/CTAT load assumption (#125)
- **PR #130**: docs(spec): DR-004 proposed sky130 POR threshold/hysteresis/ramp recommendation
- **PR #128**: Refresh characterization report and add coverage guard (#122)
- **PR #126**: docs(readme): align ratification-status statements with DR-003
- **Issue #133** (closed): Reject non-finite and malformed waveforms before Iq grading
- **Issue #127** (closed): spec/README.md: decision-records bullet says DR-003 is still proposed (ratified scoped to rows 1 and 6)
- **Issue #125** (closed): Decide temp_buffer scope and the Sensor-output row via a decision record
- **Issue #123** (closed): Draft DR recommending sky130 VPOR↑/VPOR↓, hysteresis and supply-ramp rows from committed #98/#102 evidence (T1 item 5)
- **Issue #122** (closed): Refresh the stale characterization report and add coverage guard so it cannot silently rot (T1 item 8)
- **Issue #85** (closed): README: ratification-status paragraphs outside the target table are stale after DR-003 rows 1 and 6 were ratified
- **PR #121**: sim(iq-top): assembled temp_por_top Iq campaign, por-iq / iq-total / temp-iq (#107)
- **Issue #107** (closed): Block-assembly Iq characterization: por-iq, temp-iq, iq-total (DR-003 TBD-4/5/6)
- **PR #119**: sim: record fleet refusal of as-drawn supply-ramp re-run (#101)
- **PR #115**: refactor(sim): hoist duplicated campaign-runner helpers into sim_common (#114)
- **PR #113**: sim: por_comparator VPOR-up/VPOR-down/hysteresis over PVT (por-comparator-thresholds campaign)
- **Issue #114** (closed): Consolidate duplicated helpers across the two batch campaign runners into sim_common.py
- **Issue #102** (closed): Characterize por_comparator VPOR↑/VPOR↓ and hysteresis over PVT (resolves DR-003 TBD-2/TBD-3 evidence gap)
- **Issue #96** (closed): Guard decision: retain confirmation for untracked layout cleanup
- **PR #111**: fix: por_output_chain XMN1 to a legal nfet_g5v0d10v5 model bin (L=20 W=0.42) (#101)
- **PR #109**: layout: add temp_core leaf cell (DRC clean, LVS match 48/48, no exclusions)
- **PR #108**: ci: run repo self-checks on every push (#103)
- **PR #100**: sim: assembled temp_por_top supply-ramp campaign across rates and PVT
- **PR #99**: layout: por_output_chain leaf (DRC clean, LVS match minus native XMASSIST) (#97)
- **PR #95**: layout: por_comparator leaf cell (21 devices), DRC clean, LVS match (#82)
- **Issue #104** (closed): Lay out temp_core as a DRC/LVS-verified leaf (T1 item 2)
- **Issue #103** (closed): CI: run the repo's existing self-checks (netlist export, checker selftests) on every push
- **Issue #98** (closed): Record assembled temp_por_top supply-ramp behavior across rates and PVT
- **Issue #82** (closed): T1 item 2: lay out por_comparator (21 devices) with the compose-cell recipe, DRC clean and LVS matched

### 2026-10-08

- **Issue #34** (closed): T1 item 2/10 continued: remaining bias_core device groups + full-cell assembly
- **PR #91**: bias_core: wire all cross-block nets on met3-met5, LVS match 50/50 devices, 27/27 nets (#81)
- **PR #87**: docs: block-level characterization report (T1 item 8)
- **PR #83**: spec: ratify DR-003 via the two-key ceremony (operating temperature + supply rows only)
- **Issue #81** (closed): bias_core: wire the nine remaining cross-block nets on the met3–met5 planes klayout-tools#2738 added (T1 items 4 and 11)
- **Issue #64** (closed): bias_core: wire remaining cross-block nets (pg/pb/n2/na/nbtop/VREF/nokx) once layer-assignment tooling improves
- **Issue #40** (closed): bias_core: full-cell assembly (compose all device-group sub-blocks)
- **Issue #31** (closed): T1 item 8/10: aggregate a block-level characterization report
- **Issue #78** (closed): Run the two-key ratification ceremony on DR-003 (target-spec table)

### 2026-09-23

- **PR #77**: fix: strap PNP collectors to VSS and reach LVS match on klt 0.6.0
- **PR #76**: docs: embed fleet burndown chart in README
- **Issue #30** (closed): T1 item 2/10: lay out bias_core (first increment toward layout)
- **Issue #75** (closed): README: embed the fleet burndown chart (one line)

### 2026-09-21

- **PR #73**: fix: land bias_core supply legs on the real pads (block-local ports)
- **PR #72**: refactor: drop dead helpers and stale doc claims from sim_common.py
- **PR #70**: feat: add klt erc supply spec and report for bias_core (T1 item 11)
- **PR #68**: feat: add klt signoff block manifest as the T1 verdict of record
- **Issue #69** (closed): bias_core assembly: supply routes are single continuous rail islands but connect to none of the blocks' internal supply pads
- **Issue #71** (closed): Remove dead parse_measurements()/_cr() and write_log() from sim_common.py: zero callers, stale 'actually used' docstring claims
- **Issue #66** (closed): T1 item 11 (power delivery, structural): no klt erc supply spec or report in this repo
- **Issue #67** (closed): Commit a klt signoff block manifest so this block's T1 state is graded, not hand-read

### 2026-09-17

- **PR #65**: feat: compose bias_core sub-blocks into one DRC-clean assembly
- **PR #63**: layout: promote ec/vss (pnp8_leg) and vss (xq1_xqr) external pins
- **Issue #61** (closed): bias_core: promote ec/vss (pnp8_leg) and vss (xq1_xqr) external pins once the closed-collector-ring escape restriction is addressed

### 2026-09-16

- **PR #62**: layout: promote missing external pins on bias_core sub-blocks
- **PR #60**: docs: fix stale narrative in design/netlist.py module docstring
- **PR #58**: Docs: correct stale "empty"/"pre-spec" status claims
- **PR #55**: layout: unambiguous klt commit pin + pin-mismatch warning
- **PR #54**: chore: remove unused shutil import in run_op_branch.py
- **PR #52**: layout: compose bias_core's current-mirror + error-amp stack, DRC- and LVS-clean
- **PR #50**: chore: remove dead run_ngspice()/mc_control_block() from sim_common.py
- **PR #48**: layout: bias_core startup kick chain, DRC- and LVS-clean
- **PR #47**: layout: trim residual fictional references in _klt_common.py docstrings
- **PR #46**: layout: compose bias_core's settle-flag output stage (BIAS_OK), DRC- and LVS-clean
- **Issue #56** (closed): bias_core: promote missing external pins on mirror_amp/settle_flag for full-cell assembly
- **Issue #59** (closed): design/netlist.py: module docstring is stale — temp_por_top/sim-harness claims no longer true
- **Issue #57** (closed): Docs: README.md and chipalooza proposal still claim the repo is empty/pre-spec
- **Issue #51** (closed): layout: host klt install is 38 commits behind layout/pdk.json's klt_version_pin, so compose-cell.py --check fails on every existing cell
- **Issue #53** (closed): Remove unused shutil import: run_op_branch.py
- **Issue #35** (closed): bias_core layout: PFET/NFET current-mirror + error-amp stack
- **Issue #49** (closed): Dead code + duplicated ngspice-run logic in sim/bin/sim_common.py
- **Issue #38** (closed): bias_core layout: startup kick chain
- **Issue #45** (closed): Trim residual fictional references in _klt_common.py's function docstrings (follow-up to #42)
- **Issue #39** (closed): bias_core layout: settle-flag output stage (BIAS_OK)

### 2026-09-15

- **PR #44**: docs: rewrite _klt_common.py module docstring to match this repo
- **PR #43**: layout: bias_core bias/ratio resistors + Miller caps sub-block
- **PR #41**: feat: lay out bias_core's XQ1/XQR reference PNPs (DRC-clean, LVS-blocked)
- **PR #33**: layout: port compose-cell recipe, lay out bias_core's 8:1 PNP leg
- **PR #32**: docs: DR-003, recommended target-spec table values with sim evidence
- **Issue #42** (closed): Fix fictional provenance narrative in layout/bin/_klt_common.py's docstring
- **Issue #37** (closed): bias_core layout: bias/ratio resistors + Miller compensation caps
- **Issue #36** (closed): bias_core layout: XQ1/XQR reference PNPs (collector-strap blocked in part)
- **Issue #29** (closed): T1 item 5/10: ratify the target spec table as a decision-record PR
