2AMLogic/sky130-temp-por/work_log/WORK_LOG_2026-09.md

# Work Log Archive — 2026-09

Sections moved byte-for-byte from [WORK_LOG.md](../WORK_LOG.md) by `loom-daemon work-docs archive`.

### 2026-09-09

- **PR #28**: sim: characterize sky130 native devices (nfet_05v0_nvt vs nfet_03v3_nvt) for MASSIST
- **Issue #27** (closed): Characterize sky130's native devices (nfet_05v0_nvt vs nfet_03v3_nvt) for the POR startup-assist leg: Vth spread, minimum operating voltage, and MASSIST's always-on static current over PVT (porting-plan §2.6 / §4 item 2)
