2AMLogic/sky130-temp-por/design/netlist/por_output_chain.spice

* por_output_chain -- generated by design/netlist.py from design/por_output_chain.sch
* Do not edit: edit the schematic and re-run the export.
** sch_path: design/por_output_chain.sch
.subckt por_output_chain VDD VSS IBIAS POR_RAW RESETn
*.PININFO VDD:B VSS:B IBIAS:I POR_RAW:I RESETn:O
XMBD IBIAS IBIAS VSS VSS sky130_fd_pr__nfet_g5v0d10v5 L=4 W=4 nf=1 ad=1.16 as=1.16 pd=8.58 ps=8.58 nrd=0.0725 nrs=0.0725 sa=0 sb=0
+ sd=0 mult=1 m=1
XMN1 PDN IBIAS VSS VSS sky130_fd_pr__nfet_g5v0d10v5 L=20 W=0.42 nf=1 ad=0.1218 as=0.1218 pd=1.42 ps=1.42 nrd=0.69047619047619
+ nrs=0.69047619047619 sa=0 sb=0 sd=0 mult=1 m=1
XMPD PDN PDN VDD VDD sky130_fd_pr__pfet_g5v0d10v5 L=10 W=2 nf=1 ad=0.58 as=0.58 pd=4.58 ps=4.58 nrd=0.145 nrs=0.145 sa=0 sb=0 sd=0
+ mult=1 m=1
XMP2 NDL PDN VDD VDD sky130_fd_pr__pfet_g5v0d10v5 L=10 W=2 nf=1 ad=0.58 as=0.58 pd=4.58 ps=4.58 nrd=0.145 nrs=0.145 sa=0 sb=0 sd=0
+ mult=1 m=1
XMND NDL NDL VSS VSS sky130_fd_pr__nfet_g5v0d10v5 L=10 W=2 nf=1 ad=0.58 as=0.58 pd=4.58 ps=4.58 nrd=0.145 nrs=0.145 sa=0 sb=0 sd=0
+ mult=1 m=1
XMDGPT NDGP PDN VDD VDD sky130_fd_pr__pfet_g5v0d10v5 L=10 W=10 nf=1 ad=2.9 as=2.9 pd=20.58 ps=20.58 nrd=0.029 nrs=0.029 sa=0 sb=0
+ sd=0 mult=1 m=1
XMDGPI NDG POR_RAW NDGP VDD sky130_fd_pr__pfet_g5v0d10v5 L=0.5 W=1 nf=1 ad=0.29 as=0.29 pd=2.58 ps=2.58 nrd=0.29 nrs=0.29 sa=0
+ sb=0 sd=0 mult=1 m=1
XMDGNI NDG POR_RAW NDGN VSS sky130_fd_pr__nfet_g5v0d10v5 L=0.5 W=1 nf=1 ad=0.29 as=0.29 pd=2.58 ps=2.58 nrd=0.29 nrs=0.29 sa=0
+ sb=0 sd=0 mult=1 m=1
XMDGNT NDGN NDL VSS VSS sky130_fd_pr__nfet_g5v0d10v5 L=10 W=10 nf=1 ad=2.9 as=2.9 pd=20.58 ps=20.58 nrd=0.029 nrs=0.029 sa=0 sb=0
+ sd=0 mult=1 m=1
XCDG NDG VSS sky130_fd_pr__cap_mim_m3_1 W=11 L=11 MF=1 m=1
XMG1P PGDG NDG VDD VDD sky130_fd_pr__pfet_g5v0d10v5 L=2 W=0.5 nf=1 ad=0.145 as=0.145 pd=1.58 ps=1.58 nrd=0.58 nrs=0.58 sa=0 sb=0
+ sd=0 mult=1 m=1
XMG1N PGDG NDG VSS VSS sky130_fd_pr__nfet_g5v0d10v5 L=0.5 W=2 nf=1 ad=0.58 as=0.58 pd=4.58 ps=4.58 nrd=0.145 nrs=0.145 sa=0 sb=0
+ sd=0 mult=1 m=1
XMG2P PGDGB PGDG VDD VDD sky130_fd_pr__pfet_g5v0d10v5 L=0.5 W=2 nf=1 ad=0.58 as=0.58 pd=4.58 ps=4.58 nrd=0.145 nrs=0.145 sa=0 sb=0
+ sd=0 mult=1 m=1
XMG2N PGDGB PGDG VSS VSS sky130_fd_pr__nfet_g5v0d10v5 L=2 W=0.5 nf=1 ad=0.145 as=0.145 pd=1.58 ps=1.58 nrd=0.58 nrs=0.58 sa=0 sb=0
+ sd=0 mult=1 m=1
XMPT NTS PDN VDD VDD sky130_fd_pr__pfet_g5v0d10v5 L=10 W=0.5 nf=1 ad=0.145 as=0.145 pd=1.58 ps=1.58 nrd=0.58 nrs=0.58 sa=0 sb=0
+ sd=0 mult=1 m=1
XMTSW TIM PGDGB NTS VDD sky130_fd_pr__pfet_g5v0d10v5 L=1 W=2 nf=1 ad=0.58 as=0.58 pd=4.58 ps=4.58 nrd=0.145 nrs=0.145 sa=0 sb=0
+ sd=0 mult=1 m=1
XMDIS TIM PGDGB VSS VSS sky130_fd_pr__nfet_g5v0d10v5 L=1 W=1 nf=1 ad=0.29 as=0.29 pd=2.58 ps=2.58 nrd=0.29 nrs=0.29 sa=0 sb=0 sd=0
+ mult=1 m=1
XCTIM TIM VSS sky130_fd_pr__cap_mim_m3_1 W=28 L=28 MF=4 m=4
XMDAPI ND1 TIM VDD VDD sky130_fd_pr__pfet_g5v0d10v5 L=1 W=2 nf=1 ad=0.58 as=0.58 pd=4.58 ps=4.58 nrd=0.145 nrs=0.145 sa=0 sb=0
+ sd=0 mult=1 m=1
XMDANT ND1 NDL VSS VSS sky130_fd_pr__nfet_g5v0d10v5 L=10 W=0.5 nf=1 ad=0.145 as=0.145 pd=1.58 ps=1.58 nrd=0.58 nrs=0.58 sa=0 sb=0
+ sd=0 mult=1 m=1
XMDBNI TRIP ND1 VSS VSS sky130_fd_pr__nfet_g5v0d10v5 L=1 W=1 nf=1 ad=0.29 as=0.29 pd=2.58 ps=2.58 nrd=0.29 nrs=0.29 sa=0 sb=0 sd=0
+ mult=1 m=1
XMDBPT TRIP PDN VDD VDD sky130_fd_pr__pfet_g5v0d10v5 L=10 W=0.5 nf=1 ad=0.145 as=0.145 pd=1.58 ps=1.58 nrd=0.58 nrs=0.58 sa=0 sb=0
+ sd=0 mult=1 m=1
XMRLK ND1 RESETn VSS VSS sky130_fd_pr__nfet_g5v0d10v5 L=1 W=1 nf=1 ad=0.29 as=0.29 pd=2.58 ps=2.58 nrd=0.29 nrs=0.29 sa=0 sb=0
+ sd=0 mult=1 m=1
XMNAP1 RSTB TRIP VDD VDD sky130_fd_pr__pfet_g5v0d10v5 L=0.5 W=4 nf=1 ad=1.16 as=1.16 pd=8.58 ps=8.58 nrd=0.0725 nrs=0.0725 sa=0
+ sb=0 sd=0 mult=1 m=1
XMNAP2 RSTB PGDG VDD VDD sky130_fd_pr__pfet_g5v0d10v5 L=0.5 W=4 nf=1 ad=1.16 as=1.16 pd=8.58 ps=8.58 nrd=0.0725 nrs=0.0725 sa=0
+ sb=0 sd=0 mult=1 m=1
XMNAN1 RSTB TRIP NNAND VSS sky130_fd_pr__nfet_g5v0d10v5 L=0.5 W=2 nf=1 ad=0.58 as=0.58 pd=4.58 ps=4.58 nrd=0.145 nrs=0.145 sa=0
+ sb=0 sd=0 mult=1 m=1
XMNAN2 NNAND PGDG VSS VSS sky130_fd_pr__nfet_g5v0d10v5 L=0.5 W=2 nf=1 ad=0.58 as=0.58 pd=4.58 ps=4.58 nrd=0.145 nrs=0.145 sa=0
+ sb=0 sd=0 mult=1 m=1
XMAST RSTB RESETn VDD VDD sky130_fd_pr__pfet_g5v0d10v5 L=10 W=0.5 nf=1 ad=0.145 as=0.145 pd=1.58 ps=1.58 nrd=0.58 nrs=0.58 sa=0
+ sb=0 sd=0 mult=1 m=1
XMOP RESETn RSTB VDD VDD sky130_fd_pr__pfet_g5v0d10v5 L=1 W=1 nf=1 ad=0.29 as=0.29 pd=2.58 ps=2.58 nrd=0.29 nrs=0.29 sa=0 sb=0
+ sd=0 mult=1 m=1
XMON RESETn RSTB VSS VSS sky130_fd_pr__nfet_g5v0d10v5 L=0.5 W=10 nf=1 ad=2.9 as=2.9 pd=20.58 ps=20.58 nrd=0.029 nrs=0.029 sa=0
+ sb=0 sd=0 mult=1 m=1
XMASSIST RESETn VDD VSS VSS sky130_fd_pr__nfet_05v0_nvt L=25 W=1 nf=1 ad=0.29 as=0.29 pd=2.58 ps=2.58 nrd=0.29 nrs=0.29 sa=0 sb=0
+ sd=0 mult=1 m=1
.ends
