2AMLogic/sky130-temp-por/layout/por_output_chain/por_output_chain.ref.spice

* Reference netlist for por_output_chain LVS -- GENERATED by layout/bin/compose-cell.py
* Source: design/netlist/por_output_chain.spice .subckt por_output_chain
* Only unit spellings (and any substituted subckt parameter)
* differ from the source -- see compose-cell.py's docstring.
.subckt por_output_chain VDD VSS IBIAS POR_RAW RESETn
*.PININFO VDD:B VSS:B IBIAS:I POR_RAW:I RESETn:O
XMBD IBIAS IBIAS VSS VSS sky130_fd_pr__nfet_g5v0d10v5 L=4u W=4u nf=1 ad=1.16 as=1.16 pd=8.58 ps=8.58 nrd=0.0725 nrs=0.0725 sa=0 sb=0
+ sd=0 mult=1 m=1
XMN1 PDN IBIAS VSS VSS sky130_fd_pr__nfet_g5v0d10v5 L=20u W=0.42u nf=1 ad=0.1218 as=0.1218 pd=1.42 ps=1.42 nrd=0.69047619047619
+ nrs=0.69047619047619 sa=0 sb=0 sd=0 mult=1 m=1
XMPD PDN PDN VDD VDD sky130_fd_pr__pfet_g5v0d10v5 L=10u W=2u nf=1 ad=0.58 as=0.58 pd=4.58 ps=4.58 nrd=0.145 nrs=0.145 sa=0 sb=0 sd=0
+ mult=1 m=1
XMP2 NDL PDN VDD VDD sky130_fd_pr__pfet_g5v0d10v5 L=10u W=2u nf=1 ad=0.58 as=0.58 pd=4.58 ps=4.58 nrd=0.145 nrs=0.145 sa=0 sb=0 sd=0
+ mult=1 m=1
XMND NDL NDL VSS VSS sky130_fd_pr__nfet_g5v0d10v5 L=10u W=2u nf=1 ad=0.58 as=0.58 pd=4.58 ps=4.58 nrd=0.145 nrs=0.145 sa=0 sb=0 sd=0
+ mult=1 m=1
XMDGPT NDGP PDN VDD VDD sky130_fd_pr__pfet_g5v0d10v5 L=10u W=10u nf=1 ad=2.9 as=2.9 pd=20.58 ps=20.58 nrd=0.029 nrs=0.029 sa=0 sb=0
+ sd=0 mult=1 m=1
XMDGPI NDG POR_RAW NDGP VDD sky130_fd_pr__pfet_g5v0d10v5 L=0.5u W=1u nf=1 ad=0.29 as=0.29 pd=2.58 ps=2.58 nrd=0.29 nrs=0.29 sa=0
+ sb=0 sd=0 mult=1 m=1
XMDGNI NDG POR_RAW NDGN VSS sky130_fd_pr__nfet_g5v0d10v5 L=0.5u W=1u nf=1 ad=0.29 as=0.29 pd=2.58 ps=2.58 nrd=0.29 nrs=0.29 sa=0
+ sb=0 sd=0 mult=1 m=1
XMDGNT NDGN NDL VSS VSS sky130_fd_pr__nfet_g5v0d10v5 L=10u W=10u nf=1 ad=2.9 as=2.9 pd=20.58 ps=20.58 nrd=0.029 nrs=0.029 sa=0 sb=0
+ sd=0 mult=1 m=1
XCDG NDG VSS sky130_fd_pr__cap_mim_m3_1 W=11u L=11u MF=1 m=1
XMG1P PGDG NDG VDD VDD sky130_fd_pr__pfet_g5v0d10v5 L=2u W=0.5u nf=1 ad=0.145 as=0.145 pd=1.58 ps=1.58 nrd=0.58 nrs=0.58 sa=0 sb=0
+ sd=0 mult=1 m=1
XMG1N PGDG NDG VSS VSS sky130_fd_pr__nfet_g5v0d10v5 L=0.5u W=2u nf=1 ad=0.58 as=0.58 pd=4.58 ps=4.58 nrd=0.145 nrs=0.145 sa=0 sb=0
+ sd=0 mult=1 m=1
XMG2P PGDGB PGDG VDD VDD sky130_fd_pr__pfet_g5v0d10v5 L=0.5u W=2u nf=1 ad=0.58 as=0.58 pd=4.58 ps=4.58 nrd=0.145 nrs=0.145 sa=0 sb=0
+ sd=0 mult=1 m=1
XMG2N PGDGB PGDG VSS VSS sky130_fd_pr__nfet_g5v0d10v5 L=2u W=0.5u nf=1 ad=0.145 as=0.145 pd=1.58 ps=1.58 nrd=0.58 nrs=0.58 sa=0 sb=0
+ sd=0 mult=1 m=1
XMPT NTS PDN VDD VDD sky130_fd_pr__pfet_g5v0d10v5 L=10u W=0.5u nf=1 ad=0.145 as=0.145 pd=1.58 ps=1.58 nrd=0.58 nrs=0.58 sa=0 sb=0
+ sd=0 mult=1 m=1
XMTSW TIM PGDGB NTS VDD sky130_fd_pr__pfet_g5v0d10v5 L=1u W=2u nf=1 ad=0.58 as=0.58 pd=4.58 ps=4.58 nrd=0.145 nrs=0.145 sa=0 sb=0
+ sd=0 mult=1 m=1
XMDIS TIM PGDGB VSS VSS sky130_fd_pr__nfet_g5v0d10v5 L=1u W=1u nf=1 ad=0.29 as=0.29 pd=2.58 ps=2.58 nrd=0.29 nrs=0.29 sa=0 sb=0 sd=0
+ mult=1 m=1
XCTIM_0 TIM VSS sky130_fd_pr__cap_mim_m3_1 W=28u L=28u MF=1 m=1
XCTIM_1 TIM VSS sky130_fd_pr__cap_mim_m3_1 W=28u L=28u MF=1 m=1
XCTIM_2 TIM VSS sky130_fd_pr__cap_mim_m3_1 W=28u L=28u MF=1 m=1
XCTIM_3 TIM VSS sky130_fd_pr__cap_mim_m3_1 W=28u L=28u MF=1 m=1
XMDAPI ND1 TIM VDD VDD sky130_fd_pr__pfet_g5v0d10v5 L=1u W=2u nf=1 ad=0.58 as=0.58 pd=4.58 ps=4.58 nrd=0.145 nrs=0.145 sa=0 sb=0
+ sd=0 mult=1 m=1
XMDANT ND1 NDL VSS VSS sky130_fd_pr__nfet_g5v0d10v5 L=10u W=0.5u nf=1 ad=0.145 as=0.145 pd=1.58 ps=1.58 nrd=0.58 nrs=0.58 sa=0 sb=0
+ sd=0 mult=1 m=1
XMDBNI TRIP ND1 VSS VSS sky130_fd_pr__nfet_g5v0d10v5 L=1u W=1u nf=1 ad=0.29 as=0.29 pd=2.58 ps=2.58 nrd=0.29 nrs=0.29 sa=0 sb=0 sd=0
+ mult=1 m=1
XMDBPT TRIP PDN VDD VDD sky130_fd_pr__pfet_g5v0d10v5 L=10u W=0.5u nf=1 ad=0.145 as=0.145 pd=1.58 ps=1.58 nrd=0.58 nrs=0.58 sa=0 sb=0
+ sd=0 mult=1 m=1
XMRLK ND1 RESETn VSS VSS sky130_fd_pr__nfet_g5v0d10v5 L=1u W=1u nf=1 ad=0.29 as=0.29 pd=2.58 ps=2.58 nrd=0.29 nrs=0.29 sa=0 sb=0
+ sd=0 mult=1 m=1
XMNAP1 RSTB TRIP VDD VDD sky130_fd_pr__pfet_g5v0d10v5 L=0.5u W=4u nf=1 ad=1.16 as=1.16 pd=8.58 ps=8.58 nrd=0.0725 nrs=0.0725 sa=0
+ sb=0 sd=0 mult=1 m=1
XMNAP2 RSTB PGDG VDD VDD sky130_fd_pr__pfet_g5v0d10v5 L=0.5u W=4u nf=1 ad=1.16 as=1.16 pd=8.58 ps=8.58 nrd=0.0725 nrs=0.0725 sa=0
+ sb=0 sd=0 mult=1 m=1
XMNAN1 RSTB TRIP NNAND VSS sky130_fd_pr__nfet_g5v0d10v5 L=0.5u W=2u nf=1 ad=0.58 as=0.58 pd=4.58 ps=4.58 nrd=0.145 nrs=0.145 sa=0
+ sb=0 sd=0 mult=1 m=1
XMNAN2 NNAND PGDG VSS VSS sky130_fd_pr__nfet_g5v0d10v5 L=0.5u W=2u nf=1 ad=0.58 as=0.58 pd=4.58 ps=4.58 nrd=0.145 nrs=0.145 sa=0
+ sb=0 sd=0 mult=1 m=1
XMAST RSTB RESETn VDD VDD sky130_fd_pr__pfet_g5v0d10v5 L=10u W=0.5u nf=1 ad=0.145 as=0.145 pd=1.58 ps=1.58 nrd=0.58 nrs=0.58 sa=0
+ sb=0 sd=0 mult=1 m=1
XMOP RESETn RSTB VDD VDD sky130_fd_pr__pfet_g5v0d10v5 L=1u W=1u nf=1 ad=0.29 as=0.29 pd=2.58 ps=2.58 nrd=0.29 nrs=0.29 sa=0 sb=0
+ sd=0 mult=1 m=1
XMON RESETn RSTB VSS VSS sky130_fd_pr__nfet_g5v0d10v5 L=0.5u W=10u nf=1 ad=2.9 as=2.9 pd=20.58 ps=20.58 nrd=0.029 nrs=0.029 sa=0
+ sb=0 sd=0 mult=1 m=1
.ends
