2AMLogic/sky130-temp-por/layout/temp_core/temp_core.ref.spice

* Reference netlist for temp_core LVS -- GENERATED by layout/bin/compose-cell.py
* Source: design/netlist/temp_core.spice .subckt temp_core
* Only unit spellings (and any substituted subckt parameter)
* differ from the source -- see compose-cell.py's docstring.
.subckt temp_core VDD VSS IBIAS EN PTAT CTAT
*.PININFO VDD:B VSS:B IBIAS:I EN:I PTAT:O CTAT:O
XMBD IBIAS NBG VSS VSS sky130_fd_pr__nfet_g5v0d10v5 L=2u W=4u nf=1 ad=1.16 as=1.16 pd=8.58 ps=8.58 nrd=0.0725 nrs=0.0725 sa=0 sb=0
+ sd=0 mult=1 m=1
XMPASS IBIAS EN NBG VSS sky130_fd_pr__nfet_g5v0d10v5 L=0.5u W=2u nf=1 ad=0.58 as=0.58 pd=4.58 ps=4.58 nrd=0.145 nrs=0.145 sa=0 sb=0
+ sd=0 mult=1 m=1
XMDNB NBG ENB VSS VSS sky130_fd_pr__nfet_g5v0d10v5 L=0.5u W=2u nf=1 ad=0.58 as=0.58 pd=4.58 ps=4.58 nrd=0.145 nrs=0.145 sa=0 sb=0
+ sd=0 mult=1 m=1
XMBN1 PB NBG VSS VSS sky130_fd_pr__nfet_g5v0d10v5 L=2u W=4u nf=1 ad=1.16 as=1.16 pd=8.58 ps=8.58 nrd=0.0725 nrs=0.0725 sa=0 sb=0
+ sd=0 mult=1 m=1
XMBP PB PB VDD VDD sky130_fd_pr__pfet_g5v0d10v5 L=4u W=10u nf=1 ad=2.9 as=2.9 pd=20.58 ps=20.58 nrd=0.029 nrs=0.029 sa=0 sb=0 sd=0
+ mult=1 m=1
XMBN2 PCAS NBG VSS VSS sky130_fd_pr__nfet_g5v0d10v5 L=2u W=4u nf=1 ad=1.16 as=1.16 pd=8.58 ps=8.58 nrd=0.0725 nrs=0.0725 sa=0 sb=0
+ sd=0 mult=1 m=1
XMCB PCAS PCAS VDD VDD sky130_fd_pr__pfet_g5v0d10v5 L=8u W=1u nf=1 ad=0.29 as=0.29 pd=2.58 ps=2.58 nrd=0.29 nrs=0.29 sa=0 sb=0 sd=0
+ mult=1 m=1
XMINVP ENB EN VDD VDD sky130_fd_pr__pfet_g5v0d10v5 L=0.5u W=2u nf=1 ad=0.58 as=0.58 pd=4.58 ps=4.58 nrd=0.145 nrs=0.145 sa=0 sb=0
+ sd=0 mult=1 m=1
XMINVN ENB EN VSS VSS sky130_fd_pr__nfet_g5v0d10v5 L=0.5u W=1u nf=1 ad=0.29 as=0.29 pd=2.58 ps=2.58 nrd=0.29 nrs=0.29 sa=0 sb=0 sd=0
+ mult=1 m=1
XMT NT PB VDD VDD sky130_fd_pr__pfet_g5v0d10v5 L=4u W=20u nf=1 ad=5.8 as=5.8 pd=40.58 ps=40.58 nrd=0.0145 nrs=0.0145 sa=0 sb=0 sd=0
+ mult=1 m=1
XMI1 N1 NA NT NT sky130_fd_pr__pfet_g5v0d10v5 L=4u W=32u nf=1 ad=9.28 as=9.28 pd=64.58 ps=64.58 nrd=0.0090625 nrs=0.0090625 sa=0
+ sb=0 sd=0 mult=1 m=1
XMI2 N2 NB NT NT sky130_fd_pr__pfet_g5v0d10v5 L=4u W=32u nf=1 ad=9.28 as=9.28 pd=64.58 ps=64.58 nrd=0.0090625 nrs=0.0090625 sa=0
+ sb=0 sd=0 mult=1 m=1
XML1 N1 N1 VSS VSS sky130_fd_pr__nfet_g5v0d10v5 L=8u W=8u nf=1 ad=2.32 as=2.32 pd=16.58 ps=16.58 nrd=0.03625 nrs=0.03625 sa=0 sb=0
+ sd=0 mult=1 m=1
XML2 N2 N1 VSS VSS sky130_fd_pr__nfet_g5v0d10v5 L=8u W=8u nf=1 ad=2.32 as=2.32 pd=16.58 ps=16.58 nrd=0.03625 nrs=0.03625 sa=0 sb=0
+ sd=0 mult=1 m=1
XMS2N PG N2 VSS VSS sky130_fd_pr__nfet_g5v0d10v5 L=8u W=8u nf=1 ad=2.32 as=2.32 pd=16.58 ps=16.58 nrd=0.03625 nrs=0.03625 sa=0 sb=0
+ sd=0 mult=1 m=1
XMS2P PG PB VDD VDD sky130_fd_pr__pfet_g5v0d10v5 L=4u W=10u nf=1 ad=2.9 as=2.9 pd=20.58 ps=20.58 nrd=0.029 nrs=0.029 sa=0 sb=0 sd=0
+ mult=1 m=1
XCC PG NZ sky130_fd_pr__cap_mim_m3_1 W=12u L=12u MF=1 m=1
XRZ NZ N2 VSS sky130_fd_pr__res_xhigh_po W=2u L=1000u mult=1 m=1
XMP1 M1D PG VDD VDD sky130_fd_pr__pfet_g5v0d10v5 L=4u W=8u nf=1 ad=2.32 as=2.32 pd=16.58 ps=16.58 nrd=0.03625 nrs=0.03625 sa=0 sb=0
+ sd=0 mult=1 m=1
XMPC1 NA PCAS M1D VDD sky130_fd_pr__pfet_g5v0d10v5 L=1u W=8u nf=1 ad=2.32 as=2.32 pd=16.58 ps=16.58 nrd=0.03625 nrs=0.03625 sa=0
+ sb=0 sd=0 mult=1 m=1
XMP2 M2D PG VDD VDD sky130_fd_pr__pfet_g5v0d10v5 L=4u W=8u nf=1 ad=2.32 as=2.32 pd=16.58 ps=16.58 nrd=0.03625 nrs=0.03625 sa=0 sb=0
+ sd=0 mult=1 m=1
XMPC2 NB PCAS M2D VDD sky130_fd_pr__pfet_g5v0d10v5 L=1u W=8u nf=1 ad=2.32 as=2.32 pd=16.58 ps=16.58 nrd=0.03625 nrs=0.03625 sa=0
+ sb=0 sd=0 mult=1 m=1
XMP3 M3D PG VDD VDD sky130_fd_pr__pfet_g5v0d10v5 L=4u W=8u nf=1 ad=2.32 as=2.32 pd=16.58 ps=16.58 nrd=0.03625 nrs=0.03625 sa=0 sb=0
+ sd=0 mult=1 m=1
XMPC3 PTAT PCAS M3D VDD sky130_fd_pr__pfet_g5v0d10v5 L=1u W=8u nf=1 ad=2.32 as=2.32 pd=16.58 ps=16.58 nrd=0.03625 nrs=0.03625 sa=0
+ sb=0 sd=0 mult=1 m=1
XMSU1 ND PB VDD VDD sky130_fd_pr__pfet_g5v0d10v5 L=8u W=1u nf=1 ad=0.29 as=0.29 pd=2.58 ps=2.58 nrd=0.29 nrs=0.29 sa=0 sb=0 sd=0
+ mult=1 m=1
XMSU2 ND NR VSS VSS sky130_fd_pr__nfet_g5v0d10v5 L=2u W=2u nf=1 ad=0.58 as=0.58 pd=4.58 ps=4.58 nrd=0.145 nrs=0.145 sa=0 sb=0 sd=0
+ mult=1 m=1
XMSU3 PG ND VSS VSS sky130_fd_pr__nfet_g5v0d10v5 L=1u W=4u nf=1 ad=1.16 as=1.16 pd=8.58 ps=8.58 nrd=0.0725 nrs=0.0725 sa=0 sb=0 sd=0
+ mult=1 m=1
XMDND ND ENB VSS VSS sky130_fd_pr__nfet_g5v0d10v5 L=0.5u W=2u nf=1 ad=0.58 as=0.58 pd=4.58 ps=4.58 nrd=0.145 nrs=0.145 sa=0 sb=0
+ sd=0 mult=1 m=1
XMENPG PG EN VDD VDD sky130_fd_pr__pfet_g5v0d10v5 L=0.5u W=4u nf=1 ad=1.16 as=1.16 pd=8.58 ps=8.58 nrd=0.0725 nrs=0.0725 sa=0 sb=0
+ sd=0 mult=1 m=1
XMENPT PTAT ENB VSS VSS sky130_fd_pr__nfet_g5v0d10v5 L=1u W=1u nf=1 ad=0.29 as=0.29 pd=2.58 ps=2.58 nrd=0.29 nrs=0.29 sa=0 sb=0 sd=0
+ mult=1 m=1
XMENCT CTAT ENB VSS VSS sky130_fd_pr__nfet_g5v0d10v5 L=1u W=1u nf=1 ad=0.29 as=0.29 pd=2.58 ps=2.58 nrd=0.29 nrs=0.29 sa=0 sb=0 sd=0
+ mult=1 m=1
XMSU4 NR PG VDD VDD sky130_fd_pr__pfet_g5v0d10v5 L=4u W=1u nf=1 ad=0.29 as=0.29 pd=2.58 ps=2.58 nrd=0.29 nrs=0.29 sa=0 sb=0 sd=0
+ mult=1 m=1
XMSU5 NR NR VSS VSS sky130_fd_pr__nfet_g5v0d10v5 L=2u W=2u nf=1 ad=0.58 as=0.58 pd=4.58 ps=4.58 nrd=0.145 nrs=0.145 sa=0 sb=0 sd=0
+ mult=1 m=1
XMDN2 N2 ENB VSS VSS sky130_fd_pr__nfet_g5v0d10v5 L=1u W=2u nf=1 ad=0.58 as=0.58 pd=4.58 ps=4.58 nrd=0.145 nrs=0.145 sa=0 sb=0 sd=0
+ mult=1 m=1
XMDNT NT ENB VSS VSS sky130_fd_pr__nfet_g5v0d10v5 L=1u W=2u nf=1 ad=0.58 as=0.58 pd=4.58 ps=4.58 nrd=0.145 nrs=0.145 sa=0 sb=0 sd=0
+ mult=1 m=1
XQ1 VSS VSS NA sky130_fd_pr__pnp_05v5_W3p40L3p40 m=1 mult=1
XQ8A VSS VSS NC sky130_fd_pr__pnp_05v5_W3p40L3p40 m=1 mult=1
XQ8B VSS VSS NC sky130_fd_pr__pnp_05v5_W3p40L3p40 m=1 mult=1
XQ8C VSS VSS NC sky130_fd_pr__pnp_05v5_W3p40L3p40 m=1 mult=1
XQ8D VSS VSS NC sky130_fd_pr__pnp_05v5_W3p40L3p40 m=1 mult=1
XQ8E VSS VSS NC sky130_fd_pr__pnp_05v5_W3p40L3p40 m=1 mult=1
XQ8F VSS VSS NC sky130_fd_pr__pnp_05v5_W3p40L3p40 m=1 mult=1
XQ8G VSS VSS NC sky130_fd_pr__pnp_05v5_W3p40L3p40 m=1 mult=1
XQ8H VSS VSS NC sky130_fd_pr__pnp_05v5_W3p40L3p40 m=1 mult=1
XR1 NB NC VSS sky130_fd_pr__res_xhigh_po W=2u L=119.47u mult=1 m=1
XR2 PTAT PTAT_TRIM VSS sky130_fd_pr__res_xhigh_po W=2u L=2652.6u mult=1 m=1
XR2TRIM PTAT_TRIM VSS VSS sky130_fd_pr__res_xhigh_po W=2u L=450.88u mult=1 m=1
XRISO NA CTAT VSS sky130_fd_pr__res_xhigh_po W=2u L=111.05u mult=1 m=1
.ends
