2AMLogic/sky130-temp-por/layout/bias_core_xq1_xqr/bias_core_xq1_xqr.spice

* extracted by klt extract --deck sky130

* cell bias_core_xq1_xqr
* pin er
* pin na
* pin vss
.SUBCKT bias_core_xq1_xqr er na vss
* device instance $1 r0 *1 1.7,1.7 pnp
Q$1 vss vss na pnp AE=11.56P PE=13.6U AB=12.96P PB=14.4U AC=12.96P PC=14.4U NE=1
* device instance $2 r0 *1 6.32,1.7 pnp
Q$2 vss vss er pnp AE=11.56P PE=13.6U AB=12.96P PB=14.4U AC=12.96P PC=14.4U NE=1
.ENDS bias_core_xq1_xqr
