2AMLogic/sky130-temp-por/layout/bias_core_startup/bias_core_startup.ref.spice

* Reference netlist for bias_core_startup LVS -- GENERATED by layout/bin/compose-cell.py
* Source: layout/bias_core_startup/reference.spice .subckt bias_core_startup
* Only unit spellings (and any substituted subckt parameter)
* differ from the source -- see compose-cell.py's docstring.
.subckt bias_core_startup VDD VSS KS1 KS2 KS3 KS4 NKG NKM PB PG
XKS0 VDD VDD KS1 VSS sky130_fd_pr__nfet_g5v0d10v5 L=8u W=1u nf=1 ad=0.29 as=0.29 pd=2.58 ps=2.58 nrd=0.29 nrs=0.29 sa=0 sb=0 sd=0
+ mult=1 m=1
XKS1 KS1 KS1 KS2 VSS sky130_fd_pr__nfet_g5v0d10v5 L=8u W=1u nf=1 ad=0.29 as=0.29 pd=2.58 ps=2.58 nrd=0.29 nrs=0.29 sa=0 sb=0 sd=0
+ mult=1 m=1
XKS2 KS2 KS2 KS3 VSS sky130_fd_pr__nfet_g5v0d10v5 L=8u W=1u nf=1 ad=0.29 as=0.29 pd=2.58 ps=2.58 nrd=0.29 nrs=0.29 sa=0 sb=0 sd=0
+ mult=1 m=1
XKS3 KS3 KS3 KS4 VSS sky130_fd_pr__nfet_g5v0d10v5 L=8u W=1u nf=1 ad=0.29 as=0.29 pd=2.58 ps=2.58 nrd=0.29 nrs=0.29 sa=0 sb=0 sd=0
+ mult=1 m=1
XKS4 KS4 KS4 NKG VSS sky130_fd_pr__nfet_g5v0d10v5 L=8u W=1u nf=1 ad=0.29 as=0.29 pd=2.58 ps=2.58 nrd=0.29 nrs=0.29 sa=0 sb=0 sd=0
+ mult=1 m=1
XKA NKM PB VDD VDD sky130_fd_pr__pfet_g5v0d10v5 L=4u W=1u nf=1 ad=0.29 as=0.29 pd=2.58 ps=2.58 nrd=0.29 nrs=0.29 sa=0 sb=0 sd=0
+ mult=1 m=1
XKAN NKM NKM VSS VSS sky130_fd_pr__nfet_g5v0d10v5 L=4u W=2u nf=1 ad=0.58 as=0.58 pd=4.58 ps=4.58 nrd=0.145 nrs=0.145 sa=0 sb=0 sd=0
+ mult=1 m=1
XKPD NKG NKM VSS VSS sky130_fd_pr__nfet_g5v0d10v5 L=4u W=8u nf=1 ad=2.32 as=2.32 pd=16.58 ps=16.58 nrd=0.03625 nrs=0.03625 sa=0 sb=0
+ sd=0 mult=1 m=1
XKICK PG NKG VSS VSS sky130_fd_pr__nfet_g5v0d10v5 L=4u W=1u nf=1 ad=0.29 as=0.29 pd=2.58 ps=2.58 nrd=0.29 nrs=0.29 sa=0 sb=0 sd=0
+ mult=1 m=1
.ends bias_core_startup
