2AMLogic/sky130-temp-por/layout/bias_core_xq1_xqr/bias_core_xq1_xqr.ref.spice

* Reference netlist for bias_core_xq1_xqr LVS -- GENERATED by layout/bin/compose-cell.py
* Source: layout/bias_core_xq1_xqr/reference.spice .subckt bias_core_xq1_xqr
* Only unit spellings (and any substituted subckt parameter)
* differ from the source -- see compose-cell.py's docstring.
.subckt bias_core_xq1_xqr NA ER VSS
XQ1 VSS VSS NA sky130_fd_pr__pnp_05v5_W3p40L3p40 m=1 mult=1
XQR VSS VSS ER sky130_fd_pr__pnp_05v5_W3p40L3p40 m=1 mult=1
.ends
