2AMLogic/sky130-temp-por/(commit log)

2026-08-20 Initial commit: temperature sensor + power-on-reset on SkyWater sky130
    Scaffolds the block: spec, schematics, ngspice sim, and klayout-tools-driven
    layout signoff.
    A port of the fleet's proven gf180-temp-por, so the PDK is the variable
    rather than the design: work starts from that repo's spec, schematics, and
    decision records, and anything that breaks is attributable to sky130's
    devices, deck, or tools before the circuit. sky130 is fully supported by
    klayout-tools, so unlike the SG13G2 sibling there is no tooling prerequisite.
    The one deliberate non-carry: POR trip points and brown-out behavior depend
    on device thresholds and their corners, which differ between gf180mcu and
    sky130 — VPOR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
2026-08-20 docs: add gf180-to-sky130 porting plan and first decision records (#2)
    Adds spec/porting-plan.md covering circuit carryover from gf180-temp-por
    (with DR citations), what must be re-derived against sky130 device models
    (POR trip points, hysteresis, brownout, temp-sensor characterization,
    supply flavor), and the PVT/ramp-rate/brownout testbench matrix design
    work must cover before it starts. Resolves the supply-flavor question via
    a new spec/decision-records/DR-001, and records the adopted starting
    architecture via DR-002. Updates spec/README.md to point at both.
2026-08-24 feat: port netlist export tooling and bias_core to sky130 (#11)
    Ports design/xschemrc, design/netlist.py, and the bias_core sub-circuit
    (schematic, symbol, generated netlist) from 2AMLogic/gf180-temp-por onto
    sky130, per spec/porting-plan.md Sec2.2 and DR-001/DR-002. Devices map
    pfet_03v3/nfet_03v3 -> pfet_g5v0d10v5/nfet_g5v0d10v5, pnp_10p00x10p00 ->
    pnp_05v5_W3p40L3p40, ppolyf_u_3k -> res_xhigh_po, and
    cap_mim_2f0_m3m4_noshield -> cap_mim_m3_1; every drawn W/L is carried over
    unchanged from gf180's ratified bias_core, so ratio-derived quantities
    (R2/R1, RT/R1, the 8:1 PNP ratio) are exact while absolute sizing stays
    first-order pending sky130 device characterization, per the issue's
    explici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
    [bias_core.sch]
2026-08-25 feat: port por_comparator schematic (POR threshold + hysteresis) to sky130 (#12)
    Ports gf180-temp-por's por_comparator (resistor-divided VDD tap compared
    against VREF, resistor-network positive-feedback hysteresis) onto sky130
    per spec/porting-plan.md Sec2.2 / DR-002, mapping pfet_03v3/nfet_03v3 to
    sky130_fd_pr__pfet_g5v0d10v5/nfet_g5v0d10v5 and ppolyf_u_3k to
    sky130_fd_pr__res_xhigh_po. Sizing carries gf180's drawn geometry
    mechanically (bare-micron convention); absolute VPOR/hysteresis values are
    not ported numerically and remain TBD pending sky130 characterization.
    Sub-issue 3/5 of #5 (T1 item 1); depends on #6 (bias_core + netlist
    tooling), already merged.
    Closes #8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
    [por_comparator.sch]
2026-08-25 feat: port temp_core schematic (PTAT/CTAT sensing) to sky130 (#13)
    Ports gf180-temp-por's design/temp_core.sch/.sym onto sky130 devices
    (sky130_fd_pr__pnp_05v5_W3p40L3p40, nfet/pfet_g5v0d10v5, res_xhigh_po,
    cap_mim_m3_1), following the same mechanical, first-order sizing
    convention bias_core (#6) established. Simplifies gf180's 6-bit
    metal-strap trim ladder to a single PTAT_TRIM node per issue #7's
    scope, deferring the physical strap-ladder to layout.
    python3 design/netlist.py --cell temp_core exports cleanly and
    --check passes for both committed cells. A DC operating-point smoke
    test (temp_core alongside bias_core, sharing IBIAS) solves across a
    tt/ff/ss x -40/27/125 C grid with no solver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
    [temp_core.sch]
2026-08-25 feat: port por_output_chain schematic to sky130 (deglitch/one-shot/RESETn drive + startup-assist) (#14)
    Ports gf180-temp-por's design/por_output_chain.sch onto sky130 (issue #9,
    sub-issue 4/5 of #5): deglitch filter, current-starved one-shot, nA-limited
    trip detector, and a release-NAND-based push-pull RESETn output stage whose
    below-floor leakage-divider default is the POR startup-assist pull-down
    (DR-002). Adds one device beyond gf180's own cell (MASSIST, an
    sky130_fd_pr__nfet_05v0_nvt near-zero-Vt pull-down gated from VDD/VSS) per
    this issue's own device-mapping table, since sky130's native-device
    availability is confirmed where gf180mcu's was not.
    Closes #9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
    [por_output_chain.sch]
2026-08-25 feat: assemble temp_por_top wiring bias_core/temp_core/por_comparator/por_output_chain (#15)
    Adds the block-level assembly cell: instantiates the four merged leaf
    cells (xbias/xtemp/xcmp/xpor) per the ratified 5-pad interface
    (VDD/VSS/PTAT/CTAT/RESETn) and the internal net-wiring contract
    (IBIAS/VREF/BIAS_OK/POR_RAW/RESETn) from the issue's net table, ported
    in shape from gf180-temp-por's own temp_por_top. temp_por_top adds no
    devices of its own; RESETn drives both the top-level pad and
    temp_core.EN so the sensor enables only after POR releases, and IBIAS
    is wired as a plain shared net (no switch/clamp/added load) to
    preserve the DR-010 liveness contract structurally.
    python3 design/netlist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
    [temp_por_top.sch]
2026-08-25 docs: add Chipalooza Challenge #4 (Sky130) proposal document (#18)
    Adds docs/chipalooza/challenge-4-proposal.md: block type, I/O mapped to
    the assumed slot budget (reconciling this block's ratified single-3.3V/
    5-pin interface against the harness's generic rail/slot assumptions),
    functional description, and a spec table re-derived only from what sim/
    actually contains today (empty) — every row honestly reads unmet, with
    informal design/*.md spot checks cited but never conflated with a "met"
    verdict — plus a bench test plan.
    Files real, corner-qualified pre-layout simulation (the brief's full
    sign-off bar) as out of scope for this issue's closure, per its own
    curation note; files #17 as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
2026-08-25 feat: port sim harness (PVT corner grid + mismatch Monte Carlo) from sky130-bandgap (#20)
    Ports sim/bin/{corner-run.py,sim_common.py,pdk-env.sh}, sim/pdk.json,
    sim/spiceinit and sim/xschemrc from sky130-bandgap's own sim/ harness,
    re-verified against this repo's own installed PDK (exact open_pdks commit
    match). Per the issue's curated finding, the ported default process-corner
    grid is the precedent's own flat 7-entry list (tt/ss/ff/sf/fs/ll/hh), not
    a 90-point MOS x resistor cross product -- that cross product does not
    exist in the harness being ported.
    Lands the first two experiments proving the ported harness runs against
    this repo's own design/netlist/*.spice sources, not just sky130-ban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
    [tb_bias_core_smoke.sch]
2026-08-26 bias_core: the spurious high-current DC point is a cold-.op solver artifact, not a second stable state (#19) (#21)
    * sim: add bias-core-startup experiment (transient-from-0V branch check)
    Testbench + manifest only; the record follows in the next commit.
    Part of #19
    * sim: add bias-core-op-branch — cold-.op branch-selection diagnostic
    Answers the first half of #19: are the two FAILing corners in
    sim/bias-core-smoke/records/20260825-214036-a9cac4b.md (tt_27c_2.97v,
    tt_27c_3.63v) a second stable state of bias_core, or an artifact of the
    cold .op solve?
    Bespoke runner (like sim/pnp-mismatch/run_pnp_mismatch.py, and for the
    same reason: corner-run.py drives one deterministic deck per PVT p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
    [tb_bias_core_startup.sch]
2026-08-26 temp_core: re-characterize startup/branch selection with a transient-from-0V testbench (#22) (#23)
    Retires design/temp_core.md's cold-.op spot check (same solver-continuation
    flaw issue #19 found for bias_core) in favor of a physical tran ... uic
    supply ramp from 0 V over the full 45-point PVT matrix, in two EN scenarios
    (asserted through the whole ramp, and released only after the supply is up
    per DR-002 ordering). Both records land 42/45 PASS; the physicality guards
    this issue asks for (supply-current sign, DeltaVBE-loop rail bounds) catch
    every FAIL with the same non-physical signature bias-core-op-branch used to
    prove bias_core's own artifact was a solver artifact, not a second stable
    st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
    [tb_temp_core_startup.sch, tb_temp_core_startup_en_delayed.sch]
2026-09-05 feat(champion): standing authorization for design-evidence auto-merge (#6850)
    Operator ruling 2026-09-05: Judge-approved, green-CI PRs whose entire
    changed-file set lives in design/, sim/, layout/, measurements/,
    verification/, or docs/ auto-merge without the four-axis human hold.
    Rationale: canary design evidence is fully revertible with no fleet-infra
    blast radius, and the held-PR pattern (sky130-sar-adc#123 sat mergeable for
    days as the sole blocker of a layout chain) costs more than it protects
    here. spec/ and every tool surface fall outside the patterns, so the
    exact-subset rule keeps them on the four-axis judgment automatically.
    C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
2026-09-09 sim: characterize sky130 native devices (nfet_05v0_nvt vs nfet_03v3_nvt) for MASSIST (#28)
    * feat: add native-device characterization testbench and PVT manifest
    Adds sim/native-device-characterization/, the first characterization of
    sky130's near-zero-Vt (native) NMOS device class in this repo: one
    testbench carrying three galvanically independent sub-networks (fixed
    'vsup' rail, swept rail, fixed 100 mV drain with swept gate) across three
    PDK bin geometries, so a single ngspice invocation per PVT point yields
    constant-current Vth, the MASSIST-condition always-on static current,
    off-state leakage, and the assist-onset voltage.
    The manifest tightens gmin/abstol away from ngspice's defaults,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
    [tb_native_device_char.sch]
2026-09-15 docs: add DR-003 recommending target-spec table values with sim evidence (#32)
    Reconciles spec/porting-plan.md §2.8's per-row disposition against the
    sim/ campaigns landed on main since the porting plan was written
    (bias-core-*, temp-core-startup*, native-device-characterization,
    pnp-mismatch), and recommends a value or an explicit [TBD-#n] deferral
    for every row of README.md's DRAFT target-spec table, citing the
    specific sim/ record behind each. Notably, sim/native-device-
    characterization measures MASSIST's always-on static current at
    9.44-31.94 µA across the PVT grid -- already conflicting with the
    README draft's <20 µA/<5 µA Iq figures at every corner -- so the Iq
    row is recommended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
2026-09-15 layout: port compose-cell recipe, lay out bias_core's 8:1 PNP leg (#33)
    Part of #30 (T1 item 2/10, part of #4).
    Ports layout/bin/compose-cell.py and _klt_common.py byte-for-byte from
    2AMLogic/sky130-trng's own layout/bin/ -- a design-agnostic driver for
    the klt gen -> gen-compose -> drc -> extract -> lvs chain, per this
    repo's compose-cell recipe convention (per-cell drc.json/extract.json/
    lvs.json evidence next to cell.json).
    Lays out design/netlist/bias_core.spice's XQ8A..XQ8H device group (the
    "8:1 PNP emitter-count ratio" leg) as a standalone proof cell using klt
    gen bjt_array's common-centroid matched-array generator, in
    layout/bias_core_pnp8_leg/. klt drc: clean, 0 violations. klt ex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
2026-09-15 layout: bias_core XQ1/XQR reference PNPs (collector-strap blocked in part) (#41)
    Part of #34 (device-group split of bias_core layout work), a follow-on
    from #30/#4.
    Lays out design/netlist/bias_core.spice's XQ1 and XQR devices -- the
    matching 1x reference unit for bias_core_pnp8_leg's 8:1 group, and the
    separate VREF-leg unit -- as a second standalone proof cell, in
    layout/bias_core_xq1_xqr/. Uses one shared-ring klt gen bjt_array call
    (rows=1 cols=2 ratio=1) rather than two independently-ringed blocks:
    bussing a net between two closed guard rings does not route cleanly
    even with ring_gap_side/ring_gap_um (filed generically upstream as
    2AMLogic/klayout-tools#1902), so both units are housed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
2026-09-15 layout: bias_core bias/ratio resistors + Miller caps sub-block (#43)
    Part of #34, decomposed as #37.
    Lays out design/netlist/bias_core.spice's XRT/XR1/XR2/XRZ/XCC/XCOK device
    group -- the bias/ratio resistor network (4x sky130_fd_pr__res_xhigh_po,
    each its own distinct length) and Miller compensation caps (2x
    sky130_fd_pr__cap_mim_m3_1) -- as a third standalone bias_core proof cell,
    in layout/bias_core_passives/. Each device is its own single-instance
    klt gen res_array/cap_array call (num=1); XR2's L=4104.0um dominates the
    sub-block's floorplan, so placement.strategy "row" lines up all 6 devices
    left to right rather than trying to compact them.
    klt drc: clean, 0 violations. klt extract: 6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
2026-09-16 layout: compose bias_core's settle-flag output stage, DRC- and LVS-clean (#46)
    Lays out design/netlist/bias_core.spice's XMPOK/XMOKA/XMOKB/XMOL1/XMOL2/
    XMOKC/XMOK2/XMOK2P/XMO1P/XMO1N device group -- the settle-flag
    comparator/driver chain that drives BIAS_OK -- as layout/bias_core_settle_flag/,
    following the compose-cell recipe layout/bias_core_pnp8_leg/ established.
    10 devices, each its own single-instance `klt gen mos_array` call (no two of
    them share a W/L), in a two-row CMOS floorplan: NMOS row, signal channel,
    PMOS row, with per-device guard_ring body-tie islands abutted at a 0.10um
    nwell overlap (li1 kept 0.20um clear) and two psub tap islands tying the
    substrate to vss. All eight rou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
2026-09-16 layout: bias_core startup kick chain, DRC- and LVS-clean (#48)
    Lays out design/netlist/bias_core.spice's XKS0..XKS4/XKA/XKAN/XKPD/XKICK
    device group (design/bias_core.md's startup kick chain: a 5-stage
    diode-connected NFET stack plus the kick node's own PFET/NFET pull-down
    network and the kick-pulse injector) as a standalone proof cell, following
    the compose-cell recipe layout/bias_core_pnp8_leg/ (#30/PR #33)
    established and bias_core_settle_flag's own per-net-layer_role technique
    (#39/PR #46).
    klt drc: clean, 0 violations. klt extract: 9 devices, 10 nets. klt lvs
    against design/netlist/bias_core.spice's own device cards: match -- 9/9
    devices, 10/10 nets, 10/10 pins, 0 mismatches. The secon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
2026-09-16 layout: compose bias_core's current-mirror + error-amp stack, DRC- and LVS-clean (#52)
    Lay out design/netlist/bias_core.spice's XMP1/XMP2/XMP3/XMPBN/XMBN/XMBN2/
    XMBP/XMPIB/XMPT/XMI1/XMI2/XML1/XML2/XMS2N/XMS2P device group -- the PFET
    current-mirror legs, the NFET/PFET bias mirror, the PB-gated bias-current
    outputs, and the PFET-input error amp with its NFET mirror load -- as a
    standalone DRC/LVS-clean proof cell, following the compose-cell recipe
    layout/bias_core_pnp8_leg/ established and the two-row CMOS floorplan
    layout/bias_core_settle_flag/ and layout/bias_core_startup/ proved.
    15 devices (10x pfet_g5v0d10v5 + 5x nfet_g5v0d10v5), 13 boundary nets.
    Nine routed nets are split across three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
2026-09-16 layout: unambiguous klt commit pin + pin-mismatch warning (#51) (#55)
    layout/pdk.json's klt_version_pin spells the pin by leading semver, which
    is not unique to a build: the same git commit can be packaged under more
    than one package_version (a local +g<hash> build), and the converse has
    also been observed in a churning toolchain. A host whose installed klt
    happens to share the semver prefix but not the commit -- or vice versa --
    looks pinned when it is not, and a genuinely stale klt then surfaces many
    steps into a klt gen-compose call as a confusing "unrecognized key(s)"
    error instead of reporting the mismatch up front.
    Add klt_commit_pin (the unambiguous git_commit half of the same build)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
2026-09-16 Docs: correct stale "empty"/"pre-spec" status claims (#58)
    * docs: correct stale "empty"/"pre-spec" status claims
    README.md and docs/chipalooza/challenge-4-proposal.md still described the
    repo as an empty shell (README:9/62 both dated to the initial commit), even
    though spec/ has three decision records + a two-key ratification process,
    design/ has a complete netlisted schematic hierarchy, sim/ has three
    testbench drivers with recorded PVT-corner results, and layout/ has an
    active multi-cell bias_core composition pass.
    - README.md: replace "just opened"/"pre-spec" with the actual current
    maturity-ladder position, and correct the repo-layout blurb for spec/.
    - docs/chipalooza/challenge-4-p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
2026-09-16 layout: promote missing external pins on bias_core sub-blocks (#62)
    bias_core_mirror_amp (na/pg/pb/vdd/vss/n2) and bias_core_settle_flag
    (vdd/vss/pb/nokx/bias_ok, plus a re-tapped nkg) now promote every net that
    crosses their own device-group boundary to a top-level pins[] pad, not just
    the subset each cell's own isolated LVS reference needed. bias_core_startup
    had the same gap (vdd/vss/nkg) and is fixed the same way. Each new pin is a
    small declare-only metal stub placed in a verified-clear tap point, added
    alongside the sub-block's existing routing without touching it -- DRC/
    extract/LVS status is unchanged for all three cells (diffed against the
    pre-change committed evidence, not assumed)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
2026-09-17 layout: promote ec/vss (pnp8_leg) and vss (xq1_xqr) external pins (#63)
    Both PNP cells bussed their cross-sub-block nets internally with no
    externally reachable pad, so #40's full-cell bias_core assembly could not
    reach them: bias_core_pnp8_leg had no pins[] at all (ec, vss), and
    bias_core_xq1_xqr promoted only na/er (vss missing).
    PR #62's west-edge metal-stub promotion does not transfer here. `klt
    gen-compose` refuses any leg from a non-tap port of a block whose
    guard/collector ring is a closed loop, and the rejection fires on the first
    leg leaving the block -- before any question of where the stub sits. Of the
    three remedies it names, "route to the ring's own tap port" does not apply
    (ec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
2026-09-17 feat: compose bias_core sub-blocks into a full-cell assembly (#65)
    Composes all six bias_core_* device-group sub-blocks (mirror_amp,
    settle_flag, startup, passives, pnp8_leg, xq1_xqr) into layout/bias_core/
    against design/netlist/bias_core.spice's own .subckt bias_core VDD VSS
    IBIAS VREF BIAS_OK, using compose-cell.py's opaque blocks[].cell sibling
    mechanism. DRC-clean (0 violations), 50/50 devices extracted matching the
    design netlist. VDD, VSS, and nkg are wired and verified short-free via
    klt extract; every other cross-block net is left unrouted this increment,
    each with a confirmed, documented root cause (a routing-plane shortage for
    the number of mutually-crossing nets, a handful of pre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
2026-09-21 feat: add klt erc supply spec and report for bias_core (T1 item 11) (#70)
    Commits the T1 item-11 (power delivery, structural) evidence for this
    repo: a klt erc supply spec (layer numbers resolved from the sky130A
    .lyp and cross-checked against klayout-tools' curated sky130 deck,
    gate role + active_layer poly-and-diff, supply nets VDD/VSS, tielessly
    scoped with recorded reasons) and its committed report pinned to the
    bias_core GDS hash, plus the manifest citation that grades item 11's
    row into the signoff tracker (rendered unmet, check_failed: the
    cited LVS half is the known #64 mismatch) and the README rows that
    carry the scoped disclosure.
    Closes #66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
2026-09-21 fix: land bias_core supply legs on the real pads (block-local ports) (#73)
    Rewrite the assembly's hand-declared ports[]/bbox_um to the six device
    blocks' own reported block-local coordinates (their compose.response.json,
    or gen/array.gen.json for the two PNP blocks), so klt gen-compose applies
    placement.origins_um exactly once and the route landings hit the placed
    blocks' real port geometry. The previous revision pre-translated those
    entries, so every landing pad sat 100um off each real pad and the supply
    rails touched none of the blocks' internal networks while reporting
    routed: true (#69; upstream coordinate-trust gap klayout-tools#2210).
    The VDD leg waypoints were re-derived for the real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
2026-09-23 fix: strap PNP collectors to VSS and reach LVS match on klt 0.6.0 (#77)
    * fix: strap PNP collectors to VSS and reach LVS match on klt 0.6.0
    Land issue #30's verified recipe on the committed evidence: add the
    arrays' COLL_E collector taps to vss in both PNP cells' cell.json (the
    klayout-tools #2312 / PR #2320 strap fix, contained in the new pin),
    wire cell.json lvs.options through compose-cell.py into lvs.request.json,
    scope the PNP class compare to NE only (six disclosed parameter
    exclusions per cell, sky130 fixed-geometry AE gap klayout-tools#2335),
    and bump layout/pdk.json's klt pin to 0.6.0 (c622e8addb36) with every
    layout/*/ evidence directory regenerated against it.
    bias_core_pnp8_leg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
2026-10-01 chore: resync installed Loom surfaces
    resynced_by: fleet-resync
    invocation: fleet-resync.sh --fleet-only --push
    <!-- loom:provenance v1 build=unknown 19f4e67fd0a0afbd3d8b6606ca91ceac911377a3 clean prompts=none sweep=none story=none trace=78a5dfbdfd8c530aecd1bb436fd096df host=loom-worker-2 base=45d7f457b9bc1cdcd6f14ab53e791d2ae937aa28 run=loom-run/v1:timer:loom-worker-2/fleet-resync:67c759f7ef3c43e38d3fa8d5f19a2dd1 installs=0.19.593 658650a4f0eff932ac66a8f690eaedf8123fc83b -->
    Loom-Story: none
    Loom-Trace-Id: 78a5dfbdfd8c530aecd1bb436fd096df
    Loom-Build: unknown 19f4e67fd0a0afbd3d8b6606ca91ceac911377a3 clean
2026-10-01 chore: resync installed Loom surfaces
    <!-- loom:provenance v1 build=unknown 56435bf476452911283e43940ecfd9a30f804af9 clean prompts=none sweep=none story=none trace=342405c5ebc99bdbf17afbd983c0c41c host=loom-worker-2 base=bfae0ebb3adb5baa3d7d8784c529702a5b45ad68 run=loom-run/v1:timer:loom-worker-2/fleet-resync:20c09f231d424cd5b57ca7991848dd8a installs=0.19.603 8c39bf7cde8a8c03d1aaee441f397c017b6a3a9e -->
    Loom-Trace-Id: 342405c5ebc99bdbf17afbd983c0c41c
    Loom-Build: unknown 56435bf476452911283e43940ecfd9a30f804af9 clean
    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
2026-10-01 chore: resync installed Loom surfaces
    <!-- loom:provenance v1 build=unknown f2868e6b4d60d11a8ab47d25cad9e248229d2f66 clean prompts=none sweep=none story=none trace=4e2766ed5160781df891476246a9be2e host=robb-studio base=a13aa09dc2142f32815bacf5530e2f3b279205ab run=loom-run/v1:timer:robb-studio/fleet-resync:2d3851d5-1673-43ae-bcc6-e5c971b37f33 installs=0.19.603 74778a6aeea5d9e06b489400942b35f33c8bb766 -->
    Loom-Trace-Id: 4e2766ed5160781df891476246a9be2e
    Loom-Build: unknown f2868e6b4d60d11a8ab47d25cad9e248229d2f66 clean
    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
2026-10-01 chore: resync installed Loom surfaces
    <!-- loom:provenance v1 build=unknown d6714830391f7596338b8de40ee2d0f45dcd12f5 clean prompts=none sweep=none story=none trace=af273f717e759e690d07f372734e9278 host=robb-pro base=013570090dffd34cee66add7017fdf7221240e86 run=loom-run/v1:timer:robb-pro/fleet-resync:92e2f9ba-d083-411b-833b-ae52d169ef04 installs=0.19.605 6eb2b65a4496b7becb84ef1f944493a541fd01cd -->
    Loom-Trace-Id: af273f717e759e690d07f372734e9278
    Loom-Build: unknown d6714830391f7596338b8de40ee2d0f45dcd12f5 clean
    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
2026-10-01 chore: resync installed Loom surfaces
    <!-- loom:provenance v1 build=unknown e956e9fee69e53f08b887ca20e14d9058d6f9aee clean prompts=none sweep=none story=none trace=1077dafeb758858c149dd37f4ece3c77 host=loom-worker-2 base=84841161c0c641eae57619f6792443c8c6a89403 run=loom-run/v1:timer:loom-worker-2/fleet-resync:e3773167b12d4b3aafa1f76848245174 installs=0.19.609 ff30576dacc8c2734b1c7434bedd29c47122caeb -->
    Loom-Trace-Id: 1077dafeb758858c149dd37f4ece3c77
    Loom-Build: unknown e956e9fee69e53f08b887ca20e14d9058d6f9aee clean
    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
2026-10-01 chore: resync installed Loom surfaces
    <!-- loom:provenance v1 build=unknown 617257919edc1b9b9ee27532c5ec1b8a64523388 clean prompts=none sweep=none story=none trace=dbafe4f8526617aa07c890721298a080 host=robb-studio base=74f2bdbb4a49a9fad726fe90be8c28eb65f28274 run=loom-run/v1:timer:robb-studio/fleet-resync:1817df66-02cc-4b27-927d-a38485da550a installs=0.19.610 c94891dd526cf6db5ee02045424c6913be522048 -->
    Loom-Trace-Id: dbafe4f8526617aa07c890721298a080
    Loom-Build: unknown 617257919edc1b9b9ee27532c5ec1b8a64523388 clean
    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
2026-10-01 chore: resync installed Loom surfaces
    <!-- loom:provenance v1 build=unknown a2a39ac2736eb2686e2c65412d939e67c0438a7d clean prompts=none sweep=none story=none trace=fc1a121767151aae5bd7427c683b7db6 host=robb-pro base=187c9656ee3b7524857c0f779fce717af4953f4f run=loom-run/v1:timer:robb-pro/fleet-resync:708eb7c8-469d-4783-80b7-bafe142df3c4 installs=0.19.612 d25614656adcf70162da95c5e1035e99a0639a1a -->
    Loom-Trace-Id: fc1a121767151aae5bd7427c683b7db6
    Loom-Build: unknown a2a39ac2736eb2686e2c65412d939e67c0438a7d clean
    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
2026-10-01 chore: resync installed Loom surfaces
    <!-- loom:provenance v1 build=unknown 126c80914e42f913c4fc778d3ddce96daa2c7a77 clean prompts=none sweep=none story=none trace=15a20fbea7a00d0922b943088c80e19d host=loom-worker-1 base=525a70bf3bad98c2954c2e2bab6b8921b7467732 run=loom-run/v1:script:loom-worker-1/fleet-resync:ecc423da-4625-49de-b25a-692fd669a029 installs=0.19.612 53aeb18c5541af6b068247d82f62daed412cc2c6 -->
    Loom-Trace-Id: 15a20fbea7a00d0922b943088c80e19d
    Loom-Build: unknown 126c80914e42f913c4fc778d3ddce96daa2c7a77 clean
    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
2026-10-01 chore: resync installed Loom surfaces
    <!-- loom:provenance v1 build=unknown 126c80914e42f913c4fc778d3ddce96daa2c7a77 clean prompts=none sweep=none story=none trace=a0a42bd10fcfa6d7cbcc9c021c406848 host=loom-worker-2 base=404131bff262639857f108849369e57a29f89bce run=loom-run/v1:timer:loom-worker-2/fleet-resync:9e174e6bb0fa41d786e4a86e45632b6f installs=0.19.612 6f0871dc66e62b36d8382ced980d2805bfd97e50 -->
    Loom-Trace-Id: a0a42bd10fcfa6d7cbcc9c021c406848
    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
2026-10-01 chore: resync installed Loom surfaces
    <!-- loom:provenance v1 build=unknown 8891f74a5d568fe3d13937ef37fd64371dd2738f clean prompts=none sweep=none story=none trace=1e216ea76cbd2b72542049c4c18c2817 host=loom-worker-1 base=d2e28c681ce2481af668d9364aaae360b33f7099 run=loom-run/v1:timer:loom-worker-1/fleet-resync:679feba6c0f347d39eb5943ed77dc87b installs=0.19.612 62fa67f8756bdf59fdf744be053e5ef1709f1335 -->
    Loom-Trace-Id: 1e216ea76cbd2b72542049c4c18c2817
    Loom-Build: unknown 8891f74a5d568fe3d13937ef37fd64371dd2738f clean
    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
2026-10-01 chore: resync installed Loom surfaces
    <!-- loom:provenance v1 build=unknown 6f3411c8a63e68097dde01bce8a8422230f54218 clean prompts=none sweep=none story=none trace=9aa0a46bb352b9665fdaa5f5b3b85dd7 host=robb-pro base=7c1965f7e9e71b0380264c44d89ce9db90ef18b8 run=loom-run/v1:timer:robb-pro/fleet-resync:ca419e1d-6646-4678-ac7a-b263e4b5119e installs=0.19.612 7731400b3e3e1df39074564166edf656feb0999c -->
    Loom-Trace-Id: 9aa0a46bb352b9665fdaa5f5b3b85dd7
    Loom-Build: unknown 6f3411c8a63e68097dde01bce8a8422230f54218 clean
    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
2026-10-02 chore: resync installed Loom surfaces
    <!-- loom:provenance v1 build=unknown 13c0a3ef467a888520a6529ab34486ab8be826be clean prompts=none sweep=none story=none trace=41356080f367e491d5ff03f17bb98c27 host=loom-worker-2 base=258ed109c65acdd092935cbeec5277c0915a0beb run=loom-run/v1:timer:loom-worker-2/fleet-resync:44455fbcbab745abb92cea192fafbb1d installs=0.19.614 3c79f7b1d0cc14723e049cff4250ff7330804326 -->
    Loom-Trace-Id: 41356080f367e491d5ff03f17bb98c27
    Loom-Build: unknown 13c0a3ef467a888520a6529ab34486ab8be826be clean
    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
2026-10-02 chore: resync installed Loom surfaces
    <!-- loom:provenance v1 build=unknown 6f3411c8a63e68097dde01bce8a8422230f54218 clean prompts=none sweep=none story=none trace=acb28d0049e0cc75536f96d503f6e814 host=robb-studio base=caeb80070df923cb911a65a95158aafda7a08105 run=loom-run/v1:timer:robb-studio/fleet-resync:85d2b1b5-e81d-40c3-ab6a-9a00efbc4ee2 installs=0.19.616 d86523eeadb32b95777f3cd3a76dd2f72f0bf792 -->
    Loom-Trace-Id: acb28d0049e0cc75536f96d503f6e814
    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
2026-10-02 chore: resync installed Loom surfaces
    <!-- loom:provenance v1 build=unknown 2b50bd69eddd038dd738465aa58a9ebca11410ac clean prompts=none sweep=none story=none trace=324e4f607054d0396cfdf8fdc01e93ae host=robb-pro base=b19f36c3b785eec2d1d6158337a86b9fcaaae66d run=loom-run/v1:timer:robb-pro/fleet-resync:a63799f1-2ad7-4946-b81d-2ec231bc2d2f installs=0.19.617 81cb2ad7e091b19d6a2b95d1add6938c2100d46b -->
    Loom-Trace-Id: 324e4f607054d0396cfdf8fdc01e93ae
    Loom-Build: unknown 2b50bd69eddd038dd738465aa58a9ebca11410ac clean
    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
2026-10-02 chore: resync installed Loom surfaces
    <!-- loom:provenance v1 build=unknown 00d92b326aed50280cd90dc116b7caec27668251 clean prompts=none sweep=none story=none trace=9a5d23cc82b6d3a1c83bfee47bd04970 host=loom-worker-2 base=4db9bbf37e567f24acdd94d99e18998502ab50b7 run=loom-run/v1:timer:loom-worker-2/fleet-resync:12136a7a025d49f3a60b5edb04a3ff81 installs=0.19.619 4c0f505e4f0b76f8ccec07bda6d8b839030c077b -->
    Loom-Trace-Id: 9a5d23cc82b6d3a1c83bfee47bd04970
    Loom-Build: unknown 00d92b326aed50280cd90dc116b7caec27668251 clean
    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
2026-10-02 chore: resync installed Loom surfaces
    <!-- loom:provenance v1 build=unknown 456dad6d90259846313dc3bb80bf4e5471ef2d76 clean prompts=none sweep=none story=none trace=bb9688c03fb5211d06f48c8838a5505c host=robb-studio base=324d317fd4f5572374e13608f1e6529b9e73db6f run=loom-run/v1:timer:robb-studio/fleet-resync:e965c017-8ec7-485d-b46e-aeb399b81fb4 installs=0.19.620 0d28ba49f5a88fdb37271de9cb0144eb3442c6e3 -->
    Loom-Trace-Id: bb9688c03fb5211d06f48c8838a5505c
    Loom-Build: unknown 456dad6d90259846313dc3bb80bf4e5471ef2d76 clean
    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
2026-10-02 chore: resync installed Loom surfaces
    <!-- loom:provenance v1 build=unknown 6c6d2b6565dc13eff4c6811b9c670f452106516b clean prompts=none sweep=none story=none trace=539be979ae694d66ede516a7b5d17e41 host=robb-pro base=59d0d1685faa64151ead4f672900ac42ab63b47f run=loom-run/v1:timer:robb-pro/fleet-resync:9444d216-de08-442f-8352-ba59f6e81bb3 installs=0.19.621 a90dc1d794eb9ff70aaf939ebf495abe716f3bdd -->
    Loom-Trace-Id: 539be979ae694d66ede516a7b5d17e41
    Loom-Build: unknown 6c6d2b6565dc13eff4c6811b9c670f452106516b clean
    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
2026-10-02 chore: resync installed Loom surfaces
    <!-- loom:provenance v1 build=unknown f6d28134bfe476967e005d97424073085f55e8a3 clean prompts=none sweep=none story=none trace=27eb90670d441065f593e941066ee005 host=loom-worker-2 base=fa93a35a112385a047cf20aa0bb979575d3937cc run=loom-run/v1:timer:loom-worker-2/fleet-resync:04001bba930241cf9e325bf304a9270a installs=0.19.623 ccc19c2bbe2aa65328427730fa53f70eb56128c6 -->
    Loom-Trace-Id: 27eb90670d441065f593e941066ee005
    Loom-Build: unknown f6d28134bfe476967e005d97424073085f55e8a3 clean
    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
2026-10-02 chore: resync installed Loom surfaces
    <!-- loom:provenance v1 build=unknown bc461736314499b6c2c4c0ad51fb2294f60336f5 clean prompts=none sweep=none story=none trace=c3ea68717dd3a908dbbd60a35bc8b5d6 host=robb-studio base=a00f531ffbad116af4a2705144b2a3fbf63a727e run=loom-run/v1:timer:robb-studio/fleet-resync:8d4c49e2-3258-4080-b0c8-082499053654 installs=0.19.623 a50aaf70069f8897c41a64b7d90783c5ab8294e0 -->
    Loom-Trace-Id: c3ea68717dd3a908dbbd60a35bc8b5d6
    Loom-Build: unknown bc461736314499b6c2c4c0ad51fb2294f60336f5 clean
    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
2026-10-02 chore: resync installed Loom surfaces
    <!-- loom:provenance v1 build=unknown bc461736314499b6c2c4c0ad51fb2294f60336f5 clean prompts=none sweep=none story=none trace=8bee8a664bfc89e0bbfbb3c2de7342ba host=loom-worker-2 base=1c120b30665ef2cf7fc65136aa71852b73500e2d run=loom-run/v1:timer:loom-worker-2/fleet-resync:de2ceceb48ea4927a1334d08dc0082fe installs=0.19.624 5f49564fa78ae06f8c48d5224dae9ded04200bb7 -->
    Loom-Trace-Id: 8bee8a664bfc89e0bbfbb3c2de7342ba
    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
2026-10-03 chore: resync installed Loom surfaces
    <!-- loom:provenance v1 build=unknown 752d316233ed1a3da9e4f69ad760eb99bb477747 clean prompts=none sweep=none story=none trace=7851839b67c00a023e97cbdea1f580e1 host=robb-pro base=b26f4e8b420e190f34893c2f4008acbad6f40e43 run=loom-run/v1:timer:robb-pro/fleet-resync:ae492b66-dca0-4da4-acab-8d26778f2d5c installs=0.19.624 121fac45f5006879bf58a18c951b9243d9099a18 -->
    Loom-Trace-Id: 7851839b67c00a023e97cbdea1f580e1
    Loom-Build: unknown 752d316233ed1a3da9e4f69ad760eb99bb477747 clean
    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
2026-10-03 chore: resync installed Loom surfaces
    <!-- loom:provenance v1 build=unknown b34a08286a42f47f917ec46647d4d167c1f5207c clean prompts=none sweep=none story=none trace=a8e453124b899b440f42c9d83837c7b6 host=loom-worker-2 base=05a00061b948877cd07e43e43813b14e1dfaa53b run=loom-run/v1:timer:loom-worker-2/fleet-resync:f02dd5df715347fe90fe14b9353a1b66 installs=0.19.624 0162badc662fb30c070e70611aa8ff74a8486d54 -->
    Loom-Trace-Id: a8e453124b899b440f42c9d83837c7b6
    Loom-Build: unknown b34a08286a42f47f917ec46647d4d167c1f5207c clean
    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
2026-10-03 chore: resync installed Loom surfaces
    <!-- loom:provenance v1 build=unknown 3437cece5ab759f772122f8d18a6d2f05d246cde clean prompts=none sweep=none story=none trace=bba21427f750636f851279cfae92b4e5 host=loom-worker-1 base=cb24261ee75ed3c9c3b06607dd471742b2e59561 run=loom-run/v1:timer:loom-worker-1/fleet-resync:9440cda9476f404caa282e360a81ee03 installs=0.19.636 e41edfbb52c13982f7d8b0577f42957427a6514c -->
    Loom-Trace-Id: bba21427f750636f851279cfae92b4e5
    Loom-Build: unknown 3437cece5ab759f772122f8d18a6d2f05d246cde clean
    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
2026-10-03 chore: resync installed Loom surfaces
    <!-- loom:provenance v1 build=unknown 28040ed11a4369e20f3b7b0154a3fb2a2c35d38c clean prompts=none sweep=none story=none trace=0cd87d01c45d97a2ee57a99363fc0db2 host=robb-studio base=154f85b2751d7c280a3a7ff3a98941e33b56ccab run=loom-run/v1:timer:robb-studio/fleet-resync:74b93657-6b04-4ac5-bc77-e0a1682b0595 installs=0.19.636 e41edfbb52c13982f7d8b0577f42957427a6514c -->
    Loom-Trace-Id: 0cd87d01c45d97a2ee57a99363fc0db2
    Loom-Build: unknown 28040ed11a4369e20f3b7b0154a3fb2a2c35d38c clean
    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
2026-10-03 chore: resync installed Loom surfaces
    <!-- loom:provenance v1 build=unknown 388c7fe0cad997f7a887f70c9f2cfe8781a2d512 clean prompts=none sweep=none story=none trace=2046ffd42f138a06b914f34851de3440 host=loom-worker-2 base=c023a9047be410e4275f5c53440893eefb7f0cbf run=loom-run/v1:timer:loom-worker-2/fleet-resync:17c9456bb1934c70a545b12081496cce installs=0.19.647 d1fe5dead4202be12a964ab891fd5980e7836170 -->
    Loom-Trace-Id: 2046ffd42f138a06b914f34851de3440
    Loom-Build: unknown 388c7fe0cad997f7a887f70c9f2cfe8781a2d512 clean
    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
2026-10-03 chore: resync installed Loom surfaces
    <!-- loom:provenance v1 build=unknown 8078c29e691123d91cd761a786f99cfd25f1809d clean prompts=none sweep=none story=none trace=45869a6374635c036a11a6f379fe31a4 host=robb-pro base=6ed79ff7a69657983ee081b4c439b101e029d706 run=loom-run/v1:timer:robb-pro/fleet-resync:b0a94991-052d-4e7d-ba2b-78b971096849 installs=0.19.647 709ca4396e074e5a4d1c5e19721f6ddac7154ca2 -->
    Loom-Trace-Id: 45869a6374635c036a11a6f379fe31a4
    Loom-Build: unknown 8078c29e691123d91cd761a786f99cfd25f1809d clean
    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
2026-10-03 spec: ratify DR-003 (operating temperature + supply rows only) (#78)
    Loom-Story: 2AMLogic/sky130-temp-por#78
    Loom-Trace-Id: c64259ff6877ec1d27af407462a1ba82
    Loom-Build: 0.19.647 039bf0d546da7afdfb3b3b4db810e236c2ff4c7c clean
2026-10-03 chore: resync installed Loom surfaces
    <!-- loom:provenance v1 build=unknown f9cba29b0602624a23daa17ae04d31d82e10fa91 clean prompts=none sweep=none story=none trace=754b3688f97b6c34894d8cfbf272b81a host=loom-worker-1 base=3cb67a337776ad49f3d3ccf6ace70a9bacc0a774 run=loom-run/v1:script:loom-worker-1/fleet-resync:11eb117a-9ff3-4411-88d4-fdd7d6748639 installs=0.19.649 6f2f13b1c31ce420e2250ae040d8e1050c0e761b -->
    Loom-Trace-Id: 754b3688f97b6c34894d8cfbf272b81a
    Loom-Build: unknown f9cba29b0602624a23daa17ae04d31d82e10fa91 clean
    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
2026-10-03 chore: resync installed Loom surfaces
    <!-- loom:provenance v1 build=unknown f9cba29b0602624a23daa17ae04d31d82e10fa91 clean prompts=none sweep=none story=none trace=544a028e3829d4020b8aaa144e5fa628 host=robb-studio base=3c393c2aa7a25d3275e7d3c9fed6e5766925a1b3 run=loom-run/v1:script:robb-studio/fleet-resync:5b5b8b83-7139-447d-88bd-417dcf375aa6 installs=0.19.649 6f2f13b1c31ce420e2250ae040d8e1050c0e761b -->
    Loom-Trace-Id: 544a028e3829d4020b8aaa144e5fa628
    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
2026-10-03 chore: resync installed Loom surfaces
    <!-- loom:provenance v1 build=unknown f9cba29b0602624a23daa17ae04d31d82e10fa91 clean prompts=none sweep=none story=none trace=1057aaaf811f6dd2d64a3bb6d4b3ac49 host=robb-pro base=868085ef2a950b53e2ef620b93215a04e398998e run=loom-run/v1:timer:robb-pro/fleet-resync:785c1ea0-d7f2-4810-99e9-cd9368aebe0c installs=0.19.649 2118aabb5a925f1ec4669b4d3d31176a46d8f2a6 -->
    Loom-Trace-Id: 1057aaaf811f6dd2d64a3bb6d4b3ac49
    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
2026-10-03 chore: resync installed Loom surfaces
    <!-- loom:provenance v1 build=unknown 72f61d9aa0fe08f1ef59f1a97a314e474455801e clean prompts=none sweep=none story=none trace=90666a75095c62a013be2ea121ab93f1 host=loom-worker-2 base=2a23c7e9827378465e034bd47874ba50db317d9e run=loom-run/v1:script:loom-worker-2/fleet-resync:13865fad-1cac-4838-857f-34878fcba5d1 installs=0.19.652 235a64727b907d65529151af0a962b14f16462a0 -->
    Loom-Trace-Id: 90666a75095c62a013be2ea121ab93f1
    Loom-Build: unknown 72f61d9aa0fe08f1ef59f1a97a314e474455801e clean
    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
2026-10-03 chore: resync installed Loom surfaces
    <!-- loom:provenance v1 build=unknown 72f61d9aa0fe08f1ef59f1a97a314e474455801e clean prompts=none sweep=none story=none trace=845aaa0eb340f80f12095e2e8b421ed1 host=robb-pro base=6e309d0623a4365262f45f346e0b0fe1bd8065fe run=loom-run/v1:script:robb-pro/fleet-resync:344add4b-df8a-49e8-8563-2765673acc76 installs=0.19.652 235a64727b907d65529151af0a962b14f16462a0 -->
    Loom-Trace-Id: 845aaa0eb340f80f12095e2e8b421ed1
    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
2026-10-03 chore: resync installed Loom surfaces
    <!-- loom:provenance v1 build=unknown 21130104346fe9c464ce8a3fdf82c1d3e9667639 clean prompts=none sweep=none story=none trace=36308fff5a3c323c3d1bf6fffb6cd122 host=robb-studio base=749761f322ac51fe7e982da93c488668a0de1cca run=loom-run/v1:timer:robb-studio/fleet-resync:89972fbd-0774-4402-bbb7-26c33a851735 installs=0.19.652 fb69233bd8f1dfc2bdee37d8b934f99274dc0193 -->
    Loom-Trace-Id: 36308fff5a3c323c3d1bf6fffb6cd122
    Loom-Build: unknown 21130104346fe9c464ce8a3fdf82c1d3e9667639 clean
    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
2026-10-04 chore: resync installed Loom surfaces
    <!-- loom:provenance v1 build=unknown 61870b40779d205c1555e801c6e1d95df083cdea clean prompts=none sweep=none story=none trace=fb9213e215442932d2af05f3b14977de host=robb-pro base=6687123d828f22f3cda590d908d1f5098be938d7 run=loom-run/v1:timer:robb-pro/fleet-resync:4c70cd1d-08cd-4add-8e2a-9a75160d163f installs=0.19.655 36c39e3c6f56e1979647ec235b4bd19c77db22f3 -->
    Loom-Trace-Id: fb9213e215442932d2af05f3b14977de
    Loom-Build: unknown 61870b40779d205c1555e801c6e1d95df083cdea clean
    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
2026-10-04 chore: resync installed Loom surfaces
    <!-- loom:provenance v1 build=unknown 61870b40779d205c1555e801c6e1d95df083cdea clean prompts=none sweep=none story=none trace=baa6c2cfcae1a320917c00ff2eb8b630 host=loom-worker-2 base=0be7d1970fef7be8d78eef2449f935c46901b37f run=loom-run/v1:timer:loom-worker-2/fleet-resync:741a7f0f16df4fb1be4e657aeacd1244 installs=0.19.655 fc667a4faae1227f8a6837431f8a0c2d0aeaa7dd -->
    Loom-Trace-Id: baa6c2cfcae1a320917c00ff2eb8b630
    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
2026-10-04 chore: resync installed Loom surfaces
    <!-- loom:provenance v1 build=unknown b922acb2ac655cbccd71daa9e3f05a325a094ca5 clean prompts=none sweep=none story=none trace=833eeb34d4ca65c3f8c6f7824ddca3a3 host=robb-studio base=942a837ca0877eac700829f5504bef29731cd384 run=loom-run/v1:timer:robb-studio/fleet-resync:0d44f6dc-6a62-4d43-b49d-7cfdd7dbd823 installs=0.19.663 0a51e373e7fe1be156c5774b2c827d4b745368a3 -->
    Loom-Trace-Id: 833eeb34d4ca65c3f8c6f7824ddca3a3
    Loom-Build: unknown b922acb2ac655cbccd71daa9e3f05a325a094ca5 clean
    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
2026-10-04 chore: resync installed Loom surfaces
    <!-- loom:provenance v1 build=unknown 746ecb5f9d7e64ba1d2526f1e997530ad4f3dd43 clean prompts=none sweep=none story=none trace=f09501431241df2ec5688e334ba43dfe host=loom-worker-2 base=5e0de2280346069c47d31dc9798048f723a6d2c2 run=loom-run/v1:timer:loom-worker-2/fleet-resync:70797dad61fb4e21806716d54f1ce910 installs=0.19.669 59a1f84e3742827a8033bb153ebbedc1759bee72 -->
    Loom-Trace-Id: f09501431241df2ec5688e334ba43dfe
    Loom-Build: unknown 746ecb5f9d7e64ba1d2526f1e997530ad4f3dd43 clean
    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
2026-10-04 chore: resync installed Loom surfaces
    <!-- loom:provenance v1 build=unknown 8080d0485cc1312129ee642b084944c56d1be074 clean prompts=none sweep=none story=none trace=ed180bcab6828041123ad54d8ddb4037 host=robb-pro base=5a856b21bf60ac4ee9226e13538bac4ac4c3bbd3 run=loom-run/v1:timer:robb-pro/fleet-resync:e97b2f08-4ad9-4b66-a166-5b19820e2d1f installs=0.19.669 59a1f84e3742827a8033bb153ebbedc1759bee72 -->
    Loom-Trace-Id: ed180bcab6828041123ad54d8ddb4037
    Loom-Build: unknown 8080d0485cc1312129ee642b084944c56d1be074 clean
    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
2026-10-04 chore: resync installed Loom surfaces
    <!-- loom:provenance v1 build=unknown 83cb6647167ffc000d2c2f479b4e816b68f863f4 clean prompts=none sweep=none story=none trace=ccabffa1e1ba495895b262086030816c host=robb-studio base=c0e60e6662d8789c0f4cb3fee23173ebd78e67e6 run=loom-run/v1:timer:robb-studio/fleet-resync:88a78f1f-d978-47b5-99c3-2aabde811d17 installs=0.19.676 cd4f30bd892ea2595d8218b08150633504b0dd14 -->
    Loom-Trace-Id: ccabffa1e1ba495895b262086030816c
    Loom-Build: unknown 83cb6647167ffc000d2c2f479b4e816b68f863f4 clean
    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
2026-10-04 chore: resync installed Loom surfaces
    <!-- loom:provenance v1 build=unknown 32174d0f7e80508fa66c1a11a2c0fb28c515607e clean prompts=none sweep=none story=none trace=436d7c19b10cd5807625a7ce7190a82f host=loom-worker-2 base=1795c61c294ac6dfb10ed6a5f99c754f58d669dc run=loom-run/v1:timer:loom-worker-2/fleet-resync:19ae50771cc04d8db7b1403c1e66bbea installs=0.19.682 9eccfa110fa294fa32a62ffe8eff669cfcf1a3a6 -->
    Loom-Trace-Id: 436d7c19b10cd5807625a7ce7190a82f
    Loom-Build: unknown 32174d0f7e80508fa66c1a11a2c0fb28c515607e clean
    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
2026-10-04 chore: resync installed Loom surfaces
    <!-- loom:provenance v1 build=unknown 72290fa960e0773b2c50d74042e24914c7327637 clean prompts=none sweep=none story=none trace=f7b6952a649a174398a48b90b6ab4793 host=robb-pro base=f1b5f7a3f41e558664bd10145fb28689f709f477 run=loom-run/v1:timer:robb-pro/fleet-resync:72f32482-5cc4-4b38-ab9e-4d2ef0b64e94 installs=0.19.684 bdb8fb331eb51c7def4cdd2c38b611af06f25f6d -->
    Loom-Trace-Id: f7b6952a649a174398a48b90b6ab4793
    Loom-Build: unknown 72290fa960e0773b2c50d74042e24914c7327637 clean
    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
2026-10-04 chore: resync installed Loom surfaces
    <!-- loom:provenance v1 build=unknown 76cda58637be0e74c4cb5b4c8dbc2000e2a9c3d4 clean prompts=none sweep=none story=none trace=614cbada5ce873c2b34a511816309cfc host=robb-studio base=798b8b7fbc218c51a697cc3b2c673ec36ac96ce3 run=loom-run/v1:timer:robb-studio/fleet-resync:7e559a3b-ffdd-409b-8dd2-ae906a273b0a installs=0.19.692 d4974b9f5ff7843a3cfc06378ea2a69bc120e0f4 -->
    Loom-Trace-Id: 614cbada5ce873c2b34a511816309cfc
    Loom-Build: unknown 76cda58637be0e74c4cb5b4c8dbc2000e2a9c3d4 clean
    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
2026-10-04 chore: resync installed Loom surfaces
    <!-- loom:provenance v1 build=unknown f84bac5c232c093f83c1adc2533d8c75b021cda2 clean prompts=none sweep=none story=none trace=e687830614e4bd1c551ab6cf6186f8f3 host=loom-worker-2 base=84e70222c222613e2f633af7634f4c806b8704d7 run=loom-run/v1:timer:loom-worker-2/fleet-resync:2db2c4373ac24de1b7a364e69eaea1ca installs=0.19.695 b0d5b09f207fda439390ea1dd249ad10e7009dfc -->
    Loom-Trace-Id: e687830614e4bd1c551ab6cf6186f8f3
    Loom-Build: unknown f84bac5c232c093f83c1adc2533d8c75b021cda2 clean
    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
2026-10-04 chore: resync installed Loom surfaces
    <!-- loom:provenance v1 build=unknown ac5c275d1c616a9723e747f5a66de93dc80d3512 clean prompts=none sweep=none story=none trace=c777c3912bd31972e9aa3ccab712ae01 host=loom-worker-1 base=48c276fe2949716d30ad86609fa029b5c083acc4 run=loom-run/v1:script:loom-worker-1/fleet-resync:b51a1b33-4958-4408-be36-166e12e8360b installs=0.19.697 ada83a5c7ff66b56b0060ef0be368c9fe56eb3c6 -->
    Loom-Trace-Id: c777c3912bd31972e9aa3ccab712ae01
    Loom-Build: unknown ac5c275d1c616a9723e747f5a66de93dc80d3512 clean
    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
2026-10-04 chore: resync installed Loom surfaces
    <!-- loom:provenance v1 build=unknown a19f642f5c09599c4c64827d81d228eb031be73e clean prompts=none sweep=none story=none trace=34a80e22764eb5055e37faec0eaf65fb host=robb-pro base=e16575136b2d5a262924af3fdc315173a72c25b9 run=loom-run/v1:script:robb-pro/fleet-resync:689be620-3ff2-4ff5-a2ce-f6825f6379e2 installs=0.19.698 aa619a1d07e36e8d90ac01fea63dc39285c93567 -->
    Loom-Trace-Id: 34a80e22764eb5055e37faec0eaf65fb
    Loom-Build: unknown a19f642f5c09599c4c64827d81d228eb031be73e clean
    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
2026-10-04 chore: resync installed Loom surfaces
    <!-- loom:provenance v1 build=unknown 693bdd794cb34afdefd7f0c4596824cd53078a61 clean prompts=none sweep=none story=none trace=7e7be58c80b40f1ac882b00139fb0ca0 host=robb-pro base=be9d8135c9c87ee61dfcbc4e6e3a9b5c6df7055e run=loom-run/v1:timer:robb-pro/fleet-resync:d64fbd6b-5d9b-491d-9e17-742b375bfba7 installs=0.19.698 b814428b8333c69174c977498d1d2db6bce3145c -->
    Loom-Trace-Id: 7e7be58c80b40f1ac882b00139fb0ca0
    Loom-Build: unknown 693bdd794cb34afdefd7f0c4596824cd53078a61 clean
    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
2026-10-04 chore: resync installed Loom surfaces
    <!-- loom:provenance v1 build=unknown 693bdd794cb34afdefd7f0c4596824cd53078a61 clean prompts=none sweep=none story=none trace=aa18f1ec102a98d77ffc51c9be6ffbb3 host=robb-studio base=66c78658286aa9462b49e5c9b27ee951389eda83 run=loom-run/v1:script:robb-studio/fleet-resync:3cb89ca8-62c2-4a69-8434-c4aaa3b64eaf installs=0.19.698 a58f00e0681c50d6bfc5089d0af4b3715198319f -->
    Loom-Trace-Id: aa18f1ec102a98d77ffc51c9be6ffbb3
    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
2026-10-04 chore: resync installed Loom surfaces
    <!-- loom:provenance v1 build=unknown 7a41c2e69ef89d60ed3bd190b94838021bf18d0f clean prompts=none sweep=none story=none trace=d0f04f38b507d85402723643fcf47197 host=loom-worker-1 base=30cbbee0810033ed9b51f6ef61e02dfcc1abf814 run=loom-run/v1:script:loom-worker-1/fleet-resync:8fdc8c1c-f844-4c33-bc80-b424e5b4cf3d installs=0.19.703 89d5a428c652f957d7fad8a546589042d39911bc -->
    Loom-Trace-Id: d0f04f38b507d85402723643fcf47197
    Loom-Build: unknown 7a41c2e69ef89d60ed3bd190b94838021bf18d0f clean
    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
2026-10-05 chore: resync installed Loom surfaces
    <!-- loom:provenance v1 build=unknown ebb37db560de172930e261675a35bd52e429f650 clean prompts=none sweep=none story=none trace=a40e86a64366c7a1e36aea026901334f host=loom-worker-2 base=2adbcf4494cd18d78d2b05fcbece8e3bc7cb9283 run=loom-run/v1:script:loom-worker-2/fleet-resync:90b6cd74-6cc0-4f58-98ee-6ede0ac6f50c installs=0.19.703 f63c3c82e6bf202f2ca7b205b532f681c5ebb2c8 -->
    Loom-Trace-Id: a40e86a64366c7a1e36aea026901334f
    Loom-Build: unknown ebb37db560de172930e261675a35bd52e429f650 clean
    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
2026-10-05 chore: resync installed Loom surfaces
    <!-- loom:provenance v1 build=unknown 7a41c2e69ef89d60ed3bd190b94838021bf18d0f clean prompts=none sweep=none story=none trace=fc04851db12f586b5d58155325131b6e host=robb-studio base=17fce91ef031ac50b2b083de50ed70528a0510a3 run=loom-run/v1:timer:robb-studio/fleet-resync:a7d5da6f-a896-4d6f-8d00-aebf47f9b266 installs=0.19.703 2ad9a08fb93de4d7dfac9d2b501d12c684c9c2cc -->
    Loom-Trace-Id: fc04851db12f586b5d58155325131b6e
    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
2026-10-05 chore: resync installed Loom surfaces
    <!-- loom:provenance v1 build=unknown afe7e99e397c242cc319fa80702fb3b23e23f5a7 clean prompts=none sweep=none story=none trace=e46782e1dd9c94461b4cf934ce05296b host=loom-worker-2 base=383d67db4638b803e647b93d8edbd4fe0590778c run=loom-run/v1:timer:loom-worker-2/fleet-resync:caa89259b1fd414ebd2f07500621166d installs=0.19.703 972fe7321be6a9efe2653579379ea3bc40b899b2 -->
    Loom-Trace-Id: e46782e1dd9c94461b4cf934ce05296b
    Loom-Build: unknown afe7e99e397c242cc319fa80702fb3b23e23f5a7 clean
    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
2026-10-05 chore: resync installed Loom surfaces
    <!-- loom:provenance v1 build=unknown b44cb904ebb599db793066ccc631c846862abfbd clean prompts=none sweep=none story=none trace=9590fed7c1b1c9f549ccf3cba24292d7 host=robb-pro base=455986597a8c3a594dff18faa773cd2b37234ba2 run=loom-run/v1:timer:robb-pro/fleet-resync:dbc6174e-403d-422d-98b6-73a4b6dbf44f installs=0.19.708 dc8faf1eae3143feda6301887c303b1ee45db7f4 -->
    Loom-Trace-Id: 9590fed7c1b1c9f549ccf3cba24292d7
    Loom-Build: unknown b44cb904ebb599db793066ccc631c846862abfbd clean
    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
2026-10-05 chore: resync installed Loom surfaces
    <!-- loom:provenance v1 build=unknown 4548905848fcb7cb875c1c0518f2fd88eb65818e clean prompts=none sweep=none story=none trace=aff5e139797705f6fa0811f102ecd103 host=loom-worker-1 base=bfd64f768a5627d088dd3924e2609d0f74866493 run=loom-run/v1:timer:loom-worker-1/fleet-resync:ba6a9e5686a64abaa842d71acaeae2ca installs=0.19.718 00d99344506bcf00e1aec7e910abe3d13df2d240 -->
    Loom-Trace-Id: aff5e139797705f6fa0811f102ecd103
    Loom-Build: unknown 4548905848fcb7cb875c1c0518f2fd88eb65818e clean
    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
2026-10-05 chore: resync installed Loom surfaces
    <!-- loom:provenance v1 build=unknown e7efbaa6e7b97a7d72da6032044c67525291f4d1 clean prompts=none sweep=none story=none trace=d74a33a6f35e329b3e795991e790ebfd host=robb-studio base=d204bfa77e42822915d9710bd484ebc2115fb595 run=loom-run/v1:timer:robb-studio/fleet-resync:304f49c8-5b3e-46a9-a557-945b9ae177f0 installs=0.19.718 00d99344506bcf00e1aec7e910abe3d13df2d240 -->
    Loom-Trace-Id: d74a33a6f35e329b3e795991e790ebfd
    Loom-Build: unknown e7efbaa6e7b97a7d72da6032044c67525291f4d1 clean
    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
2026-10-05 chore: resync installed Loom surfaces
    <!-- loom:provenance v1 build=unknown 347b71e65e709d9fd49aba75d3fb67877fc08818 clean prompts=none sweep=none story=none trace=f9653dd318724c98136e7cef63e551ed host=robb-pro base=d0dc15a93eff6894813517e9b09ebb99dd0c639f run=loom-run/v1:timer:robb-pro/fleet-resync:cdc95970-9fb1-49fa-a0e6-037a3fab2099 installs=0.19.728 991dcebf6f6b2de6571f1d3400bec083498c6438 -->
    Loom-Trace-Id: f9653dd318724c98136e7cef63e551ed
    Loom-Build: unknown 347b71e65e709d9fd49aba75d3fb67877fc08818 clean
    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
2026-10-05 chore: resync installed Loom surfaces
    <!-- loom:provenance v1 build=unknown 5c0d18101f48fecb656f10fa37afa9b09bf41631 clean prompts=none sweep=none story=none trace=ddcf49552af364cbf6e884bd59584c1f host=loom-worker-1 base=43df18d29c694982b823eeb3a3d4b66af2c189a6 run=loom-run/v1:timer:loom-worker-1/fleet-resync:5eb526a05f244f1985770579e7620ff1 installs=0.19.731 7484b71fce5179a025950e71a82855afaf6fd730 -->
    Loom-Trace-Id: ddcf49552af364cbf6e884bd59584c1f
    Loom-Build: unknown 5c0d18101f48fecb656f10fa37afa9b09bf41631 clean
    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
2026-10-05 chore: resync installed Loom surfaces
    <!-- loom:provenance v1 build=unknown 0b160514b6658e3ab26a71c6525791da25b46fcf clean prompts=none sweep=none story=none trace=311c3eb2c0ab9550d3de38df5523f3d7 host=robb-studio base=ae244db2d1896e929012286be483ca772e49b939 run=loom-run/v1:timer:robb-studio/fleet-resync:e6dec631-b42b-4cf2-b854-cc363cfde6e0 installs=0.19.731 d6146becf339a3d4e55e26e8807ac4571213a00b -->
    Loom-Trace-Id: 311c3eb2c0ab9550d3de38df5523f3d7
    Loom-Build: unknown 0b160514b6658e3ab26a71c6525791da25b46fcf clean
    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
2026-10-05 chore: resync installed Loom surfaces
    <!-- loom:provenance v1 build=unknown 5c0d18101f48fecb656f10fa37afa9b09bf41631 clean prompts=none sweep=none story=none trace=f1e8d4c6e73b8eec3e87a8da52e10f2d host=robb-pro base=a5da0ab57a11b9aae36db5b58aa695167574ea2c run=loom-run/v1:timer:robb-pro/fleet-resync:5518fd33-81cb-479f-93f0-287ea4b08876 installs=0.19.733 4e67131ce3a1317d8cb8904ec342541cc2f45665 -->
    Loom-Trace-Id: f1e8d4c6e73b8eec3e87a8da52e10f2d
    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
2026-10-05 chore: resync installed Loom surfaces
    <!-- loom:provenance v1 build=unknown ca170d11544ef499cc9500a45bbad152edacfbd1 clean prompts=none sweep=none story=none trace=6dcfc713b6a851b40932158c2eeb70af host=loom-worker-3 base=2f0600254875aeae37c99676c2972d71c308d98f run=loom-run/v1:timer:loom-worker-3/fleet-resync:20ce0908ea5a468a9e055470104047ed installs=0.19.734 7ba6ea50c36dfdd2b5e2922dd22c65560980a5a2 -->
    Loom-Trace-Id: 6dcfc713b6a851b40932158c2eeb70af
    Loom-Build: unknown ca170d11544ef499cc9500a45bbad152edacfbd1 clean
    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
2026-10-05 chore: resync installed Loom surfaces
    <!-- loom:provenance v1 build=unknown 03f1c42302d15f8a83425a84a4e36ca484f3f625 clean prompts=none sweep=none story=none trace=f1bc879f8aa652d550764ffcd36e27d1 host=loom-worker-1 base=b7416b7161c7a6f6f8f368057d6b125aa49103bf run=loom-run/v1:timer:loom-worker-1/fleet-resync:f302a3cc8558413492093df510b02418 installs=0.19.734 967abe71d019ce6606018b4e57dee0223b84d96f -->
    Loom-Trace-Id: f1bc879f8aa652d550764ffcd36e27d1
    Loom-Build: unknown 03f1c42302d15f8a83425a84a4e36ca484f3f625 clean
    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
2026-10-05 chore: resync installed Loom surfaces
    <!-- loom:provenance v1 build=unknown ce7557ba58624d48fedbca2bc037dfa8ce3943e7 clean prompts=none sweep=none story=none trace=e1f2558834c47835cd9a53ec8c9a2ffa host=loom-worker-3 base=ebf86dfd1586dc1fe1564e2ca27be20f9a4dfa28 run=loom-run/v1:timer:loom-worker-3/fleet-resync:50f5f0046e2c4890961b3221bd360247 installs=0.19.734 ba9edb650872e5265eaca0c47f75e3cb828ecad2 -->
    Loom-Trace-Id: e1f2558834c47835cd9a53ec8c9a2ffa
    Loom-Build: unknown ce7557ba58624d48fedbca2bc037dfa8ce3943e7 clean
    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
2026-10-05 chore: resync installed Loom surfaces
    <!-- loom:provenance v1 build=unknown f92eaec38470a7b0732e065f4864faec9a1905d6 clean prompts=none sweep=none story=none trace=07aa020a8179d52651250562e9808b98 host=robb-studio base=c594e4ab07f031fdedeadb5b7c9589fd0dfa6b55 run=loom-run/v1:timer:robb-studio/fleet-resync:3b3ebdf2-b5f7-48ed-b7bb-5fb945094061 installs=0.19.734 78f3e99c44d0af6d4598adf7577bb6676baf3e8f -->
    Loom-Trace-Id: 07aa020a8179d52651250562e9808b98
    Loom-Build: unknown f92eaec38470a7b0732e065f4864faec9a1905d6 clean
    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
2026-10-06 chore: resync installed Loom surfaces
    <!-- loom:provenance v1 build=unknown ca170d11544ef499cc9500a45bbad152edacfbd1 clean prompts=none sweep=none story=none trace=fca9c14d74d6d634726f5823c51bc62a host=loom-worker-2 base=04c435a80dfa66b60b6cb1d4d74f6976f4dd07b2 run=loom-run/v1:timer:loom-worker-2/fleet-resync:23a23f0878c1494cb720941baddfea81 installs=0.19.741 3cede3920c6b567d5400789187a904970d46b0fb -->
    Loom-Trace-Id: fca9c14d74d6d634726f5823c51bc62a
    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
2026-10-06 chore: resync installed Loom surfaces
    <!-- loom:provenance v1 build=unknown e38a22941348fd8e83d1f4b06130d2a214adfb50 clean prompts=none sweep=none story=none trace=a7fe3a9a1fedfce89846c20f2e98ac31 host=robb-pro base=1bc458229c484b29daaaff731c62faff742c2741 run=loom-run/v1:timer:robb-pro/fleet-resync:2d770a42-f0e7-4695-abfa-b912e75382e6 installs=0.19.744 8bc5bcce93c4d9721817387afe8b4b6d79f26054 -->
    Loom-Trace-Id: a7fe3a9a1fedfce89846c20f2e98ac31
    Loom-Build: unknown e38a22941348fd8e83d1f4b06130d2a214adfb50 clean
    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
2026-10-06 chore: resync installed Loom surfaces
    <!-- loom:provenance v1 build=unknown f66ea90ff1bdec51aa4c8dc3f4b2e8d26e3dfd2d clean prompts=none sweep=none story=none trace=66d96c3bb00b04fae967865ee02fc4de host=loom-worker-3 base=20ffa5173c3df2c10a9f8810ec91fb6e4431e483 run=loom-run/v1:timer:loom-worker-3/fleet-resync:eb2dceb410e848a19d58f96f678c995e installs=0.19.749 6135634b053dc30ef5aa8e6d733bfe79bb2ac734 -->
    Loom-Trace-Id: 66d96c3bb00b04fae967865ee02fc4de
    Loom-Build: unknown f66ea90ff1bdec51aa4c8dc3f4b2e8d26e3dfd2d clean
    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
2026-10-06 chore: resync installed Loom surfaces
    <!-- loom:provenance v1 build=unknown ade8a2c60cc8370d04d72f331141acb6fb32e121 clean prompts=none sweep=none story=none trace=6245fb88b5bdf9f7ccecb6b2168dc335 host=robb-studio base=07b3551ccc32125818e1c31b3bc85e1efbef0bdb run=loom-run/v1:timer:robb-studio/fleet-resync:b305aed2-1a25-4576-aca7-9b017ac4377e installs=0.19.755 8d97d322e1cb3723988504337089beca73d0511c -->
    Loom-Trace-Id: 6245fb88b5bdf9f7ccecb6b2168dc335
    Loom-Build: unknown ade8a2c60cc8370d04d72f331141acb6fb32e121 clean
    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
2026-10-06 chore: resync installed Loom surfaces
    <!-- loom:provenance v1 build=unknown 2489bb7d5203844b3fbe8efbe007f44aa074685d clean prompts=none sweep=none story=none trace=0b5c9263a55c09e6fbd870b2d9ff5d9b host=loom-worker-2 base=b4ca5c752e88ddb35ca9d588183d7973d573f13f run=loom-run/v1:timer:loom-worker-2/fleet-resync:d3f5a5beb1144f72ac8be575767b3e03 installs=0.19.760 3a509582b179d91c2d5b5a65a7ba4650c3c08985 -->
    Loom-Trace-Id: 0b5c9263a55c09e6fbd870b2d9ff5d9b
    Loom-Build: unknown 2489bb7d5203844b3fbe8efbe007f44aa074685d clean
    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
2026-10-06 chore: resync installed Loom surfaces
    <!-- loom:provenance v1 build=unknown 986d16b700174622774ff68af4ef323e8d0e23ba clean prompts=none sweep=none story=none trace=cb518f1f5785c258556383940a46c461 host=loom-worker-1 base=abe6b612aa92126dcb09f07b03d95bb54023cc49 run=loom-run/v1:timer:loom-worker-1/fleet-resync:97df92c5eca846de85e979810663a94b installs=0.19.765 c6cec65c4f320f11153c72e840e49a5d6a6f1afc -->
    Loom-Trace-Id: cb518f1f5785c258556383940a46c461
    Loom-Build: unknown 986d16b700174622774ff68af4ef323e8d0e23ba clean
    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
2026-10-06 chore: resync installed Loom surfaces
    <!-- loom:provenance v1 build=unknown 85e52221261264d7f7643251de706f00c8db289f clean prompts=none sweep=none story=none trace=a2434124d73d8cca0ca77230fc85adf5 host=robb-pro base=b4021a3d5271c418b85f740153f1573cde7bad4f run=loom-run/v1:timer:robb-pro/fleet-resync:abffb067-59ed-4a6e-94b6-8cf3500c935c installs=0.19.768 c9f7ca975144d991bce40f492403b8292e8b7fae -->
    Loom-Trace-Id: a2434124d73d8cca0ca77230fc85adf5
    Loom-Build: unknown 85e52221261264d7f7643251de706f00c8db289f clean
    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
2026-10-06 chore: resync installed Loom surfaces
    <!-- loom:provenance v1 build=unknown 31b34ebfd7d4539094523eaa7b56a104bebe5fc0 clean prompts=none sweep=none story=none trace=16fac36f144dc183c71465eb36c89afc host=loom-worker-3 base=243ed74655d421d9c82d500f7cf0b1ebe44155f0 run=loom-run/v1:timer:loom-worker-3/fleet-resync:c763e24590314b918c8ee8df5d2de1db installs=0.19.769 af995a5725fdadf708127f006aa8f248b482d7d7 -->
    Loom-Trace-Id: 16fac36f144dc183c71465eb36c89afc
    Loom-Build: unknown 31b34ebfd7d4539094523eaa7b56a104bebe5fc0 clean
    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
2026-10-06 chore: resync installed Loom surfaces
    <!-- loom:provenance v1 build=unknown 7bed309263b3785eae46a9cbc53b3b24a52b10d2 clean prompts=none sweep=none story=none trace=843adbd5eac450c43d3a2c43da1bf729 host=robb-studio base=19240026e9d072e3508ddaec2adf8be02c8f7b1d run=loom-run/v1:timer:robb-studio/fleet-resync:f83d5ba4-81f7-479a-9768-6af33d4cc825 installs=0.19.783 a9b459e0c2b1916ceb116db33053e7eb0df57e7b -->
    Loom-Trace-Id: 843adbd5eac450c43d3a2c43da1bf729
    Loom-Build: unknown 7bed309263b3785eae46a9cbc53b3b24a52b10d2 clean
    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
2026-10-06 chore: resync installed Loom surfaces
    <!-- loom:provenance v1 build=unknown 07bc40ba9ab0f7dfe7cd0990377b7ac07a52d220 clean prompts=none sweep=none story=none trace=563f186108419cf03cef002a62c3b201 host=loom-worker-2 base=9695fce4f7ad054f2c4a4630cf0dcb4330e8e03a run=loom-run/v1:timer:loom-worker-2/fleet-resync:944beccd157a4197b81feafdd19f443e installs=0.19.785 2f0a9dbb4f06053f747b8a5615a3519f8e30b527 -->
    Loom-Trace-Id: 563f186108419cf03cef002a62c3b201
    Loom-Build: unknown 07bc40ba9ab0f7dfe7cd0990377b7ac07a52d220 clean
    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
2026-10-06 chore: resync installed Loom surfaces
    <!-- loom:provenance v1 build=unknown 31b34ebfd7d4539094523eaa7b56a104bebe5fc0 clean prompts=none sweep=none story=none trace=ea6600df41a4b420b6d8e967f839ccfd host=loom-worker-3 base=44c4b0d8836a16916df361ed37be4c7f3c4059ab run=loom-run/v1:timer:loom-worker-3/fleet-resync:c80415b48fd5404bbd599c4f6cc8a448 installs=0.19.793 7ceff96944c39d33e3c2f1141ca650c2c4c05679 -->
    Loom-Trace-Id: ea6600df41a4b420b6d8e967f839ccfd
    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
2026-10-06 chore: resync installed Loom surfaces
    <!-- loom:provenance v1 build=unknown 596a53e525683919daae1b43e6babe9bf847a02f clean prompts=none sweep=none story=none trace=b9c0cb42a5a72ecc21726229c957ef1f host=loom-worker-2 base=a257126f47f6399f769a9ca7e42bc6fcfe5103df run=loom-run/v1:timer:loom-worker-2/fleet-resync:21d578f5cc0b4b7ba5f10759f5f30ae8 installs=0.19.801 524bdb33cb26c8355454d7550413c89e72c06fae -->
    Loom-Trace-Id: b9c0cb42a5a72ecc21726229c957ef1f
    Loom-Build: unknown 596a53e525683919daae1b43e6babe9bf847a02f clean
    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
2026-10-06 chore: resync installed Loom surfaces
    <!-- loom:provenance v1 build=unknown 40b591a33adb895d4f46977105f9b264d8a2599b clean prompts=none sweep=none story=none trace=e41c725fe0c176312eb412bc69fe5b01 host=robb-studio base=16ab8f2eb59692ec4cc33c6660f58a5f7ea0e1cd run=loom-run/v1:timer:robb-studio/fleet-resync:37d704dd-4dfd-4341-adb4-6551637ad147 installs=0.19.802 72ce1f7385747dd773d1644408ec22072b8a5d20 -->
    Loom-Trace-Id: e41c725fe0c176312eb412bc69fe5b01
    Loom-Build: unknown 40b591a33adb895d4f46977105f9b264d8a2599b clean
    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
2026-10-06 chore: resync installed Loom surfaces
    <!-- loom:provenance v1 build=unknown 31b34ebfd7d4539094523eaa7b56a104bebe5fc0 clean prompts=none sweep=none story=none trace=5ad0480c4b21b80f9c852c448319e7a1 host=loom-worker-3 base=d3869747be5792e40fafe75b75786d65a543ab4a run=loom-run/v1:timer:loom-worker-3/fleet-resync:48e836f11f9547ddb96de5aa0d072a05 installs=0.19.810 933f828e779602e492e4e157812988a4b8128111 -->
    Loom-Trace-Id: 5ad0480c4b21b80f9c852c448319e7a1
    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
2026-10-07 chore: resync installed Loom surfaces
    <!-- loom:provenance v1 build=unknown f71cf25de9e75bae6060da4a599df8fbabe75890 clean prompts=none sweep=none story=none trace=64943e35511da4833bbd385cf288be8a host=loom-worker-2 base=dcb40268c81d129abe8836cc029b6385869dd296 run=loom-run/v1:timer:loom-worker-2/fleet-resync:d69eb1b87d4849ae810a145b1b667d2f installs=0.19.822 1c6969ea8726c800a353c236d9f23456a5706f1a -->
    Loom-Trace-Id: 64943e35511da4833bbd385cf288be8a
    Loom-Build: unknown f71cf25de9e75bae6060da4a599df8fbabe75890 clean
    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
2026-10-07 chore: resync installed Loom surfaces
    <!-- loom:provenance v1 build=unknown 31b34ebfd7d4539094523eaa7b56a104bebe5fc0 clean prompts=none sweep=none story=none trace=cb192cb8f72cf6f2711f73f7ee12bebc host=loom-worker-3 base=499c6fc522764f3b94db7de6ef05a61f45b856cc run=loom-run/v1:timer:loom-worker-3/fleet-resync:c1e385c3607e43ad8bed9c7d29811c66 installs=0.19.830 a966f7b89b714704fa1225b96e2dbee50480a4c6 -->
    Loom-Trace-Id: cb192cb8f72cf6f2711f73f7ee12bebc
    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
2026-10-07 chore: resync installed Loom surfaces
    <!-- loom:provenance v1 build=unknown 8abdd34fddc879aff407380278baa713eca6b758 clean prompts=none sweep=none story=none trace=ea945665dad5ccb3880de51c4448e8b9 host=robb-pro base=25f7bf43eb0e6772c75bedd5593f321fe9674e17 run=loom-run/v1:timer:robb-pro/fleet-resync:1466e397-b80c-46ea-a42c-26a7fbd4e00e installs=0.19.831 61814c9c1912925cdff7418842ff3ea17cd56fe4 -->
    Loom-Trace-Id: ea945665dad5ccb3880de51c4448e8b9
    Loom-Build: unknown 8abdd34fddc879aff407380278baa713eca6b758 clean
    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
2026-10-07 chore: resync installed Loom surfaces
    <!-- loom:provenance v1 build=unknown 628be5bb140bcff803d159201bd61e1b868901b0 clean prompts=none sweep=none story=none trace=093df1dc315c5e78dcccfca9d699d5f5 host=loom-worker-2 base=1c2e4aa654b898be4597a1fb15c5105df202001e run=loom-run/v1:timer:loom-worker-2/fleet-resync:0b0ea5e184c0429a9c431fcca6c791ad installs=0.19.832 1a0fc15974bf0575a9155fb8276f7529fc813542 -->
    Loom-Trace-Id: 093df1dc315c5e78dcccfca9d699d5f5
    Loom-Build: unknown 628be5bb140bcff803d159201bd61e1b868901b0 clean
    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
2026-10-07 chore: resync installed Loom surfaces
    <!-- loom:provenance v1 build=unknown 069e3b45d86c08f0d60c8fc2b0096de441e99bdc clean prompts=none sweep=none story=none trace=b1ba9d6b2b581e47827d9c099f717b04 host=loom-worker-1 base=469c3d90f4b0efb430e8e51ff2ba387a196ffcc5 run=loom-run/v1:timer:loom-worker-1/fleet-resync:aada8278bd4843bcaecce69fdf91251e installs=0.19.838 e70aa17f8dead31bda49cf044c3fc28119df6e90 -->
    Loom-Trace-Id: b1ba9d6b2b581e47827d9c099f717b04
    Loom-Build: unknown 069e3b45d86c08f0d60c8fc2b0096de441e99bdc clean
    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
2026-10-07 chore: resync installed Loom surfaces
    <!-- loom:provenance v1 build=unknown 31b34ebfd7d4539094523eaa7b56a104bebe5fc0 clean prompts=none sweep=none story=none trace=ef030e94bce76f728497f5927960865f host=loom-worker-3 base=a5e6a2eedba7d3615f67486ec1a2c0ca634c7b10 run=loom-run/v1:timer:loom-worker-3/fleet-resync:28ba4284bfa446c888b501714eda0509 installs=0.19.840 59b533a2a1ed5e186fbf8446b5acbe42d7231854 -->
    Loom-Trace-Id: ef030e94bce76f728497f5927960865f
    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
2026-10-07 chore: resync installed Loom surfaces
    <!-- loom:provenance v1 build=unknown bc59c70c3412a87b31a0dbe65cd6abf968744328 clean prompts=none sweep=none story=none trace=766033e4e881801f24971d664c490ea3 host=robb-studio base=3282c5ef99fd84c20a03809a6a28d0241458c6a9 run=loom-run/v1:timer:robb-studio/fleet-resync:6b3b079a-890e-4a79-9c3a-0b4bb33ff7c4 installs=0.19.840 59b533a2a1ed5e186fbf8446b5acbe42d7231854 -->
    Loom-Trace-Id: 766033e4e881801f24971d664c490ea3
    Loom-Build: unknown bc59c70c3412a87b31a0dbe65cd6abf968744328 clean
    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
2026-10-07 chore: resync installed Loom surfaces
    <!-- loom:provenance v1 build=unknown a068938e7a6c13759bcb3943e408273a3d352257 clean prompts=none sweep=none story=none trace=76bec863c8f6aff2d49b3aa2be128619 host=robb-pro base=7655783dd7a6dd09f6c855f5bbcf11a0965cf2b2 run=loom-run/v1:timer:robb-pro/fleet-resync:d9927fc6-ee80-4b6a-ba2b-f13576bd5f9b installs=0.19.846 837b14d7440b89ae8a2cec6d045483ac33659af5 -->
    Loom-Trace-Id: 76bec863c8f6aff2d49b3aa2be128619
    Loom-Build: unknown a068938e7a6c13759bcb3943e408273a3d352257 clean
    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
2026-10-07 chore: resync installed Loom surfaces
    <!-- loom:provenance v1 build=unknown 628be5bb140bcff803d159201bd61e1b868901b0 clean prompts=none sweep=none story=none trace=5a6f676b4652a1a750bbce1386c68d06 host=loom-worker-2 base=93fa27974049cd38db0f551c7171082827940934 run=loom-run/v1:timer:loom-worker-2/fleet-resync:bd416e653be04ef4b13353430625e379 installs=0.19.850 3bb4bfc90603b6ad65cabca9b3eb42a59f1a9d3a -->
    Loom-Trace-Id: 5a6f676b4652a1a750bbce1386c68d06
    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
2026-10-07 chore: resync installed Loom surfaces
    <!-- loom:provenance v1 build=unknown 40215645df8a13508180b248b44244dc488bb078 clean prompts=none sweep=none story=none trace=29fde30615e6e47f39b41aa314c2c883 host=loom-worker-1 base=1b5278f5c9a92282134509fdc78d9a6df948c430 run=loom-run/v1:timer:loom-worker-1/fleet-resync:d1fbedfcc7824ae59233c0ea94dc4650 installs=0.19.853 2889d5ed585b4da0935543cb916381cc03b19746 -->
    Loom-Trace-Id: 29fde30615e6e47f39b41aa314c2c883
    Loom-Build: unknown 40215645df8a13508180b248b44244dc488bb078 clean
    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
2026-10-07 chore: resync installed Loom surfaces
    <!-- loom:provenance v1 build=unknown 31b34ebfd7d4539094523eaa7b56a104bebe5fc0 clean prompts=none sweep=none story=none trace=cdf49c615da3f5ce46e9fcda1a24f787 host=loom-worker-3 base=7b201d798904d3c2f2ab2b32d0444dfb15014dba run=loom-run/v1:timer:loom-worker-3/fleet-resync:cab31e05b8a24df09bc88f53ee3fb501 installs=0.19.857 7a0b529e6f57a79713f6924bf58d8392ff404259 -->
    Loom-Trace-Id: cdf49c615da3f5ce46e9fcda1a24f787
    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
2026-10-07 chore: resync installed Loom surfaces
    <!-- loom:provenance v1 build=unknown 4b44e7c5db0de1d2b5927de7de229120d546aad3 clean prompts=none sweep=none story=none trace=dfa656ee3483a044378501f49d36f812 host=robb-studio base=f8589b1a10e39b46569c13e525d3ce18b93fee3e run=loom-run/v1:timer:robb-studio/fleet-resync:d80d6bc0-eb68-4a07-8226-2d947d328b3a installs=0.19.859 0aefebd79aba8ab33470f1af4b96847fc794bd0d -->
    Loom-Trace-Id: dfa656ee3483a044378501f49d36f812
    Loom-Build: unknown 4b44e7c5db0de1d2b5927de7de229120d546aad3 clean
    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
2026-10-07 chore: resync installed Loom surfaces
    <!-- loom:provenance v1 build=unknown b591c8cf436f0d4aa5870a9bc7cd5f7194e0e778 dirty prompts=none sweep=none story=none trace=6eca4b0c47205457aae7a3d721c17f17 host=robb-pro base=4dca25992479e610f6210681a4a877802c0b8cfc run=loom-run/v1:timer:robb-pro/fleet-resync:64af20b3-58cb-47f2-b770-117197cb41e9 installs=0.19.864 128a7eba2bb5f7bcf8891ba284b14cb7ebf8dd3d -->
    Loom-Trace-Id: 6eca4b0c47205457aae7a3d721c17f17
    Loom-Build: unknown b591c8cf436f0d4aa5870a9bc7cd5f7194e0e778 dirty
    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
2026-10-07 chore: resync installed Loom surfaces
    <!-- loom:provenance v1 build=unknown b551219fd5b8347113c0cbc79ea416e81c39fa9d clean prompts=none sweep=none story=none trace=5ac7c8c62dad54841e21dd94f0920de3 host=loom-worker-2 base=2e848a0902eabfd2b0545f292559121cf044c727 run=loom-run/v1:timer:loom-worker-2/fleet-resync:d10fb10789e94930ab1af368c15a8f8b installs=0.19.864 128a7eba2bb5f7bcf8891ba284b14cb7ebf8dd3d -->
    Loom-Trace-Id: 5ac7c8c62dad54841e21dd94f0920de3
    Loom-Build: unknown b551219fd5b8347113c0cbc79ea416e81c39fa9d clean
    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
2026-10-07 chore: resync installed Loom surfaces
    <!-- loom:provenance v1 build=unknown 90fbd167e4e376894396e651676cf58fc9aa223a clean prompts=none sweep=none story=none trace=196876656e912171b28029ceca9f772d host=loom-worker-1 base=821619c7399045ebff08b253848bec1f766fb24d run=loom-run/v1:timer:loom-worker-1/fleet-resync:7b46720ff3a84a8184f2f2b3bc039260 installs=0.19.868 ee904e1c151bc9cf15b0eb55dfe9d57ad6136cff -->
    Loom-Trace-Id: 196876656e912171b28029ceca9f772d
    Loom-Build: unknown 90fbd167e4e376894396e651676cf58fc9aa223a clean
    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
2026-10-08 chore: resync installed Loom surfaces
    <!-- loom:provenance v1 build=unknown 5a3df331a0612dee585ef905015af01d08e3467f clean prompts=none sweep=none story=none trace=5690fa95febe608e500a46dde8a6ee92 host=loom-worker-2 base=6400468ef7d8d0190879cfdf8e8b6f8128f6fb79 run=loom-run/v1:timer:loom-worker-2/fleet-resync:5c9c35d59b704bff9d8bf096ee7ba7be installs=0.19.876 b16d54e63fbbec4d7f15f13c1f43a5e5b38145ce -->
    Loom-Trace-Id: 5690fa95febe608e500a46dde8a6ee92
    Loom-Build: unknown 5a3df331a0612dee585ef905015af01d08e3467f clean
    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
2026-10-08 chore: resync installed Loom surfaces
    <!-- loom:provenance v1 build=unknown 134eb3ff06c1a86f49a911c6c17464f55e719736 clean prompts=none sweep=none story=none trace=c7df110d490314040dcd1347b2481843 host=loom-worker-1 base=c5d363ce600020e0f260f62b0617e2bcb3f90504 run=loom-run/v1:timer:loom-worker-1/fleet-resync:53d0cec2cd61484eb9a0f8fb1f24ac5e installs=0.19.879 c15619905bdd8a24506c3853f45490d26e8f1cad -->
    Loom-Trace-Id: c7df110d490314040dcd1347b2481843
    Loom-Build: unknown 134eb3ff06c1a86f49a911c6c17464f55e719736 clean
    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
2026-10-08 chore: resync installed Loom surfaces
    <!-- loom:provenance v1 build=unknown 8f86de23319d8f6cf049557dcc9cf2e321211d9d clean prompts=none sweep=none story=none trace=17de45f778fbfd714af8afad02c96375 host=loom-worker-3 base=7688683196ffbfdabdb1ecf02a1d4582fc264676 run=loom-run/v1:timer:loom-worker-3/fleet-resync:9e3e5d4a08824de3b7bc02940be2a0da installs=0.19.882 c9f85af3d967986cdd7a3f27e088a16f88712b05 -->
    Loom-Trace-Id: 17de45f778fbfd714af8afad02c96375
    Loom-Build: unknown 8f86de23319d8f6cf049557dcc9cf2e321211d9d clean
    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
2026-10-08 chore: resync installed Loom surfaces
    <!-- loom:provenance v1 build=unknown 4a5fb2b6276e17ff26ee1382acfe2ea7360ebea5 clean prompts=none sweep=none story=none trace=67857e1b7189785825a2dfc70921cf85 host=loom-worker-2 base=9827b88a221af997effac24eb1fd763e5e1f5872 run=loom-run/v1:timer:loom-worker-2/fleet-resync:dd6a5f3dceff4d8d8602a07a1dc89c95 installs=0.19.892 ce93e8a919d79a6f027bab268846a52084f9d94e -->
    Loom-Trace-Id: 67857e1b7189785825a2dfc70921cf85
    Loom-Build: unknown 4a5fb2b6276e17ff26ee1382acfe2ea7360ebea5 clean
    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
2026-10-08 chore: resync installed Loom surfaces
    <!-- loom:provenance v1 build=unknown b591c8cf436f0d4aa5870a9bc7cd5f7194e0e778 dirty prompts=none sweep=none story=none trace=28e7ca5fdb768489aa38bf002407d5a5 host=robb-pro base=f00321b9ed055abdc3e06f14b0607884a53cf92a run=loom-run/v1:timer:robb-pro/fleet-resync:eb5f838e-a774-4e20-8102-c37ee3ff31ca installs=0.19.895 9b30d293bcba1e79d49cabfc1c5bb5b6f4c0dc77 -->
    Loom-Trace-Id: 28e7ca5fdb768489aa38bf002407d5a5
    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
2026-10-08 chore: resync installed Loom surfaces
    <!-- loom:provenance v1 build=unknown 5684fc8c8ac418d95ad66a002d001eaea1283c9a clean prompts=none sweep=none story=none trace=c864acd3b9a5dbb419fddd8bd2a6283b host=loom-worker-3 base=3bce3335004f7d499ec92e502550c600d1b7426c run=loom-run/v1:timer:loom-worker-3/fleet-resync:4771e7c630c34445b7f28539669d76e3 installs=0.19.898 3d55b9a1669c132d130d98f10a292c1325322c30 -->
    Loom-Trace-Id: c864acd3b9a5dbb419fddd8bd2a6283b
    Loom-Build: unknown 5684fc8c8ac418d95ad66a002d001eaea1283c9a clean
    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
2026-10-08 chore: resync installed Loom surfaces
    <!-- loom:provenance v1 build=unknown 04a1189116c7320def7d9ce357d2d9268405ae92 clean prompts=none sweep=none story=none trace=8e55b27fc60ffb045554bd413ad8f3c8 host=robb-pro base=c326ccf766510b22880735b25a9dc5114654b823 run=loom-run/v1:timer:robb-pro/fleet-resync:83b69005-7c5b-44b3-96f8-33f07bf82f4b installs=0.19.917 d3c1ea3a4c81e01ce5487dc3e4bbdd86534e677e -->
    Loom-Trace-Id: 8e55b27fc60ffb045554bd413ad8f3c8
    Loom-Build: unknown 04a1189116c7320def7d9ce357d2d9268405ae92 clean
    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
2026-10-08 docs: add block-level characterization report (#31)
    Loom-Story: 2AMLogic/sky130-temp-por#31
    Loom-Trace-Id: 64aafb10caa9171cf2c5652828d064bb
    Loom-Build: 0.19.895 9b30d293bcba1e79d49cabfc1c5bb5b6f4c0dc77 clean
2026-10-08 docs: tidy wording in characterization report
    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
2026-10-08 bias_core: wire all cross-block nets on met3-met5, reach LVS match (#81)
    Bump the klt pin to klayout-tools main @ 0ce8c64842d9 (contains
    klayout-tools#2738's metal4/metal5/metal6 = met3/met4/met5 routing roles)
    and wire the ten remaining bias_core cross-block nets (pg, pb, n2, na,
    nbtop, VREF, nokx, ec, er, nb) by a hand-made layer plan recorded in
    layout/bias_core/README.md.
    Evidence (klt 0.6.0+g0ce8c64842d9, all via layout/bin/compose-cell.py):
    - bias_core: DRC clean (0), extract 50 devices / 27 nets, LVS match
    50/50 devices, 27/27 nets (was 21/50, 14/27); --check exit 0
    - six sub-blocks: --check exit 0; passives LVS mismatch -> match (6/6,
    11/11) because compose-cell.py now passes th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
2026-10-08 chore: resync installed Loom surfaces
    <!-- loom:provenance v1 build=unknown d2a55ce217b3ad1793611a2c54946676bb55b512 clean prompts=none sweep=none story=none trace=459637e4e8503593bdf58360865a7524 host=robb-pro base=025d9f472387cabd5d7ca9b064d999bd7acb6564 run=loom-run/v1:timer:robb-pro/fleet-resync:95b3cf92-9cd9-4c36-8bbd-bdcace7c3874 installs=0.19.935 d347079cd0bad2db2c11ee4f0b760f04b2601d21 -->
    Loom-Trace-Id: 459637e4e8503593bdf58360865a7524
    Loom-Build: unknown d2a55ce217b3ad1793611a2c54946676bb55b512 clean
    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
2026-10-08 layout: por_comparator leaf cell (21 devices), DRC clean, LVS match (#82)
    Lay out design/netlist/por_comparator.spice with the compose-cell recipe:
    18 g5v0d10v5 MOS (diff pair and mirror load as two-unit dummy-flanked
    mos_arrays) and 3 straight res_xhigh_po bodies at their exact netlist L.
    klt (pinned 0ce8c64842d9): drc clean, extract 21 devices / 15 nets, lvs
    match 21/21 devices 15/15 nets (resistor L/W compared via
    compare_parameters; R is a placeholder and not verified). --check exits 0.
    Item 2 stays unmet; manifests/README.md item-2 text updated only.
    Loom-Story: 2AMLogic/sky130-temp-por#82
    Loom-Trace-Id: ef6137759a0cf13ee44c0978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
2026-10-09 layout: por_output_chain leaf cell (28 MOS + 5 MiM), DRC clean, LVS match minus native XMASSIST (#97)
    Native-Vt XMASSIST cannot be drawn or compared by klt (klayout-tools#2912):
    excluded from layout and generated LVS reference, disclosed in README.
    compose-cell.py: lvs.expand_multiplier, continuation-aware drop_prefixes.
    Loom-Story: 2AMLogic/sky130-temp-por#97
    Loom-Trace-Id: c98a14e4efdc94e0ba6f584e652fef3f
    Loom-Build: 0.19.868 ee904e1c151bc9cf15b0eb55dfe9d57ad6136cff clean
2026-10-09 sim: supply-ramp-top campaign for assembled temp_por_top across rates and PVT (#98)
    Loom-Story: 2AMLogic/sky130-temp-por#98
    Loom-Trace-Id: 09028c292be9866676713141c8690c77
    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
    [tb_temp_por_ramp.sch]
2026-10-09 chore: resync installed Loom surfaces
    <!-- loom:provenance v1 build=unknown 05dba463c5b293d38f0ca071725983862498b3f3 clean prompts=none sweep=none story=none trace=14298316053024bcf5120bff695771ab host=robb-pro base=4be3d33768b4dcca6c3ebfae73def23aa9184e5d run=loom-run/v1:timer:robb-pro/fleet-resync:2f384483-6d77-4ba2-9888-aa1e4b5be36c installs=0.19.953 b93d7a955d63411cb4c94b986fd5138d27dedb0f -->
    Loom-Trace-Id: 14298316053024bcf5120bff695771ab
    Loom-Build: unknown 05dba463c5b293d38f0ca071725983862498b3f3 clean
    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
2026-10-09 ci: add self-checks workflow for fast deterministic harness/evidence checks (#103)
    Loom-Story: 2AMLogic/sky130-temp-por#103
    Loom-Trace-Id: 691726ac5c55d0b562d3392118847764
    Loom-Build: 0.19.950 72047016af9d66c08f900bb94c642a66dfd75fc5 clean
2026-10-09 sim: add por-comparator-thresholds campaign (testbenches, runner, extractor) for #102
    Loom-Story: 2AMLogic/sky130-temp-por#102
    Loom-Trace-Id: dd7b0de10da0ce12caf9449f5e45a77c
    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
    [tb_por_comparator_thresholds.sch, tb_por_comparator_thresholds_realbias.sch]
2026-10-09 sim(por-comparator-thresholds): lower primary sweep rate to 100 V/s (rate-lag pilot)
    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
2026-10-09 fix(por_output_chain): XMN1 L=25 W=0.5 -> L=20 W=0.42, a legal nfet_g5v0d10v5 model bin (#101)
    Loom-Story: 2AMLogic/sky130-temp-por#101
    Loom-Trace-Id: fd1a98ae8326109e520bb3054b68bd3f
    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
    [por_output_chain.sch]
2026-10-09 sim(por-comparator-thresholds): passive-skew axis, unguarded-row grading, record fixes
    - add an `--axis passive-skew` run mode (ll/hh x 3 temperatures, tt MOS):
    klt passes a bare process string straight to `.lib`, so the resistor
    skew sections that move xhigh_po are reachable; recorded separately,
    never merged with the 5x3 MOS table. Corrects the absent-coverage line
    that said klt exposed tt/ss/ff/sf/fs only.
    - a row whose half-rate guard waveform is missing is now UNGUARDED and
    excluded from the binding set (was silently OK).
    - record: supply pdk.lib_file (render_pdk_tools_repo_state needs it) and
    render the fleet-submit-time repo state alongside the record-time one.
    Co-Authore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
2026-10-09 layout: add temp_core leaf cell, DRC clean and LVS match 48/48 (#104)
    Lay out the whole .subckt temp_core of design/netlist/temp_core.spice as a
    compose-cell leaf: 33 per-device mos_array blocks with tap islands (XMI1/XMI2
    in their own NT n-well), five straight res_array resistors, a cap_array MiM,
    XQ8A..XQ8H reused from layout/bias_core_pnp8_leg, and XQ1 as a closed-ring
    bjt_array stage. Signal nets are a two-layer channel route (met1 verticals,
    met2 tracks) joined at hand-made jct_m1.gds junction blocks, because a
    gen-compose leg cannot change plane at a waypoint (klayout-tools#2930).
    At the pinned klt 0.6.0+g0ce8c64842d9: klt drc clean (0 violations), klt
    extract 48 devices / 24 nets, kl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
2026-10-09 sim(por-comparator-thresholds): ideal-bias 5x3 record (fleet run at 5e78ab3)
    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
2026-10-09 sim(por-comparator-thresholds): real-bias-core 5x3 record (fleet run at 5e78ab3)
    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
2026-10-09 sim(supply-ramp-top): as-drawn record after XMN1 fix; batch refused by fleet capacity, local single-corner probe passes (#101)
    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
2026-10-09 sim(por-comparator-thresholds): record per-request submit commit and stderr launch refusals
    A retried fleet request runs at the retry's (clean) commit, not run.json's;
    the record now lists the submit commit per request. Launch refusals that
    klt writes to stderr (empty stdout) are now recorded verbatim instead of
    'unparseable report'.
    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
2026-10-09 sim(por-comparator-thresholds): ideal-bias ll/hh passive-skew record
    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
2026-10-09 sim(por-comparator-thresholds): real-bias-core ll/hh passive-skew record
    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
2026-10-09 docs(sim): por-comparator-thresholds README (cold start, bias treatment, binding corners, margin) and campaign row
    Closes #102 acceptance: cold-start invocation, IBIAS/VREF/BIAS_OK treatment
    per variant, POR_RAW polarity and edge-resolution definitions, binding-
    corner tables for both variants and the ll/hh supplement, margin vs the
    DR-001 2.97 V rail, and the fleet-friction note (klayout-tools#2917).
    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
2026-10-09 refactor(sim): hoist duplicated campaign-runner helpers into sim_common (#114)
    say/rate_tag/scrub/report_usable/submit_request now live in sim_common.py;
    the [submit] point count is caller-supplied. Request/netlist/report shapes
    unchanged.
    Loom-Story: 2AMLogic/sky130-temp-por#114
    Loom-Trace-Id: c2caa4f3252b9c04acc3f702d6b1f67e
    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
2026-10-09 chore: resync installed Loom surfaces
    <!-- loom:provenance v1 build=unknown 7f06b288b150f2fe0a4b24c331a9b3ec093d709d clean prompts=none sweep=none story=none trace=a90c217ff3a3bd9e3a30282b8cadc24d host=robb-pro base=20400a9e439f0ea069a7cb48c130634ef829bedc run=loom-run/v1:timer:robb-pro/fleet-resync:6e5ec9f3-d6ef-4953-80f7-c93035e2d359 installs=0.19.967 cc9c6cf61d1aebc3153cd1588ca304445a6b9ced -->
    Loom-Trace-Id: a90c217ff3a3bd9e3a30282b8cadc24d
    Loom-Build: unknown 7f06b288b150f2fe0a4b24c331a9b3ec093d709d clean
    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
2026-10-09 docs: update work log and current work plan
2026-10-09 sim: record fleet refusal of the as-drawn supply-ramp re-run (#101)
    Loom-Build: 0.19.972 113c7f31d7d16f75d30c470023e0b65b29b1fe94 clean
    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
2026-10-09 chore: resync installed Loom surfaces
    <!-- loom:provenance v1 build=unknown 30c7a7ee2f74a6a2b5bb0f19fd9f049ec8ae8b5c clean prompts=none sweep=none story=none trace=7bc5ba399ff199d049d83d711920a157 host=robb-pro base=927ab0df09751fd29f8980a9aa7cbe9a27ba9d17 run=loom-run/v1:timer:robb-pro/fleet-resync:8e237160-c4d0-4ce3-85ac-c96aff5cf221 installs=0.19.982 2bc4cba624b9053535663441e6f0daf08a7acf2e -->
    Loom-Trace-Id: 7bc5ba399ff199d049d83d711920a157
    Loom-Build: unknown 30c7a7ee2f74a6a2b5bb0f19fd9f049ec8ae8b5c clean
    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
2026-10-09 sim(iq-top): assembled temp_por_top Iq campaign driver, testbenches, checker (#107)
    Loom-Story: 2AMLogic/sky130-temp-por#107
    Loom-Trace-Id: 641b684a26741de356789bf99e12c8cf
    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
    [tb_temp_por_iq_por.sch, tb_temp_por_iq_total.sch]
2026-10-09 sim(iq-top): checker selftest record (#107)
    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
2026-10-09 sim(iq-top): fix crosscheck text aggregation, note temp-iq sign (#107)
    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
2026-10-09 sim(iq-top): record 20261009-191705-df85523, fleet batch Iq grid (#107)
    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
2026-10-09 docs(readme): align ratification-status statements with DR-003 (#85)
    Loom-Story: 2AMLogic/sky130-temp-por#85
    Loom-Trace-Id: 97afeb1ff1dae1f22659c17dd9a3fc54
    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
2026-10-09 docs: refresh characterization report, add citation-coverage CI check (#122)
    Loom-Story: 2AMLogic/sky130-temp-por#122
    Loom-Trace-Id: d179ea1b10ef8bb809b978ecb27719e0
    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
2026-10-09 docs(spec): DR-004 proposed sky130 VPOR/hysteresis/ramp recommendation (#123)
    Loom-Story: 2AMLogic/sky130-temp-por#123
    Loom-Trace-Id: f47d7318fbae89e8f2e56ca093b5d939
    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
2026-10-09 docs(spec): spec/README.md decision-records bullet reflects DR-003 ratified (#127)
    Loom-Story: 2AMLogic/sky130-temp-por#127
    Loom-Trace-Id: a95e601f682634439e4c0f8050c6515a
    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
2026-10-09 docs(spec): DR-005 proposed temp_buffer scope and PTAT/CTAT load assumption (#125)
    Loom-Story: 2AMLogic/sky130-temp-por#125
    Loom-Trace-Id: 9db46b498864047af42ba1cfc1aa0c8b
    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
2026-10-09 fix(iq-top): reject non-finite and malformed waveforms before grading (#133)
    Loom-Story: 2AMLogic/sky130-temp-por#133
    Loom-Trace-Id: 44ff103e907b5f5ee14fe6be752f2716
    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
2026-10-09 fix(iq-top): discriminating time-weighting selftest, no traces for invalid points (#133)
    Address Judge review on PR #135:
    - iq_checker selftest: add weighted_wave(), a piecewise-linear current on a
    non-uniform grid (dense where it ramps) with an exact trapezoid mean
    I0*(1+0.75a). The grade must equal it to 1e-9 and must differ from the
    arithmetic sample mean by >0.1%. Replacing tmean with sum(y)/len(y) now
    fails the selftest.
    - run_iq_campaign.analyze_state: skip decimating/writing traces for points
    graded invalid_input, so NaN/Infinity tokens never reach the trace JSON.
    - test_campaign_isolation.py (stdlib unittest, no SPICE, temp dir only): one
    good, one ragged and one NaN wav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
2026-10-09 docs(spec): DR-006 proposed recommendation for Iq rows TBD-4/5/6 (#136)
    Loom-Story: 2AMLogic/sky130-temp-por#136
    Loom-Trace-Id: 57e7cbda1b518574858c3027339d119c
    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
2026-10-10 feat(pex): klt extract/pex artifacts for por_comparator and post-layout campaign variants (#124)
    Loom-Story: 2AMLogic/sky130-temp-por#124
    Loom-Trace-Id: df0b515ef838fdba24b7aa9c8a6aee0c
    Loom-Build: 0.19.996 0d2be7e9ae05753e2c9232a83b7399d45de5396e clean
2026-10-10 feat(sim): postlayout_delta.py delta-table tool (#124)
    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
2026-10-10 feat(sim): post-layout por_comparator threshold records and delta table (#124)
    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
2026-10-10 chore: resync installed Loom surfaces
    <!-- loom:provenance v1 build=unknown a7d2b01d8eb7d09e597a4638e5cb3cdd8bab9156 clean prompts=none sweep=none story=none trace=35c1337ee84607e87ba2038523d63198 host=robb-pro base=fbd6329d79d199e95ffbdfb0dad989beb05798bb run=loom-run/v1:timer:robb-pro/fleet-resync:6bf32a81-6c4a-48c5-a51e-1ad65c6bedfd installs=0.19.1001 1c1131220b2f5950fe54b7cd02ebd3f1aae488dd -->
    Loom-Trace-Id: 35c1337ee84607e87ba2038523d63198
    Loom-Build: unknown a7d2b01d8eb7d09e597a4638e5cb3cdd8bab9156 clean
    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
2026-10-10 sim(supply-ramp-top): as-drawn 360-point fleet campaign after XMN1 fix (#101)
    All 8 requests ran on the Spot batch fleet; no model-bin error.
    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
2026-10-10 feat(bias_core): declare nwell->VDD tie, disclose p_substrate; item 11 met (#90)
    Loom-Story: 2AMLogic/sky130-temp-por#90
    Loom-Trace-Id: c4362c5ba678a66bc8c4e4c0d2ffaf8b
    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
2026-10-10 feat(census): fail on cross-net island merges, gate unpromoted-sibling fallback, three-state frame check (#92)
    Loom-Story: 2AMLogic/sky130-temp-por#92
    Loom-Trace-Id: b6afa430907370e012d761998ba8de0b
    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
2026-10-10 refactor(sim): consolidate klt_version/load_manifest/load_wave into sim_common (#140)
    Loom-Story: 2AMLogic/sky130-temp-por#140
    Loom-Trace-Id: 2d5d2743a41c720100bc38c9a1aca20c
    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
2026-10-10 sim(temp-core-startup-solver): solver/ramp discrimination sweep driver (#86)
    Loom-Story: 2AMLogic/sky130-temp-por#86
    Loom-Trace-Id: 7725174d1d9c8835142b01d4d3c4d1ac
    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
2026-10-10 chore: resync installed Loom surfaces
    <!-- loom:provenance v1 build=unknown c156f673e072832aaacb4cd1ec65b742e7f45867 clean prompts=none sweep=none story=none trace=9de99c124c651049199abe9a75070dc7 host=robb-pro base=9322fcea26d4c56bcbd288830a7afb16362893a4 run=loom-run/v1:timer:robb-pro/fleet-resync:f790885c-7154-4b3d-acd9-71fd537cd20b installs=0.19.1010 d1d5fcecb79550fe39658555a4419f98cec060fb -->
    Loom-Trace-Id: 9de99c124c651049199abe9a75070dc7
    Loom-Build: unknown c156f673e072832aaacb4cd1ec65b742e7f45867 clean
    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
2026-10-10 chore: resync installed Loom surfaces
    <!-- loom:provenance v1 build=unknown 52f79668bb5f93c1828b7f1ea4f7013b917b847b clean prompts=none sweep=none story=none trace=7057f3175071f1f6e34b354fab40a0ce host=robb-studio base=f23303a568ab66ad4cae3de9477124ff73e72231 run=loom-run/v1:timer:robb-studio/fleet-resync:d8918779-1625-4202-b151-71f64465e8cd installs=0.19.1010 d1d5fcecb79550fe39658555a4419f98cec060fb -->
    Loom-Trace-Id: 7057f3175071f1f6e34b354fab40a0ce
    Loom-Build: unknown 52f79668bb5f93c1828b7f1ea4f7013b917b847b clean
    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
2026-10-10 sim: solver/ramp discrimination sweep of temp_core cold-start FAILs (#86)
    Adds the record stage to the sweep driver and the first append-only record
    (5 of 10 combos ran; 5 refused by the fleet with batch_no_capacity). Updates
    the characterization report E5a/E5b and adds E5c.
    Loom-Build: 0.19.1009 8889f7bd1eccfb4bc8239e7f5669b65f9815c30e clean
    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
2026-10-10 sim: solver sweep record generator states only what the run supports
    Per Judge review on #149: compute cross-variant checks per scenario and
    report 'not assessed' when only one variant ran; list PVT corners that
    fail in more than one combo (incl. cross-scenario repeats) instead of
    claiming none do; add the caveat that the base deck re-expresses the
    supply source; mark partial coverage. A --resume run now appends to
    run.json instead of overwriting the original provenance.
    Refs #86
    Loom-Build: 0.19.1009 8889f7bd1eccfb4bc8239e7f5669b65f9815c30e clean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
2026-10-10 sim: regenerate solver sweep record with resumed combo and corrected wording
    Resubmitted the five fleet-refused combos once via run --resume on the
    batch fleet: en-delayed x ramp2m ran (job klt-sim-28ebb30bb384); the
    other four were refused again (batch_no_capacity) and stay NOT-RUN.
    Nothing was run locally.
    The record is regenerated from the fixed generator as
    20261010-100955-292949a. It replaces the unmerged
    20261010-095316-292949a from this PR, which never reached main. It now
    reports cross-variant checks only where at least two variants ran and
    lists the three cross-scenario repeats (tt_-40c_3.63v, ff_-40c_3.63v,
    fs_-40c_2.97v). It also states that every variant re-expresses the
    supply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
2026-10-10 sim: re-assertion diagnosis driver, manifest matrix and verdict-rule tests (#142)
    Loom-Story: 2AMLogic/sky130-temp-por#142
    Loom-Trace-Id: 43e4fdf5c7d471b463add35df395ebfa
    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
2026-10-10 sim: extend re-assertion diagnosis matrix (post-hoc, disclosed) and keep violation onsets in the event order (#142)
    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
2026-10-10 sim: bound the diagnosis trace size (#142)
    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
2026-10-10 sim: ordering summary and disclosure in the diagnosis record (#142)
    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
2026-10-10 sim: append re-assertion diagnosis record and characterization-report entry (#142)
    Both exact points (ss/-40C/3.63V/500kV/s, fs/27C/2.97V/5kV/s) re-assert only on
    nonphysical solver branches; physical-branch runs release once. Exploratory,
    no ratified ramp envelope.
    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
2026-10-10 sim: brown-out campaign scaffolding for the assembled temp_por_top (#116)
    Manifest, three-axis (+recovery) stimulus testbench, waveform checker with
    synthetic cases, fleet runner/recorder, tests and cold-start README.
    Loom-Story: 2AMLogic/sky130-temp-por#116
    Loom-Trace-Id: 958f7733634556864802db0e28c0b7f3
    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
    [tb_temp_por_brownout.sch]
2026-10-10 sim: re-grade committed brown-out fixtures from disk in the tests (#116)
    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
2026-10-10 sim: cut brown-out campaign cost after the first fleet attempt timed out (#116)
    Power-up 100 kV/s, 10 ms baseline/observation windows, two falling slews,
    21 requests / 945 points, looser-but-bounded tmax, 7200 s batch timeout.
    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
2026-10-10 chore: resync installed Loom surfaces
    <!-- loom:provenance v1 build=unknown 525fe43b7b1b2a0271084bba444c934a1541a8d8 clean prompts=none sweep=none story=none trace=0d4424bd058cf912b74934ec0e7bf37e host=robb-pro base=3926f46ae63f86833128f9c0c2229ebef3a9e863 run=loom-run/v1:timer:robb-pro/fleet-resync:4812047c-8b9b-4da2-a5dc-13e6f6420a04 installs=0.19.1018 13e54f1cfc513507a7ef84ec6908085638d9c187 -->
    Loom-Trace-Id: 0d4424bd058cf912b74934ec0e7bf37e
    Loom-Build: unknown 525fe43b7b1b2a0271084bba444c934a1541a8d8 clean
    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
2026-10-10 chore: resync installed Loom surfaces
    <!-- loom:provenance v1 build=unknown 525fe43b7b1b2a0271084bba444c934a1541a8d8 clean prompts=none sweep=none story=none trace=d4059def94f46d8d158946acddd4d602 host=robb-studio base=d87789a730231a1d003248fde849769ea79e5030 run=loom-run/v1:timer:robb-studio/fleet-resync:4a4d1995-968e-44c5-b5fe-804b4d477795 installs=0.19.1019 febfc4335d0554865fadbecba718245cd88c6678 -->
    Loom-Trace-Id: d4059def94f46d8d158946acddd4d602
    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
2026-10-10 sim: record-stage provenance and --supersedes for the solver sweep (#86)
2026-10-10 sim: record NONPHYSICAL onset phase (pre-dip vs post-dip) and supply-current reversal in the brown-out checker (#116)
    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
2026-10-10 sim: add temp-core-accuracy-mc campaign runner, experiment and README (#105)
    Loom-Story: 2AMLogic/sky130-temp-por#105
    Loom-Trace-Id: c6188f7bedcf88e04e36e110e283ad09
    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
2026-10-10 chore: resync installed Loom surfaces
    <!-- loom:provenance v1 build=unknown 5d5f41d89eef35adf478b92b96af06c6d86d27a6 clean prompts=none sweep=none story=none trace=05d2a40831b35ba1c48afada00c29519 host=robb-pro base=1fcc6c7e3e5e92cd2c4a9300bd99a2323460d1e0 run=loom-run/v1:timer:robb-pro/fleet-resync:c58bb82e-a213-439d-b829-04234e141de9 installs=0.19.1028 48ce8a23fdab3059d078e9fffca79e4d4c911d60 -->
    Loom-Trace-Id: 05d2a40831b35ba1c48afada00c29519
    Loom-Build: unknown 5d5f41d89eef35adf478b92b96af06c6d86d27a6 clean
    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
2026-10-10 sim: separate simulation vs grading source SHA in brownout records; refuse dirty or deck-drifted grading (#116)
    The fleet2 grid was submitted from bcf00bf; the checker changed afterwards.
    Records now state both commits, verify each submitted netlist's sha256 against
    the fleet report, and refuse to grade if deck inputs differ between the two.
    Self-test fixtures are written with gzip mtime=0 so a self-test run never
    dirties the tree.
    Loom-Build: 0.19.1026 09a449709f5a1c6ae81b471ef56d466247e50808 clean
    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
2026-10-10 sim: brownout-top fleet2 record (945/945 graded) and fleet1 timeout record (#116)
    945 declared points graded from the fleet2 grid (simulated at bcf00bf, 21 jobs,
    all 45-corner reports retrieved): PASS 267, FAIL 5, NONPHYSICAL 673,
    ERROR 0, UNRESOLVED 0, NOT_COVERED 0. NONPHYSICAL dominates (default solver
    tolerances; follow-up #153). The fleet1 timeout record documents the first,
    abandoned submission (jobs klt-sim-63cf5157178b, klt-sim-415f0ec31ec1).
    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
2026-10-10 sim: brownout-top checker self-test record and README results index (#116)
    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
2026-10-10 docs: cite brownout-top record in characterization report (E11) (#116)
    Adds E11 for sim/brownout-top/records/20261010-222529-41bde9f.md:
    267 PASS / 5 FAIL / 0 ERROR / 673 NONPHYSICAL / 0 UNRESOLVED /
    0 NOT_COVERED, exploratory and not a ratified bound. NONPHYSICAL
    points are unknown, not passing, pending the #153 re-run. Updates the
    coverage table, supply-ramp row and gaps summary to match. Docs only.
    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
2026-10-10 sim: temp-core-accuracy-mc runner, testbench template and manifest (#105)
    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
2026-10-10 chore: resync installed Loom surfaces
    <!-- loom:provenance v1 build=unknown aa536103d6239818bb974a51d2f7f268eff38bad clean prompts=none sweep=none story=none trace=126a1328a3664e2119a0978086db9bea host=robb-studio base=090412d8f58c5afa3ff92d8fd0572646a2781c29 run=loom-run/v1:timer:robb-studio/fleet-resync:fbc4e361-e290-4d81-ae3a-8b5fde796815 installs=0.19.1032 13ca937a7d6ba8768c296b0c126f2ce48f5f7ca4 -->
    Loom-Trace-Id: 126a1328a3664e2119a0978086db9bea
    Loom-Build: unknown aa536103d6239818bb974a51d2f7f268eff38bad clean
    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
2026-10-10 sim: temp-core-accuracy-mc README, sim/README pointer, nominal fallback reference (#105)
    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
2026-10-11 sim: temp-core-accuracy-mc chunk extension groups, per-sample timeout, archive timed-out attempts (#105)
    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
2026-10-11 ci: gate brown-out checker synthetic verdict cases in self-checks
    Closes #156
    Loom-Story: 2AMLogic/sky130-temp-por#156
    Loom-Trace-Id: ccb2b2ff1903ef84a5230a9469a00ade
    Loom-Build: 0.19.1039 e83d19dc0a9b217339ea2f14040c50ad6f46700d clean
2026-10-11 feat(iq-top): solver-sensitivity harness for natural-release iq-total (#160)
    Loom-Story: 2AMLogic/sky130-temp-por#160
    Loom-Trace-Id: f32736c0446eb4066725c60ec11ab3cd
    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
2026-10-11 chore: resync installed Loom surfaces
    <!-- loom:provenance v1 build=unknown cf08873555e2eb95da295dcbee98b0dc34473381 clean prompts=none sweep=none story=none trace=67fbc483c3ca3e442d7928804c11ff06 host=robb-pro base=4515fc7173d04caaa7bc8403828d1454a9429a25 run=loom-run/v1:timer:robb-pro/fleet-resync:e3f97888-2b26-404a-bd47-86fd28a4eced installs=0.19.1041 b65c266b47d796bf37d1c04c6f616be0bc699056 -->
    Loom-Trace-Id: 67fbc483c3ca3e442d7928804c11ff06
    Loom-Build: unknown cf08873555e2eb95da295dcbee98b0dc34473381 clean
    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
2026-10-11 feat(iq-top): split-by-process fleet resubmission for variants exceeding the per-job ceiling (#160)
    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
2026-10-11 fix(iq-top): split resubmission does not skip a variant whose whole-grid report is all-error (#160)
    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
2026-10-11 chore: resync installed Loom surfaces
    <!-- loom:provenance v1 build=unknown e91831edf7b55b29d3a2d88e266916fab9ce2563 clean prompts=none sweep=none story=none trace=f72dd67520a2c3802aa0495b80ac65a5 host=robb-studio base=b58280d932de1d036cb735ce86323d1aba34e0a6 run=loom-run/v1:timer:robb-studio/fleet-resync:91d2434e-eae5-45de-9305-d78c43fc7c7a installs=0.19.1043 1f414afc0388fba3ddd4b792d653b22230c33389 -->
    Loom-Trace-Id: f72dd67520a2c3802aa0495b80ac65a5
    Loom-Build: unknown e91831edf7b55b29d3a2d88e266916fab9ce2563 clean
    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
2026-10-11 docs(iq-top): README section for the solver-sensitivity replicate (#160)
    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
2026-10-11 feat(iq-top): --process selects split resubmissions (fleet capacity refusal retry) (#160)
    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
2026-10-11 sim: split temp-core-accuracy-mc into per-process fleet requests (fleet job 1h limit), N=30 (#105)
    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
2026-10-11 docs(iq-top): record first-attempt diagnostic and resubmission provenance (#160)
    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
2026-10-11 sim: retry fleet launches refused by the shared instance cap (#105)
    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
2026-10-11 feat(iq-top): append-only solver-sensitivity record for natural-release iq-total (#160)
    Full 45-point grid x {baseline, trtol7, reltol2e-4} via the batch fleet; baseline
    reproduces the original record exactly; trtol7/reltol2e-4 incomplete from fleet
    timeouts (explicit unknowns). Characterization report E12 added.
    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
2026-10-11 ci: export GITHUB_EVENT_BEFORE for the append-only records check (#162)
    The push-event baseline reads GITHUB_EVENT_BEFORE, which GitHub does not
    export as a runner variable; without this the check exits 2 on pushes to main.
    Loom-Story: 2AMLogic/sky130-temp-por#162
    Loom-Trace-Id: 576da2aed7536d2595b529f02959608f
    Loom-Build: 0.19.1050 abf3f7109328fd66ec77827f5fd849f5279fee82 clean
2026-10-11 chore: resync installed Loom surfaces
    <!-- loom:provenance v1 build=unknown 5ec729b9f7dd55a2082752611e4c4964f49661fb clean prompts=none sweep=none story=none trace=efc2abc8b72538df6d1a6ea9d329603d host=robb-pro base=846e57ac5b76cc409492aff10c9e8abfe579cae3 run=loom-run/v1:timer:robb-pro/fleet-resync:0d396c06-f26e-423e-97ac-6d3ac04a8e51 installs=0.19.1056 4e44d8f5faa6c6c58d2a3436ce3a983613cf375a -->
    Loom-Trace-Id: efc2abc8b72538df6d1a6ea9d329603d
    Loom-Build: unknown 5ec729b9f7dd55a2082752611e4c4964f49661fb clean
    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
2026-10-11 chore: resync installed Loom surfaces
    <!-- loom:provenance v1 build=unknown 745f69d0daad6c23e76cc006720fa4fbeaa3d887 clean prompts=none sweep=none story=none trace=3baabc4a039fd85029fff227a6ae690a host=robb-studio base=50a308e87b465de57f9135710cea8d9635727cb2 run=loom-run/v1:timer:robb-studio/fleet-resync:3b3207d7-055d-49b5-a387-db375213668d installs=0.19.1060 b3904db8717caa5f324b5fdc0c27b2e5ebdc1986 -->
    Loom-Trace-Id: 3baabc4a039fd85029fff227a6ae690a
    Loom-Build: unknown 745f69d0daad6c23e76cc006720fa4fbeaa3d887 clean
    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
2026-10-11 ci: protect snapshots and corner evidence as append-only (#165)
    Loom-Story: 2AMLogic/sky130-temp-por#165
    Loom-Trace-Id: c0fdd297c08de826f2317053291f54be
    Loom-Build: 0.19.1065 33bb950d65b9038d5cf119a252820edca1192edf clean
2026-10-11 ci: fix invalid YAML in self-checks step name (#165)
    An unquoted 'corners: add' in a step name made the workflow unparseable.
    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
2026-10-11 feat(sim): glitch-top manifest, checker, testbench and campaign driver (#117)
    Loom-Story: 2AMLogic/sky130-temp-por#117
    Loom-Trace-Id: 39df99e414840fd63e95bae80e520a7f
    Loom-Build: 0.19.1068 fcc4454e112d13e088464bb0a178b75c0dc96c0f clean
2026-10-11 fix(sim): document RINJ current sign (#117)
    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
2026-10-11 test+docs(sim): glitch-top unit tests, fixtures, README, CI step (#117)
    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
2026-10-11 sim: temp-core-accuracy-mc record 20261011-165400-69d13ac (N=30, 15 PVT corners, fleet) (#105)
    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
2026-10-11 sim: temp-core-accuracy-mc branch-consistency guard + with/without headline (#105)
    Adds an operating-point guard on the per-sample spread of V(NA)-V(NB)
    across -40/27/125 C (0.5 mV): a DC solution on another branch at one
    temperature breaks loop closure there only, which the absolute windows
    and three-point monotonic check could not see. record now reports the
    headline with and without the newly excluded samples, lists them, runs a
    secondary 27 C off-chord scan, records the grading SHA, and replaces the
    boilerplate NOT-RUN bullet with a concrete limit.
    Loom-Trace-Id: c6188f7bedcf88e04e36e110e283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
2026-10-11 sim: temp-core-accuracy-mc record 20261011-165907-69d13ac supersedes 20261011-165400-69d13ac (#105)
    Re-grade of the same 36 fleet jobs (no new simulation) with the
    branch-consistency guard. 4 suspected single-temperature DC branch jumps
    (other tt/3.30 #3, other fs/3.63 #26, all tt/3.30 #3, all sf/3.30 #10)
    are excluded and disclosed. All-terms 3 sigma: untrimmed worst 77.38
    (pooled 64.31), 1-pt trim worst 22.76 (pooled 19.91) degC; with the
    suspect samples 77.38/64.20 and 35.73/19.89. DR-003 row 2 still missed.
    The superseded record is untouched. Cites the campaign as E13 in the
    characterization report (fixes the self-checks coverage failure).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
2026-10-11 fix(sim): glitch-top attribute points from the submitted netlist and keep tmax strictly tighter than the sample-gap limit (#117)
    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
2026-10-11 sim: brownout-top declares reltol2e-4 solver variant with tightened-deck rerun comparison (#153)
    - experiment.json: solver_variants (default / reltol2e-4) and tightened_rerun
    predeclared before the run -- rerun set, unchanged physicality bounds, cost
    rule and control policy.
    - run_brownout_campaign.py: --variant on run/probe/record; variant options are
    appended to the testbench's single declared .options line and refused
    anywhere else; run.json snapshots the variant and retries refuse to mix
    variants; record --compare-source joins the source default-deck record
    per point (refuses broken joins either way) and renders the transition
    matrix, target/control accounting and per-point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
2026-10-11 sim: brownout-top run subparser accepts --variant (#153)
    cmd_run already read args.variant but the run subparser never declared the
    flag, so every tightened-deck submission died at argument parsing. Declares
    it and pins it with a dispatch test.
    Loom-Story: 2AMLogic/sky130-temp-por#153
    Loom-Trace-Id: 2f09f57e8f71a1e9ce3c7da50cb0ab4c
    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
2026-10-11 sim: glitch-top checker-selftest record (#117)
    Loom-Build: 0.19.1071 dcab8265613676d08b763cddc911b93c7ab7d9d4 clean
    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
2026-10-11 chore: resync installed Loom surfaces
    <!-- loom:provenance v1 build=unknown b37a005ac1889262fb9e5338f7cff4e9ed4987da clean prompts=none sweep=none story=none trace=25c158d7e9591610b251780caaff1c5f host=robb-pro base=d071037525591d04a48f2462f8d5e6a0cf62e21b run=loom-run/v1:timer:robb-pro/fleet-resync:7f020bca-6920-47f7-a5e4-bbd5c82d9bb8 installs=0.19.1072 29b48db1ead9c4501304e0114a5c33310e1d589f -->
    Loom-Trace-Id: 25c158d7e9591610b251780caaff1c5f
    Loom-Build: unknown b37a005ac1889262fb9e5338f7cff4e9ed4987da clean
    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
2026-10-11 sim: glitch-top retry fleet launches refused by the shared instance cap (#117)
    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
2026-10-11 chore: resync installed Loom surfaces
    <!-- loom:provenance v1 build=unknown 81a6b4499cb57b3620785bc1625c300da34f0735 clean prompts=none sweep=none story=none trace=d08bbd290651d7bcbda8b216c0dfbcdf host=robb-studio base=f8b3ed481a980be33e7bdeab4030187bec468daa run=loom-run/v1:timer:robb-studio/fleet-resync:71e05e3d-931c-46b4-b6d2-5f3f992c1e19 installs=0.19.1073 abb0872ba7d1d3f6f3a14f71f51a562e89308181 -->
    Loom-Trace-Id: d08bbd290651d7bcbda8b216c0dfbcdf
    Loom-Build: unknown 81a6b4499cb57b3620785bc1625c300da34f0735 clean
    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
2026-10-11 sim: brownout-top #153 rerun accounting, rerun-set enforcement and pilot cost projection
    - experiment.json: predeclare tightened_rerun.rerun_tags (all 21 requests:
    673 targets + 272 controls), pilot_tags and job_limit_s before any
    tightened submission.
    - run: a tightened run is restricted to the declared rerun tags; continuing a
    run (--retry-failed) refuses deck drift since the first submit and records
    per-batch source/klt provenance.
    - cost: project every rerun request's tightened fleet time from pilot
    reports (worst observed ratio) against the per-job limit; projections are
    snapshotted with the record.
    - record: a tightened-variant record always compares against the declared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
2026-10-11 sim: brownout-top run --slot-wait resubmits fleet concurrency-cap refusals (#153)
    The first tightened pilot submissions were refused immediately by the shared
    fleet's BATCH_MAX_CONCURRENT_INSTANCES=8 cap; klt's capacity_wait_s does not
    wait that refusal out (2AMLogic/klayout-tools#2917). run --slot-wait/--slot-poll
    resubmit such a request until the budget is spent. Every refusal is archived as
    an earlier attempt and stays in the record's refusal accounting. Later submit
    batches into one run are listed with their source commits in the record.
    Loom-B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
2026-10-11 sim: brownout-top reads klt's stderr error envelope for refusals (#153)
    klt writes its --format json error envelope to stderr and leaves stdout empty,
    so --slot-wait never recognised the concurrency-cap refusal and archived
    attempts were listed as "unparseable report". Both now read klt.stderr when
    report.json carries no envelope.
    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
2026-10-11 docs: refresh completion log and current work plan
2026-10-11 sim: brownout-top cost marks timed-out pilots as lower bounds; probe takes one declared corner (#153)
    Both tightened pilot jobs hit the fleet's whole-job limit, and klt discarded
    every corner. Their elapsed ratio is therefore only a lower bound, so the
    projection is labelled that way and drops the corner-sum ratio. cost --limit-s
    projects against the limit the harness actually enforced (recorded with
    --limit-note). probe --process/--temp/--supply runs ONE declared corner
    locally, for single-corner timing of a slow PVT point.
    Loom-Build: 0.19.1071 d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
2026-10-11 sim: brownout-top probe --fleet-equivalent omits ngspice_init for like-for-like timing (#153)
    The fleet runner ignores options.ngspice_init, so fleet decks run with
    ngspice's default SPARSE solver and without the repo spiceinit (klu, hsa). A
    local probe that carries spiceinit therefore times a different solve.
    --fleet-equivalent runs ONE declared corner the way the fleet does.
    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
2026-10-11 sim: brownout-top comparison counts ERROR controls as ungraded, not changed (#153)
    A control whose tightened job hit the fleet limit has no waveform, so it has
    no verdict to compare. It is now counted beside NOT_COVERED, never as a
    changed (or agreeing) verdict.
    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
2026-10-11 sim: brownout-top record marks timed-out pilot ratios as lower bounds (#153)
    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
2026-10-11 sim: brownout-top #153 tightened-solver pilot record (both pilots hit the 3600 s fleet limit)
    Companion of 20261010-222529-41bde9f, which is unchanged. The pilot requests
    control and cube_v1.2_h0.0001_f50000_r10000 (reltol2e-4) ran as jobs
    klt-sim-c3ba332c37d3 and klt-sim-fd2409da90fb. Both hit the harness's enforced
    3600 s whole-job limit, and klt discarded every corner. Each request had been
    refused 5 times at the shared fleet's BATCH_MAX_CONCURRENT_INSTANCES cap
    before it launched. Following the declared cost rule, the other 19 requests
    were not submitted.
    Totals: ERROR 90, NOT_COVERED 855. The per-point comparison covers all 945
    points. The cost projection is a lower bound (x>=8.0 elaps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
2026-10-11 sim: brownout-top declares reltol2e-4-klu rerun variant and the enforced 3600 s job limit (#153)
    The reltol2e-4 SPARSE pilots both hit the runner-enforced 3600 s whole-job
    limit (the runner ignores the request's options.timeout_s=7200), so no
    tightened point was graded. Pre-declared decision, before any submission
    under the new variant: carry klu on the declared .options line (the fleet
    runner ignores ngspice_init; sim/spiceinit selects KLU locally), keeping the
    #150-derived reltol=2e-4 and whole-request granularity. One corner per job,
    a longer job limit and a looser tolerance are rejected in the manifest.
    tightened_rerun.job_limit_s now records the observed 3600 s ceiling. The
    record captu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
2026-10-11 sim: share waveform primitives and gzip row writer via sim_common (#170)
    Move interp_cross, crossings(t_from), interp_at, schmitt(init_high, t_from)
    and the gzip trace row writer into sim/bin/sim_common.py; ramp and brown-out
    checkers import them. Grading, compress() and transitions_from_stored() stay
    local. Adds parity tests against frozen copies of the old implementations.
    Loom-Story: 2AMLogic/sky130-temp-por#170
    Loom-Trace-Id: 6a91c531f2072c05a5e2153a0d6c883e
    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
2026-10-12 chore: resync installed Loom surfaces
    <!-- loom:provenance v1 build=unknown ddfb67ccf9a5115d62dd86924613a468b9328f44 clean prompts=none sweep=none story=none trace=772605234b9d8cafd6a4049200f7425c host=robb-pro base=2d158ede5b957cd1e9e4412b74298f95ad991869 run=loom-run/v1:timer:robb-pro/fleet-resync:1ef28ffc-0277-424f-9224-7ee6eca46377 installs=0.19.1083 77a174ea7fcaddbb25d0082956cd25d8633fc2df -->
    Loom-Trace-Id: 772605234b9d8cafd6a4049200f7425c
    Loom-Build: unknown ddfb67ccf9a5115d62dd86924613a468b9328f44 clean
    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
2026-10-12 chore: resync installed Loom surfaces
    <!-- loom:provenance v1 build=unknown be358990895362019614bd207bcbe36bc9eeff2c clean prompts=none sweep=none story=none trace=f1dc643b95859c8f26e892ddb5e2c5d7 host=robb-studio base=551b5e34c57f49421a8df0e64ae5c070fb4b8d99 run=loom-run/v1:timer:robb-studio/fleet-resync:da486ca2-3e94-4a85-abd3-88707942489a installs=0.19.1087 51ac271f990b317a52ebf27cc21f34561e1179fb -->
    Loom-Trace-Id: f1dc643b95859c8f26e892ddb5e2c5d7
    Loom-Build: unknown be358990895362019614bd207bcbe36bc9eeff2c clean
    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
2026-10-12 chore: resync installed Loom surfaces
    <!-- loom:provenance v1 build=unknown a579728c137cc11d08a48b178e0ff9aa21683e72 clean prompts=none sweep=none story=none trace=3bf998139b24cf65d1c2b90af6a12450 host=loom-worker-3 base=4b01bccb05712301b89e14f03bc62a210e14e134 run=loom-run/v1:timer:loom-worker-3/fleet-resync:5b8ee6fae8b4401a862c5e98cad72b45 installs=0.19.1087 51ac271f990b317a52ebf27cc21f34561e1179fb -->
    Loom-Trace-Id: 3bf998139b24cf65d1c2b90af6a12450
    Loom-Build: unknown a579728c137cc11d08a48b178e0ff9aa21683e72 clean
    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
2026-10-12 chore: resync installed Loom surfaces
    <!-- loom:provenance v1 build=unknown 02ecafe7734bf5faa945ce88940589f00eca78e9 clean prompts=none sweep=none story=none trace=5f71c537126994dc4c45179122427514 host=robb-pro base=76ae2a525266e4915adcc81c0a240089ce8ad33b run=loom-run/v1:timer:robb-pro/fleet-resync:6293e6da-8a67-45aa-b277-c9ef85ddb810 installs=0.19.1101 27422582cd2d34d8ed5f60ce987007bc4bd61081 -->
    Loom-Trace-Id: 5f71c537126994dc4c45179122427514
    Loom-Build: unknown 02ecafe7734bf5faa945ce88940589f00eca78e9 clean
    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
2026-10-12 chore: resync installed Loom surfaces
    <!-- loom:provenance v1 build=unknown 24e88efb2654d92588617d2e0681d2ceba48990d clean prompts=none sweep=none story=none trace=9ff02282641e95f0266bab1c719ccf6d host=loom-worker-3 base=e8f00a7dcc43acba7765873711016046c41764a6 run=loom-run/v1:timer:loom-worker-3/fleet-resync:616e7cf481ff483ea62a90e9c8640d85 installs=0.19.1104 ded8b3776e361563cf636d3a439737715c13b6d5 -->
    Loom-Trace-Id: 9ff02282641e95f0266bab1c719ccf6d
    Loom-Build: unknown 24e88efb2654d92588617d2e0681d2ceba48990d clean
    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
2026-10-12 chore: resync installed Loom surfaces
    <!-- loom:provenance v1 build=unknown 9885e6bbba36f53328e04be83140734c6eda9f58 clean prompts=none sweep=none story=none trace=72f34c4066d6ca844a10c33035a775bd host=loom-worker-1 base=c55993525c30e65604970be1c1d0822f5170890a run=loom-run/v1:timer:loom-worker-1/fleet-resync:8f5732bc51fd43379e17e0de51e86bae installs=0.19.1108 72427939d156341080a7006ae6fbb5ec96b2368e -->
    Loom-Trace-Id: 72f34c4066d6ca844a10c33035a775bd
    Loom-Build: unknown 9885e6bbba36f53328e04be83140734c6eda9f58 clean
    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
2026-10-12 chore: resync installed Loom surfaces
    <!-- loom:provenance v1 build=unknown 01467247f32c59822968bf02d3214d9a3d613452 clean prompts=none sweep=none story=none trace=0e97e9733eef09a33959cf96e6271f40 host=robb-studio base=4c8393486ded833aff5e630f73afe14ddf2ea5d7 run=loom-run/v1:timer:robb-studio/fleet-resync:53a4d390-3842-4216-9018-5dced9d0ea17 installs=0.19.1109 d9498fcd419776b2517e30b99c88e76bbe92d2f4 -->
    Loom-Trace-Id: 0e97e9733eef09a33959cf96e6271f40
    Loom-Build: unknown 01467247f32c59822968bf02d3214d9a3d613452 clean
    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
2026-10-12 sim: glitch-top fleet campaign records for both glitch classes (#117)
    Loom-Build: 0.19.1081 6966a93d1cd1b005f2a6b22bf9691ade8793ed73 clean
    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
2026-10-12 sim: glitch-top selftest stubs resolve_pdk so record tests are hermetic on CI (#117)
    cmd_record resolves the host PDK only to stamp provenance; CI runners have
    no PDK, so the two record tests raised HarnessError. Patch cr.resolve_pdk
    with a fixed stand-in, as the brownout selftest does.
    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
2026-10-12 docs: cite glitch-top records in the characterization report (E14) (#117)
    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
2026-10-12 chore: resync installed Loom surfaces
    <!-- loom:provenance v1 build=unknown 6d6a81bfd0d38dff3dfe3cc6d08965f57d71ab67 clean prompts=none sweep=none story=none trace=53e704452fd9a4802b952dbffcec3017 host=loom-worker-3 base=5b2dce209aaf6d3a482fe8951027ab2b246fd703 run=loom-run/v1:timer:loom-worker-3/fleet-resync:da09a55781444da6865c7c3d6fcf7edb installs=0.19.1126 7736d1276b6d01778fba3461114c858ef1bf5e2d -->
    Loom-Trace-Id: 53e704452fd9a4802b952dbffcec3017
    Loom-Build: unknown 6d6a81bfd0d38dff3dfe3cc6d08965f57d71ab67 clean
    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
2026-10-12 chore: resync installed Loom surfaces
    <!-- loom:provenance v1 build=unknown 8d832cc8035d4ba07872510416468da0790332cd clean prompts=none sweep=none story=none trace=09a53bf60e96fc30a753caffd1de8c92 host=robb-studio base=2ef5e13ac148340353a7824751f935a4b4df31f7 run=loom-run/v1:timer:robb-studio/fleet-resync:baf4c30c-65d9-4d4e-a740-f6a80cbb975c installs=0.19.1133 fd7af6d7adbad876821d49bff2c70c871f54b60c -->
    Loom-Trace-Id: 09a53bf60e96fc30a753caffd1de8c92
    Loom-Build: unknown 8d832cc8035d4ba07872510416468da0790332cd clean
    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
2026-10-12 chore: resync installed Loom surfaces
    <!-- loom:provenance v1 build=unknown a70d97503da52b2d8e12a12bd0cf829303808e95 clean prompts=none sweep=none story=none trace=e0715eac024f885e71456a622107e8bc host=loom-worker-3 base=c183e5cbf0419f94054ef88905ac86deec22a9eb run=loom-run/v1:timer:loom-worker-3/fleet-resync:39a9339322d146b1984885e3f76b3e03 installs=0.19.1142 b91ae5d1b5204f499a1abb875a6cf5bffc1d90b1 -->
    Loom-Trace-Id: e0715eac024f885e71456a622107e8bc
    Loom-Build: unknown a70d97503da52b2d8e12a12bd0cf829303808e95 clean
    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
2026-10-12 chore: resync installed Loom surfaces
    <!-- loom:provenance v1 build=unknown 8b64614d017d6ce7491c3a2ac9da51e5e2901c97 clean prompts=none sweep=none story=none trace=66044c049ba635bcd6a4797c3a77e84b host=robb-pro base=25a5086b860f99aecda471d7a277578b03a1c6b6 run=loom-run/v1:timer:robb-pro/fleet-resync:68f56594-05d0-4cc0-9c07-36263359d698 installs=0.19.1144 9e4381cbbd2386393e44c7a979583252948a3998 -->
    Loom-Trace-Id: 66044c049ba635bcd6a4797c3a77e84b
    Loom-Build: unknown 8b64614d017d6ce7491c3a2ac9da51e5e2901c97 clean
    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
2026-10-13 chore: resync installed Loom surfaces
    <!-- loom:provenance v1 build=unknown e66f00108a9519331aa981da8a01c6569ca623a9 clean prompts=none sweep=none story=none trace=d3e476cf8c03d5ed37f8e146b3632190 host=robb-studio base=7c5724c4806a2105af2dbd40dd4055e4b0d2eb08 run=loom-run/v1:timer:robb-studio/fleet-resync:1d7ace45-2daf-4c92-a752-67b11e982245 installs=0.19.1147 7ea3495e453d43e23efdd9673642fd4de42cd4cc -->
    Loom-Trace-Id: d3e476cf8c03d5ed37f8e146b3632190
    Loom-Build: unknown e66f00108a9519331aa981da8a01c6569ca623a9 clean
    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
2026-10-13 chore: resync installed Loom surfaces
    <!-- loom:provenance v1 build=unknown cbff4fbf837b06d41a17f2d2e23be806c19ce1df clean prompts=none sweep=none story=none trace=0cd5805094761c972dc958d4a2d69777 host=loom-worker-3 base=97188372fb85892e684f478cc487d3ba10667fda run=loom-run/v1:timer:loom-worker-3/fleet-resync:0837bf6b93294c70ad9d20ea2eaefc57 installs=0.19.1148 1448fdfa79ac2dcab7fad6b95b72697b450f2a4a -->
    Loom-Trace-Id: 0cd5805094761c972dc958d4a2d69777
    Loom-Build: unknown cbff4fbf837b06d41a17f2d2e23be806c19ce1df clean
    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
2026-10-13 chore: resync installed Loom surfaces
    <!-- loom:provenance v1 build=unknown d0bfbbc7ac309581d7abe02c4a269c7704010ee0 clean prompts=none sweep=none story=none trace=0ad6d167235000f3b5648cbd63d761ce host=robb-pro base=406dedc4a3b07a0904a9af14855a9215750c5e02 run=loom-run/v1:timer:robb-pro/fleet-resync:4f7cbe22-40b6-49ff-8811-003ae8577c28 installs=0.19.1151 021b947d121929157cd83df0576e7f2aa12500d7 -->
    Loom-Trace-Id: 0ad6d167235000f3b5648cbd63d761ce
    Loom-Build: unknown d0bfbbc7ac309581d7abe02c4a269c7704010ee0 clean
    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
2026-10-13 chore: resync installed Loom surfaces
    <!-- loom:provenance v1 build=unknown 7916c4043a1b57e97a53bc5c111e74c5038a1091 clean prompts=none sweep=none story=none trace=a48d70df8e7252b46c71b88e90ebed02 host=loom-worker-3 base=416af0557397a1e81ba6c2a92172cd1263682759 run=loom-run/v1:timer:loom-worker-3/fleet-resync:08e4e415b6434bf1ba0456ba59477467 installs=0.19.1151 f7d1deaab02a9c483fce1ced33fadb1af6d86f59 -->
    Loom-Trace-Id: a48d70df8e7252b46c71b88e90ebed02
    Loom-Build: unknown 7916c4043a1b57e97a53bc5c111e74c5038a1091 clean
    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
2026-10-13 chore: resync installed Loom surfaces
    <!-- loom:provenance v1 build=unknown ac0bbcf6eda99918e88a0b8893d9762b106a2e45 clean prompts=none sweep=none story=none trace=8597ab8a51d68f9f8ee864fa71904bff host=robb-studio base=a4149f639a355f087c0b2d1370ddec9372a967ba run=loom-run/v1:timer:robb-studio/fleet-resync:2ea9dd71-a6b2-4d0c-86aa-859a0728c9b3 installs=0.19.1151 f7d1deaab02a9c483fce1ced33fadb1af6d86f59 -->
    Loom-Trace-Id: 8597ab8a51d68f9f8ee864fa71904bff
    Loom-Build: unknown ac0bbcf6eda99918e88a0b8893d9762b106a2e45 clean
    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
2026-10-13 chore: resync installed Loom surfaces
    <!-- loom:provenance v1 build=unknown 7916c4043a1b57e97a53bc5c111e74c5038a1091 clean prompts=none sweep=none story=none trace=773e9e41a5730d2f79f2381ad2cde068 host=robb-pro base=e189b51e319c32324bbd866b508ca61242e533fc run=loom-run/v1:timer:robb-pro/fleet-resync:b7ca0d34-434e-4536-85b9-57adfa603a8d installs=0.19.1151 1ec34f9bb79942506958a3c18a31368f4e065508 -->
    Loom-Trace-Id: 773e9e41a5730d2f79f2381ad2cde068
    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
2026-10-13 chore: resync installed Loom surfaces
    <!-- loom:provenance v1 build=unknown f91cd239df41290ba3efb8bc14320984e3392c6f clean prompts=none sweep=none story=none trace=c1345a24765b7e1c5307ef032fd77486 host=loom-worker-3 base=839c79ff34e22768770dab778505e3ba0ded9044 run=loom-run/v1:timer:loom-worker-3/fleet-resync:c4883600330b4d70afac9e743a4e52e3 installs=0.19.1151 a9d9bfc13e966655d6d847cb6876af523bc4a4c4 -->
    Loom-Trace-Id: c1345a24765b7e1c5307ef032fd77486
    Loom-Build: unknown f91cd239df41290ba3efb8bc14320984e3392c6f clean
    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
2026-10-13 chore: resync installed Loom surfaces
    <!-- loom:provenance v1 build=unknown 6fe43c87955e02019c2bc8dfad4fbd160b89170c clean prompts=none sweep=none story=none trace=49a4590bf54e81899c26d965f682504c host=robb-studio base=ad5858fc87a36c972e7f8e5e1353e0277ad18207 run=loom-run/v1:timer:robb-studio/fleet-resync:459197b3-0050-4335-893e-e47b638eb819 installs=0.19.1151 4bba3857a22eb3081c693ff4c5953e9ffb74072b -->
    Loom-Trace-Id: 49a4590bf54e81899c26d965f682504c
    Loom-Build: unknown 6fe43c87955e02019c2bc8dfad4fbd160b89170c clean
    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
2026-10-13 chore: resync installed Loom surfaces
    <!-- loom:provenance v1 build=unknown 5dc3a07d084d0ec4034f0782d572925dcad86af7 clean prompts=none sweep=none story=none trace=cbc11657acadf58858409fe543c342e1 host=robb-pro base=2a1c08559ce7f2547af8e2f52d8d238b876ed5af run=loom-run/v1:timer:robb-pro/fleet-resync:be586137-d91e-4e2c-82d6-3164d43aa9de installs=0.19.1152 2d5fe17958dca799058f16bdd74a12336990bec0 -->
    Loom-Trace-Id: cbc11657acadf58858409fe543c342e1
    Loom-Build: unknown 5dc3a07d084d0ec4034f0782d572925dcad86af7 clean
    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
2026-10-13 chore: resync installed Loom surfaces
    <!-- loom:provenance v1 build=unknown 27a266d5a27885323290840d2a837d73fcf4bcc6 clean prompts=none sweep=none story=none trace=e77cdd5477ef6bfc65fba6cc233788e0 host=loom-worker-2 base=7bb91310e7f2e60231a29d6cd654887207695fd3 run=loom-run/v1:timer:loom-worker-2/fleet-resync:7fac7d82f298441a91761382ac989183 installs=0.19.1152 8d16eec5f10d705602ac4d1ab871c57266f1aa45 -->
    Loom-Trace-Id: e77cdd5477ef6bfc65fba6cc233788e0
    Loom-Build: unknown 27a266d5a27885323290840d2a837d73fcf4bcc6 clean
    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
2026-10-13 chore: resync installed Loom surfaces
    <!-- loom:provenance v1 build=unknown f2b62a2cf576d7d37092147b2281da809f8b5cf5 clean prompts=none sweep=none story=none trace=8adfa75521c72dded43e2932febb6329 host=loom-worker-3 base=d0036a740e392982f5447a986b9db3b5c5f8db46 run=loom-run/v1:timer:loom-worker-3/fleet-resync:8a8198f8f80e4703bc7365a5e10595e0 installs=0.19.1152 a7c20e591a04d4acaeeca29fadd7fa4be7ca3122 -->
    Loom-Trace-Id: 8adfa75521c72dded43e2932febb6329
    Loom-Build: unknown f2b62a2cf576d7d37092147b2281da809f8b5cf5 clean
    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
2026-10-13 chore: resync installed Loom surfaces
    <!-- loom:provenance v1 build=unknown 84d11f248d368cae5e04a2255f6897a406c50089 clean prompts=none sweep=none story=none trace=8e50b4ccc3dc58f709a732f69d58fd44 host=robb-studio base=eb71ff42bd479883fd67d04d29072a26076bd619 run=loom-run/v1:timer:robb-studio/fleet-resync:05c9f3b1-eee2-412f-8996-5fbf02793d9e installs=0.19.1153 d8429a4fabdc955107af1cbc22c548e23eecf9b1 -->
    Loom-Trace-Id: 8e50b4ccc3dc58f709a732f69d58fd44
    Loom-Build: unknown 84d11f248d368cae5e04a2255f6897a406c50089 clean
    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
2026-10-15 test: add guard reproducer and confinement controls for /tmp-cwd relative writes
    Loom-Story: 2AMLogic/sky130-temp-por#88
    Loom-Trace-Id: cb5168288deebeb0d1315b85e174a39d
    Loom-Build: 0.19.1166 8a9aad12e32504cea9a7c7d2ed774749c487f875 clean
2026-10-15 refactor(layout): retire unused lvs.dependency_variants from compose-cell
    No committed cell recipe declares the option; generated reference bodies for
    every committed recipe are byte-identical before and after. A descriptor that
    still sets the key now fails with a BuildError, documented in the module
    docstring.
    Loom-Story: 2AMLogic/sky130-temp-por#110
    Loom-Trace-Id: 3e1f5a6c537c2f45ac12c8db399a9360
    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
2026-10-17 chore(signoff): bump klt pin to 758c6e224053 and re-render report; item 1 now unmet (wrong_kind)
2026-10-17 fix(pdk): re-pin open_pdks to f6eeac7 via ciel and refuse a mismatched tree
    PDK lookup now resolves PDK_ROOT or ~/.ciel only (no volare probe, no
    second tree to shadow the pin). corner-run.py --print-env and
    design/netlist.py find_pdk() fail when the resolved revision differs from
    sim/pdk.json, naming both revisions and the install command. Adds
    sim/bin/test_pdk_pin.py and wires it into self-checks. design/netlist
    regenerated: the new PDK symbols print nrd/nrs at full precision.
2026-10-17 fix(signoff): refresh item-10 envelope for final workflow hash
    The item-10 inventory lists signoff-manifest.yml, which was edited after
    the envelope was generated. Regenerated with the pinned klt (758c6e2);
    --check returns match. Manifest pin (inventory hash) and signoff-report.json
    are unchanged. Note the self-hash ordering in manifests/README.md.
2026-10-20 refactor(sim): share trace decimation and gz writer across checkers
    Add sim_common.decimate and route the brownout, glitch, ramp and
    reassert-diagnosis compress functions through it; the glitch and
    diagnosis trace writers now call write_gz_rows. Output-preserving:
    compress rows and written trace text are identical to the previous
    implementations on synthetic waveforms.
2026-10-20 fix(design): keep sim/pdk.json pin enforcement ahead of klt netlist; re-attest item 10
    netlist.py resolves the PDK and refuses any revision other than the
    sim/pdk.json pin before calling klt netlist (passing --pdk-root/--pdk), so
    sim/bin/test_pdk_pin.py keeps asserting enforcement. Refresh the item-10
    attestation for the changed inputs.
2026-10-20 fix: refresh item-10 attestation envelope for edited self-checks.yml
    The PDK pin enforcement step added to self-checks.yml changed its content
    hash; regenerate the envelope with the CI-pinned klt (758c6e22). The
    re-rendered signoff report is byte-identical, so it is unchanged.
    Closes #214
2026-10-23 feat(sim): route new corner-run evidence through the fleet artifact store
    Add sim/bin/evidence_store.py (fail-closed preflight, stage, klt artifact
    put, summary), send corner-run logs through it, and add a stdlib CI check
    for artifact manifests (schema, artifact: URIs only, no committed bytes).
    Artifact manifests join the append-only protected set.
2026-10-23 sim: bias-core-smoke record from a real fleet batch submission
    45-corner grid via klt sim --backend batch; all corners pass. The runner's PDK
    stamp is c6d73a35 (previous pin), so the record is flagged MISMATCH vs
    sim/pdk.json (f6eeac7).
    Part of #4
2026-10-23 feat(sim): route the five campaign drivers' evidence through the artifact store
    Each driver preflights the store in run and record, stages per-corner logs,
    traces and fleet reports in git-ignored scratch, stores them with klt
    artifact put, and commits only the manifest and summary. Re-attest item 9
    (driver hashes) and document the flow.
2026-10-23 test(sim): make driver record tests hermetic against the fail-closed evidence store
    cmd_record now calls evidence_store.preflight_or_exit(), so the unit tests that
    call it directly aborted on runners without KLT_ARTIFACT_BROKER. Stub the store
    (no broker, no klt) in the glitch and brownout record tests, and add a test per
    driver that the real preflight still fails closed and leaves no records.
2026-10-23 sim(glitch-top): add subset fleet run record with stored-evidence manifest
    One por_raw_control request (45 PVT points, tt/ss/ff/sf/fs x -40/27/125C x 2.97/3.30/3.63V) run on the batch fleet (job klt-sim-438cf8d051c6), recorded as a subset (360 of 405 points NOT_COVERED). Plumbing check only; klt artifact verify was rate-limited by the broker (HTTP 429) and is not yet confirmed.
    Part of #229
2026-10-23 fix(sim): glitch record skips evidence store for classes with nothing staged
    A --only subset run left one class with every point NOT_COVERED, so the
    store refused an empty manifest and aborted record. The driver now skips
    the store call and snapshot dir for such a class and records null artifact
    links; evidence_store keeps its fail-closed behavior.
2026-10-23 refactor(sim): share record-assembly helpers between brownout and glitch drivers
    Move deck_drift, the request snapshot/scrub loop, submit_failures, the
    dirty-tree/deck-drift guard and the fleet/xschem note text into sim_common.
2026-10-27 feat: assemble temp_por_top GDS from the leaf streams and cite it for T1 item 2
2026-10-27 refactor: build campaign fleet requests through sim_common.base_request
    Moves the models/options/batch scaffolding and MODEL_LIB shared by seven
    campaign drivers into sim_common. Request JSON is byte-identical for every
    driver; accuracy_mc and solver_sweep now accept capacity_wait_s (no-op at 0).
2026-10-27 refactor: hoist probe, append-only guard and spiceinit loader into sim_common
    Single-source the local klt probe run, the sim/ append-only pre-existence
    guard and the spiceinit loader that were copy-pasted across the per-campaign
    sim drivers. Drop the passthrough transitions_from_stored in glitch_checker.
    Guard error text is unchanged.
2026-10-27 chore(klt): bump klayout-tools pin to 0.8.0 and re-render signoff evidence
    Install klayout-tools==0.8.0 from PyPI in the signoff-manifest workflow and
    assert 'klt 0.8.0'; move layout/pdk.json's klt pins to the release (a release
    build reports its tag commit, so check_klt_pin's prefix match still holds);
    update the three cell README install lines; regenerate the self-hashed item-10
    attestation and re-render signoff-report.json (per-item verdicts unchanged).
2026-11-05 ci: run corner-run batch and sim_common waveform tests in self-checks
    Both suites existed but no CI step ran them, so the batch test rotted
    (stub record lacked links.artifact_manifest/artifact_summary). Fix the
    stub, correct the documented invocation, and wire both in.
2026-11-13 docs(glitch-top): correct NONPHYSICAL cause in vdd_slew rerun note
    All 45 rows carry a node-range violation; only 9 show end-of-run supply
    current reversal. Drop the unsupported cross-campaign equivalence.
2026-11-13 refactor(netlist): resolve the PDK through corner-run.py instead of a private copy
    design/netlist.py carried its own PDK-pin resolver (`Pdk`, `load_pdk_pin`,
    `installed_revision`, the body of `find_pdk`) duplicating what
    sim/bin/corner-run.py already exports as `load_pin`/`resolve_pdk`/
    `installed_commit`/`pdk_mismatch_message`. The two had already drifted: the
    netlist copy hardcoded `~/.ciel` and `sky130A` instead of reading
    sim/pdk.json's `default_pdk_root`/`variant`, so editing the pin file changed
    what the sim harness resolved but not what the netlist export resolved.
    `find_pdk()` is now a thin wrapper over the shared resolver, loaded lazily so
    design/check_committed_netlists.py keeps i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
2026-11-13 fix(netlist): strip klt's klt-netlist-inputs provenance line in normalize()
    `klt netlist` 0.9.x prepends a `** klt-netlist-inputs: {...}` comment that
    the committed netlists predate, so `python3 design/netlist.py --check`
    failed on all five cells with that single added line as the only diff.
    The line's presence depends on the klt version and its content names the
    installed `xschem_version`, so committing it would pin
    `design/netlist/*.spice` to one toolchain — at odds with netlist.py's
    byte-identical-on-any-machine promise, and it would invalidate the
    `manifests/attestations/item-1.json` hashes for zero content change. So
    `normalize()` drops it instead, leaving the committed netlists unto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
2026-11-13 refactor(sim): derive each record's fleet/host tool versions instead of hardcoding them
    Seven fleet runners each assembled the record's `pdk` / `tools` provenance block
    inline, and four had drifted into stating a tool version nobody measured:
    - `run_reassert_diagnosis.py` wrote `fleet_ngspice` as the constant
    `"ngspice-46 (per fleet log)"`; the fleet is on ngspice-47.
    - `run_ramp_campaign.py` and `run_iq_campaign.py` labelled their local
    cross-check `ngspice-42` while reading the real host version a few lines
    later, so one record could carry two different host ngspice versions.
    - `run_ramp_campaign.py` named `the 0.5.0 runner` (now 0.9.0) and
    `host xschem is 3.4.4` (now 3.4.7) in it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
2026-11-13 feat(manifests): re-hash attestation.checks[] files so source edits fail CI
    `klt signoff --attest` envelopes record a sha256 for every file their
    inventory lists, but the block manifest pins those envelopes to their
    *inventory* file's hash, never to the attested sources. Nothing in the
    graded chain re-hashed the sources, so editing one left the pin, the
    re-rendered report and the byte-compare all green while the envelope
    described files that no longer existed. Item 1's design/netlist.py was
    stale from 6d11c6ec until #298; 8 of item 9's 40 recorded files were
    stale on main, with no job red.
    Extend check-citations.py rather than adding a workflow step: it already
    walks every cited envelope on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
2026-11-13 fix(sim): drop an unobserved claim from the iq no-waveform record text
    The UNRESOLVED note asserted that a local iq probe "has been stopped
    before finishing" — a general statement written into a record about a
    run nobody will have observed at the point the text is emitted. Reduce
    it to what the branch actually knows: the probe produced no usable
    result for this state.
    Per Judge review note on PR #300.
2026-11-13 feat(manifests): gate items 1 and 9 with klt's own local_only attest check
    The five `python3 design/netlist.py --check` freshness commands (item 1)
    and the `corner-run.py --dry-run` cold start (item 9) need xschem and the
    sky130 PDK, so CI re-attested item 9 only behind a `command -v xschem`
    guard and never re-attested item 1 at all. The pinned klayout-tools 0.8.0
    already handles this: a command spec marked `"local_only": true` is skipped
    by `klt signoff --attest N --check` and reported `[SKIP] … (local_only, not
    run; committed outcome: …)` — never as passed — while every inventoried
    file is still re-hashed and the whole envelope still diffed.
    - mark those commands `local_only` in `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
2026-11-13 fix(manifests): walk list-valued evidence entries and object `file` refs
    `check-citations.py` skipped any evidence entry that was not a citation
    object, so item 11 — the manifest's one list-valued entry, citing
    `erc.json` and `lvs.json` together — contributed 0 of the hash pairs
    while the summary line still printed clean. Nothing went unhashed in
    practice (item 11's `erc.json` pins the same GDS as item 3, and its
    `lvs.json` is item 4's), so the coverage was incidental to two other
    items rather than stated.
    Behind that skip sat a second shape gap: `erc.json`'s top-level `file`
    is the schema-2 object `{"path": ..., "scope": "repo"}`, not a string,
    so merely removing the skip raised `TypeE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
2026-11-13 fix(sim): derive the solver sweep's record PDK/Tools lines from the run
    `run_solver_sweep.py`'s `cmd_record` baked three tool claims into every record
    it wrote: `fleet runner klt 0.5.0`, the Spot instance type `c7i/m7i.4xlarge`,
    and the open_pdks commit `c6d73a35...` with "(matches sim/pdk.json pin)" — the
    last of which is now false, since sim/pdk.json was re-pinned to `f6eeac7d...`
    for #188. A fourth claim, the "(version mismatch warning from the client)"
    parenthetical, was stated unconditionally.
    Two new module-level helpers replace the literals:
    - `observed_provenance()` derives the fleet's runner klt, ngspice engine and
    instance type through `sim_common.joined_versions()` — the s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
2026-11-13 chore(manifests): re-attest item 10 for this PR's self-checks.yml edit
    This PR adds a `test_record_provenance.py` step to
    .github/workflows/self-checks.yml, which item 10's inventory hashes as a
    hygiene file, so the signoff job's `--check` found
    attestation.checks.0.content_hash drifted (committed sha256:3dd570ef…,
    fresh sha256:021266ec…, fresh_status: pass) and exited 3.
    Regenerated the envelope with the pinned klt the committed report was
    rendered with:
    klt signoff --attest 10 --inventory manifests/inventories/item-10.json \
    -o manifests/attestations/item-10.json
    Only the self-checks.yml hash changes; the inventory is untouched, so the
    cited provenance.input.content_hash is un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
2026-11-13 chore(manifests): re-attest items 9 and 10 for this branch's sources
    - item 9: `sim/temp-core-startup-solver/run_solver_sweep.py` changed with the
    runner-PDK fix, so its inventory hash moved.
    - item 10: the `.github/workflows/self-checks.yml` hygiene hash, which the merge
    of origin/main resolved to a content neither side had committed (main renamed
    the citation-checker step label; this branch added the provenance-test step).
    Regenerated with the CI-pinned build (`uvx --from klayout-tools==0.8.0`), exactly
    as manifests/README.md prescribes. Each envelope moves by one `content_hash`
    line; the cold start and pin blocks are unchanged. All three attested items
    (1, 9, 10) re-check `status: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
2026-11-13 fix(sim): derive accuracy-MC record PDK and fleet engine from the run
    `render_md()` stated the open_pdks commit `c6d73a35...` as a literal labelled
    "(sim/pdk.json pin)". That label was wrong twice over: `sim/pdk.json` was
    re-pinned to `f6eeac7d...` for #188, and the literal was never the pin in the
    first place -- it is the *fleet runners'* stamp from the October grids
    (`environment.remote.worker_environment.pdk.stamp_text`). The fleet engine fell
    back to `'?'` rather than the `unknown` convention, and reported only the
    first term's engine.
    Both header lines are now derived from the run's own `report.json` data:
    - `runner_pdk()` reads the stamp of the machine that actually executed a term,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
2026-11-13 chore(manifests): re-attest items 9 and 10 after the runner and CI edits
    Item 9 inventories `sim/temp-core-accuracy-mc/run_accuracy_mc.py` and item 10
    inventories `.github/workflows/self-checks.yml`; both were edited in the
    preceding commit, so their committed envelopes drifted. Re-attested with the
    workflow-pinned klt 0.8.0 in a throwaway uvx environment, which re-ran every
    inventoried hash, item 9's cold start and item 10's six stdlib audits.
    Both are a single `content_hash` line; no tool or PDK pin moved.
    `manifests/check-citations.py` exits 0, all three `--check` runs report
    `status: match`, and the re-rendered signoff report still byte-matches
    `manifests/signoff-report.json`.
    Part of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
2026-11-13 fix(sim): grade the accuracy-MC `none` control three-state so an empty one cannot PASS
    `cmd_record` folded each `none` corner's `max_dev_from_nominal_V` with `or 0.0`.
    `analyse_term` leaves that field `None` when a corner has no valid sample or no
    usable nominal point, so "nothing was compared" became "0 V deviation" and
    `render_md` printed `PASS: exactly the no-mismatch curve`. An all-invalid `none`
    term therefore certified the per-term attribution it exists to police, and
    corners that dropped out of a partially failed run silently left the max. The
    variant-compare path (`cmd_compare`) had the same fold.
    - `none_control()` grades the control PASS / FAIL / NOT VERIFIED: the max is
    taken o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
2026-11-13 refactor(sim): route both crosscheck local probes through run_local_probe
    `cmd_crosscheck` in the ramp and iq campaign runners each inlined the
    single-corner local `klt sim` call that `sim_common.run_local_probe` already
    provides, and the other five runners with a local probe already call. The
    copies had drifted: the ramp crosscheck discarded klt's stderr where the helper
    and the iq copy save it as `klt.stderr` beside the report.
    Future ramp crosscheck directories therefore gain a `klt.stderr` file; no
    committed evidence changes.
2026-11-13 chore(manifests): re-attest items 9 and 10 for this branch's sources
    - item 9: `sim/bin/sim_common.py` and the nine campaign runners are hashed in
    its inventory, and all ten changed with the shared submit bootstrap.
    - item 10: `.github/workflows/self-checks.yml` gained the bootstrap-helper
    test step, and that workflow is hashed in item 10's inventory.
    Regenerated with the CI-pinned build (`uvx --from klayout-tools==0.8.0`) as
    manifests/README.md prescribes. Only `content_hash` lines move — the cold
    start, the audit commands and both pin blocks are unchanged. All three
    attested items (1, 9, 10) re-check `status: match` / `fresh_status: pass`, and
    the re-rendered `klt signoff` report is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
2026-11-13 fix(sim): join fleet PDK/engine over every process job, not the first
    `observed_provenance()` read `ent["report"]["environment"]`, which `load_term()`
    fills from the FIRST usable process section alone. Every mismatch term is one
    fleet job per process section, so a full run is 7 terms x 5 sections + nominal
    = 36 jobs, of which that sampled 8. A runner on a different PDK stamp or engine
    in any non-first section was silently dropped while the header still read "the
    fleet runners that executed the grid reported ...".
    Reproduced with the real `load_term()` on a stubbed run directory: term `pnp`
    with `tt` on ngspice 46 / stamp `aaaa...` and the other four sections on
    ngspice 47 / stamp `bbbb...`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
2026-11-13 fix(sim): grade the accuracy-MC `none` control against the expected corner grid
    `none_control` graded over the keys `analyse_term` handed it. A process section
    whose request produced no usable report is recorded in `missing_procs` and
    contributes no key at all, so its corners arrive absent rather than
    present-with-nothing-compared -- and an absent corner was simply not graded.
    A `none` term that lost a whole process section with every reported corner flat
    therefore rendered **PASS** over "all 12 corners": a max over 12 of the 15
    corners, certifying the switching wrappers on three corners that were never
    simulated. The same argument that made a not-compared corner NOT VERIFIED
    (#310) applies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
2026-11-13 refactor(sim): submit the last two local ngspice grids through klt sim as deck-list requests
    `run_op_branch.py` launched 150 cold `.op` solves four at a time through a
    `ThreadPoolExecutor`, and `run_pnp_mismatch.py` ran its 6 Monte Carlo points
    one after another, both calling `ngspice -b` directly. Neither could be re-run
    from a dispatch worker, where a local ngspice grid is not allowed -- which
    blocked re-running the two experiments whose records are cited evidence
    (characterization report E4 and E7).
    Both now submit their grid as ONE `klt sim` request to the Spot batch fleet and
    never fall back to a local grid: a refusal is reported verbatim and the run ends
    without a record. Removed: `sp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
2026-11-14 feat(sim): derive a three-state fleet-PDK-vs-pin verdict in every runner's record
    Since #328 every fleet record states the open_pdks stamp its *runners* reported;
    no record compared it with the `sim/pdk.json` pin, so four record texts disclosed
    that gap in prose and fell back on local-vs-fleet engine agreement as their only
    evidence that the fleet model library matches the pin.
    `corner-run.py` was the one runner that did compare, so this lifts that mechanism
    into `sim_common` and reaches the other seven through the shared producer:
    - `sim_common` gains `fleet_pdk_commit()` (moved from `corner-run.py`, which now
    re-exports it), `fleet_pin_verdict()`, `fleet_pin_state()` and
    `PIN_COMMIT_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
